Tommy270502/PM3/3_Technical_Documents/PCB/PM3_Audio_and_DMX_Template/PM3_Audio_and_DMX_Template/PM3_Audio_and_DMX_back.jpg

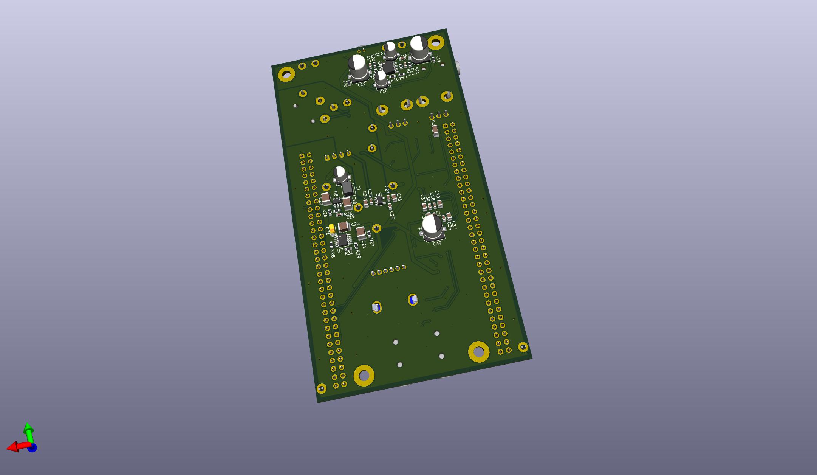
3_Technical_Documents/PCB/PM3_Audio_and_DMX_Template/PM3_Audio_and_DMX_Template/PM3_Audio_and_DMX_back.jpg
