Tommy270502/PM3/2_Assessments/Presentation.pptx

## Audio Processing and Ambient Light Control Device

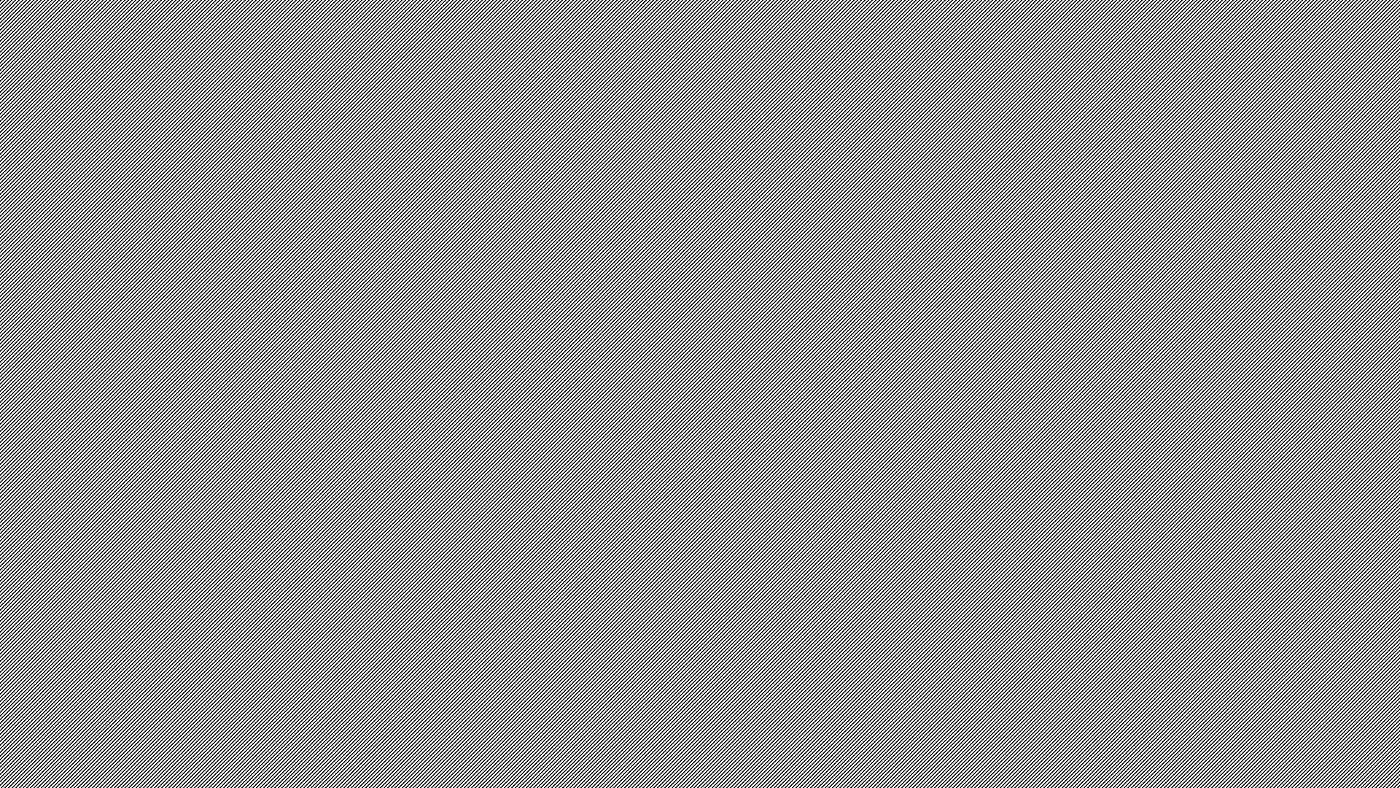
[picture p18: figure]

Bogdans Grebnevs – Thomas S. Perri

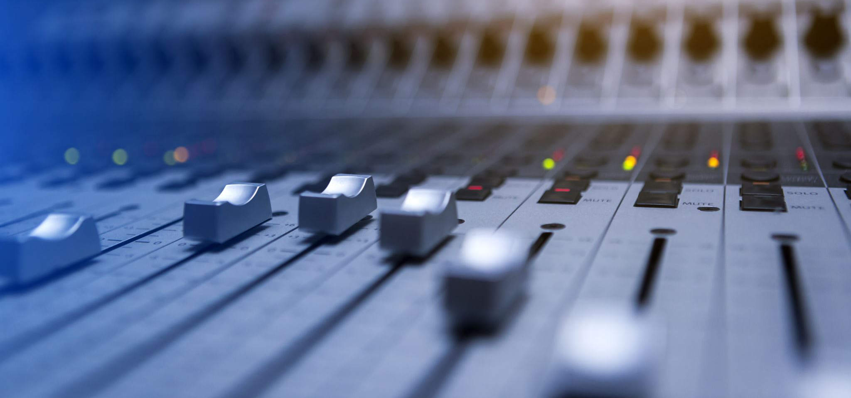
[picture p19: figure]
Audio sound board
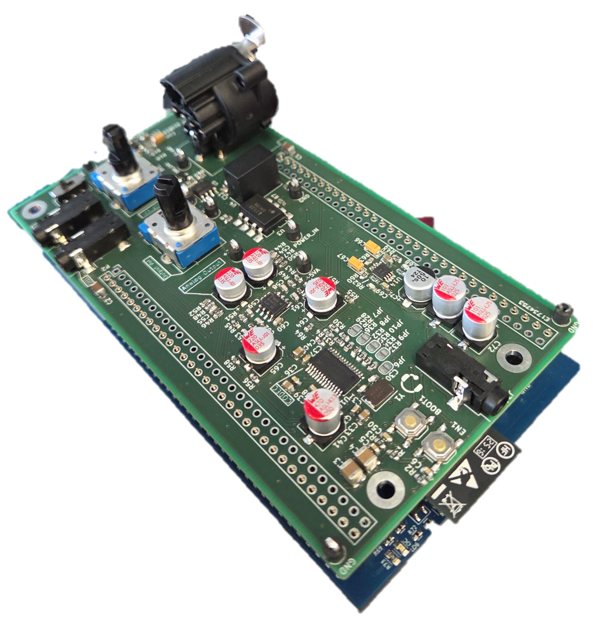
[picture p20: figure]

Notes: One-sentence purpose: A real-time system that processes audio signals, visualizes them, and drives ambient lighting.

## System Overview & Signal Flow

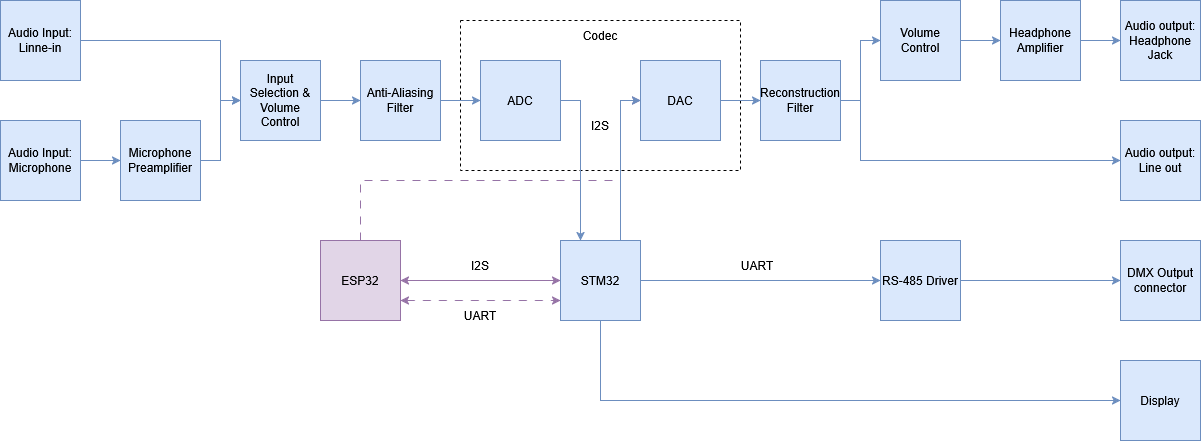
[picture p21: figure]

## Analog Front-End & Output Path

- Anti-aliasing Filter

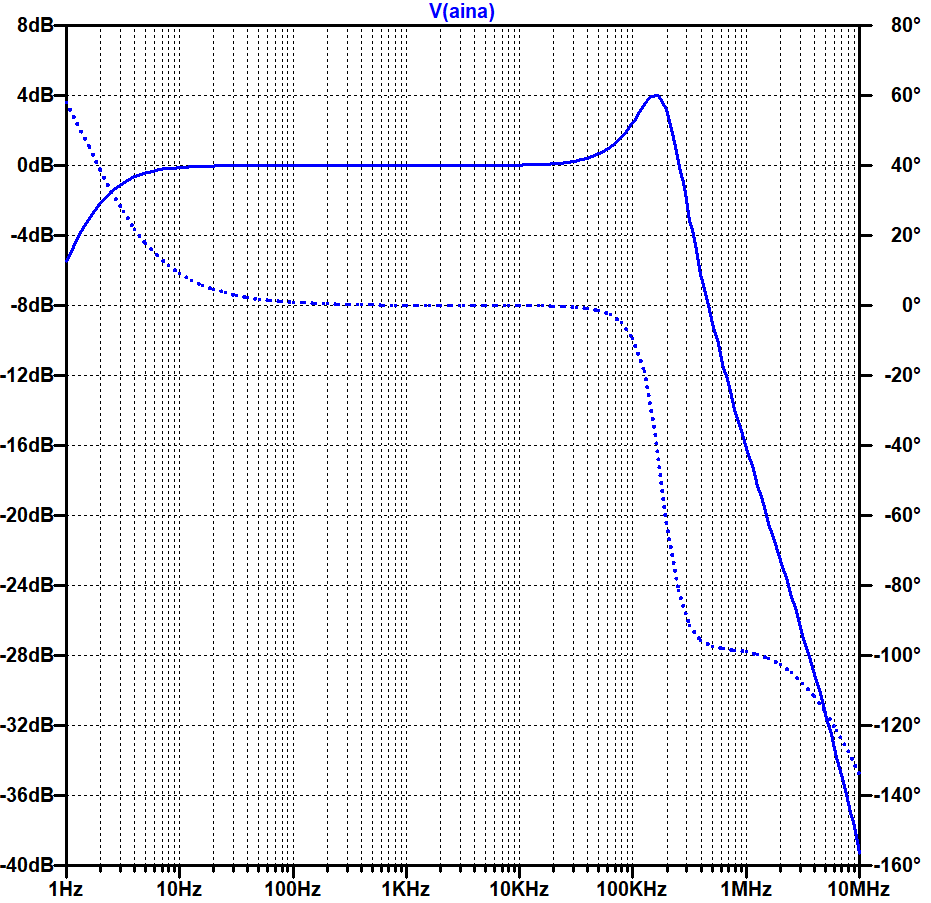
[picture p22: figure]

- Reconstruction Filter

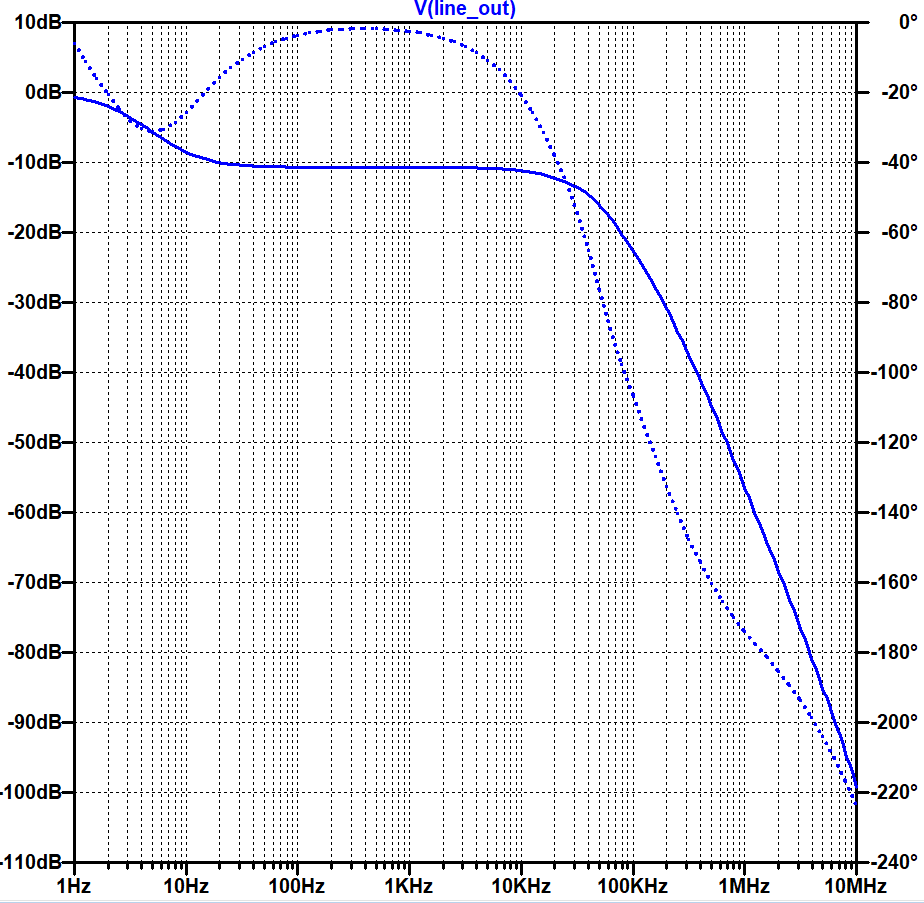
[picture p23: figure]

## Digital Signal Processing & Analysis

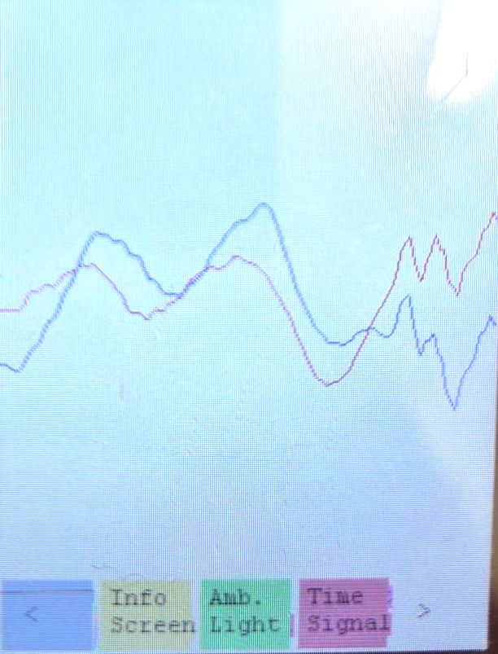
[picture p24: figure]
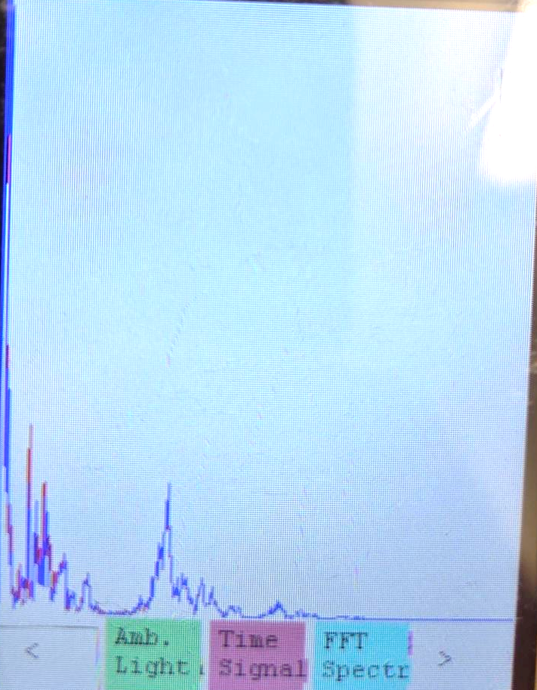
[picture p25: figure]

Notes: Buffer ping pong zeugs

## Ambient Light Control

Freuqency based color selection

0 Hz 250 Hz | 2 kHz | 4 kHz | 20 kHz

Brightness dictated by the RMS value of given frequency bin

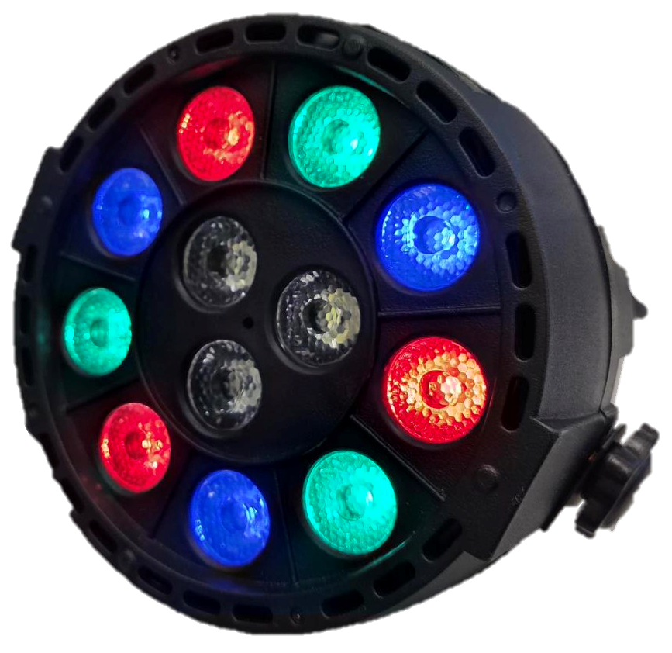
[picture p26: figure]

## Highlight: Audio Effects & Filter Menu

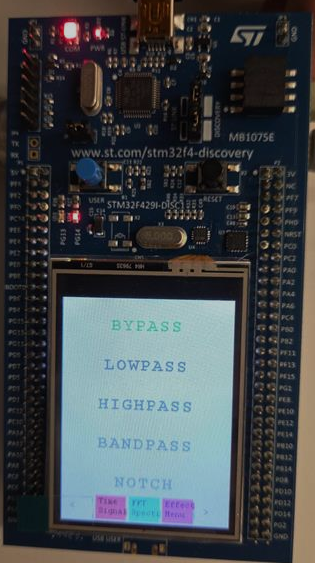
[picture p27: figure]

- Simple audio filters
  - Low-Pass
  - High-Pass
  - Band-Pass
  - Notch
- Select on the fly with the blue user button

## Conclusion

- Failures
  - Schematic capture errors → many wire modifications on PCB
- Learnings
  - Check HW multiple times and take time to review it to avoid having to troubleshoot later during testing
  - Proper layouting techniques and rules for PCBs
  - Improved confidence in firmware development
  - Project management and planning
- Future steps
  - Finish the ESP32 firmware to allow for Bluetooth audio receive/transmit

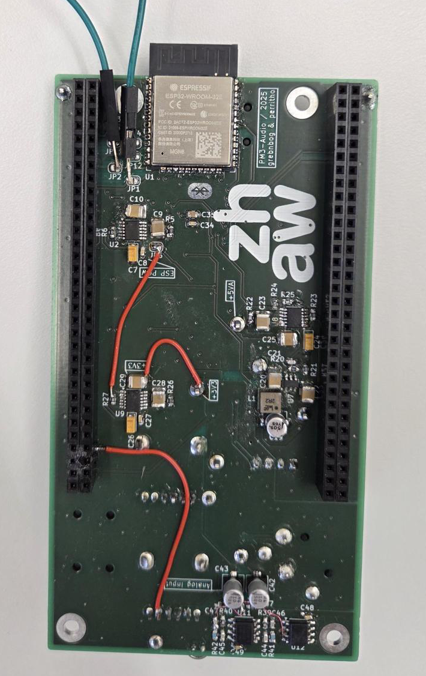
[picture p28: figure]
