Tommy270502/PM3/3_Technical_Documents/Audio_Signal_Analysis/Amplitude_Frequency_V2.docx

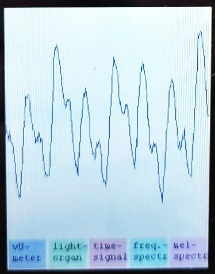
[picture p44: figure]
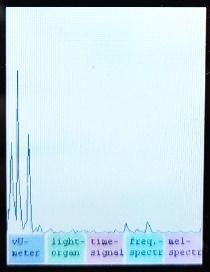
[picture p45: figure]
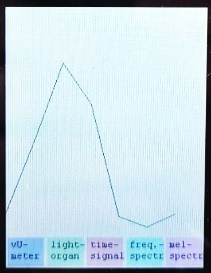
[picture p46: figure]

# Amplitude and Frequency

For the Electronics Projects

# Abstract

The Audio Level Meter is an indicator for the amplitude of the sound signal. For the ambient light, the amplitude in different frequency bands is analyzed and mapped to a specific color and intensity. This document presents different approaches to calculate amplitude, to implement bandpass filters, to map frequency spectrum to mel scale, and to realise average and peaks detection filters.

# 1. Introduction

An Audio Level Meter measures the amplitude of an audio signal and displays a representation of the signal level. There are different implementations possible, focusing on various aspects of an audio signal. Back in the analog days, the ubiquitous “VU-Meter” (for Volume Unit) was an analog circuit showing the average signal level on a galvanometer with a defined integration time of ~300 ms (See https://en.wikipedia.org/wiki/VU_meter). Nowadays, digital audio level meters exist in a multitude of variations, like PPM (Peak Program Meter), indicating signal peaks, RMS meters, or LUFS meters for loudness normalization, or even digital VU meters.

While in analog VU meters, electromechanical instruments (galvanometers) do the averaging, rise and fall time by its inertia, this has to be implemented in software for digital VU meters. The advantage is that not only the average can be displayed but also the peak.

For the ambient light, not only the amplitude but also the frequency spectrum is analyzed and translated into light effects with changing colors and intensity.

In its simplest implementation, bass sounds activate a red light, low midrange (fundamental frequency of vocals and instruments) a green light, upper midrange (harmonics) a blue light and treble (presence) a white light with the intensity depending on the sound amplitude in the respective frequency range.

As discussed in SamplingFrequency_BlockLength.docx for the Ambient Light and Audio Level Meter, a good choice would be a sampling block length of around 50ms.

# 2. Calculate the Signal Amplitude

The signal amplitude can directly be used for the audio level meter.

For the Ambient Light the amplitudes of the signal in different frequency ranges are used.

## 2.1. Peak-to-Peak Value

The peak-to-peak value is easy to calculate. In a for-loop, the maximum and minimum can be determined over all the samples (or the efficient CMSIS functions arm_min_f32 and arm_max_f32 can be used). PeakPeak = Max - Min

The peak-to-peak value, however, is very susceptible to noise, and also registers very short peaks, which are indeed of interest for the Peak detection, but less for average audio level.

## 2.2. Root-Mean-Square of AC portion

Better than the peak-to-peak value of a signal is the root-mean-square value because it measures the power of the signal, which corresponds better to the perceived loudness. Furthermore, noise and glitches are mostly suppressed.

The DC-offset must first be removed to get the RMS value of the AC portion only.

The DC offset is equal to the mean value of the signal: μ= 1/N∑_(k=0)^(N-1) x[k]

RMS_(AC) = √(1/N∑_(k=0)^(N-1) [x[k]- μ]^2)

By the way: This corresponds to the standard deviation of the signal.

RMS_(AC) = √(1/N∑_(k=0)^(N-1) [x[k]- μ]^2)= √(Var(x))=σ(x)

# 3. Calculate the Frequency Spectrum

Basically, the signal components are split into the respective frequency ranges by the means of bandpass filters before the amplitude is evaluated.

## 3.1. Analogue Bandpass Filters

The input signal is used as input for four bandpass filters with the following frequency ranges:

Bass: lower than 250 Hz
Low midrange: 250 Hz to 2 kHz
Upper midrange: 2 kHz to 4 kHz
Treble: higher than 4 kHz

In fact, light-organs in the 1970s were built using such bandpass filters, followed by a rectifier, a Schmitt-trigger, and a power-semiconductor to switch the colored lights.

## 3.2. Digital Bandpass Filters

When a microcontroller is used, the bandpass filters can be realized digitally, thus reducing HW cost.

The amplitude on each filter output can easily be calculated and used to adjust the brightness of the colored light channels.

The DSP library for the microcontroller has these highly optimized functions for filtering in the time-domain:

- FIR filter: arm_fir_init_f32() and arm_fir_f32()
- IIR: arm_biquad_cascade_df2T_init_f32() and arm_biquad_cascade_df2T_f32()

The documentation of the DSP library is in the file index.html in the folder Drivers/CMSIS/docs/DSP/html

## 3.3. Combined Bandpass Filtering and RMS-Calculation with Fast-Fourier-Transform

The fast-fourier-transform (FFT) implements a set of bandpass filters and directls outputs the rms-value for each frequency component.

The DSP library for the microcontroller has these highly optimized functions for the real fft:

- Real FFT spectrum calculation: arm_rfft_fast_init_f32() and arm_rfft_fast_f32() Supported FFT lengths are 32, 64, 128, 256, 512, 1024, 2048, 4096.

Whereas the invocation of the fft is simple and straightforward, the fft bandpass filters do not directly map to the desired frequency ranges for the light channels. An example might illustrate that:

Given values:

Sampling frequency fs = 48 kHz
Number of samples N = 1024

Calculated FFT values:

Frequency resolution ∆f = fs/N = 46.9 Hz
Frequency range fnyquist = fs/2 = 24 kHz (= theoretical limit)
Sampling Block length T = N*Ts = N/fs = 1/∆f = 21.3 ms

FFT outputs the rms-value of N/2 = 512 bandpasses, each with bandwidth ∆f = fs/N = 46.9 Hz
Note: FFT stands here for the magnitude of the complex value.

FTT[0] = DC-offset (should be 0 for an audio signal)
FFT[1] = rms-value of bandpass output with center-frequency of 46.9 Hz
FFT[2] = rms-value of bandpass output with center-frequency of 93.8 Hz
FFT[3] = rms-value of bandpass output with center-frequency of 140.6 Hz

..
FFT[126] = rms-value of bandpass output with center-frequency of 23’906 Hz
FFT[511] = rms-value of bandpass output with center-frequency of 23’953 Hz

Now map the FFT outputs to the light channel frequency ranges:

Bass: lower than 250Hz => FFT[1], FFT[2], .. , FFT[6]
Low midrange: 250Hz to 2kHz => FFT[7], FFT[8], .. , FFT[43]
Upper midrange: 2kHz to 4kHz => FFT[44], FFT[45], .. , FFT[85]
Treble: higher than 4kHz => FFT[86], FFT[87], .. , FFT[511]

And calculate the rms value of a whole range:

rms(bass) = √∑(FFT[1]² + FFT[2]² + .. +FFT[6]²)
rms(lowmidrang) = √∑(FFT[7]² + FFT[8]² + .. +FFT[43]²)
rms(uppermidrange) = √∑(FFT[44]² + FFT[45]² + .. +FFT[85]²)
rms(treble) = √∑(FFT[86]² + FFT[87]² + .. +FFT[511]²)

For the Ambient Light one can freely adapt the mapping of the frequencies and the scaling of the amplitudes as to best suit one’s own wishes and ideas. Some interpretations are here:

https://www.youtube.com/watch?v=x5hGF7NsG7Q&t=189s

https://www.youtube.com/watch?v=jyoptNEy7ks&t=114s

https://www.youtube.com/watch?v=oS4WiDS9gYs&t=84s

# 4. MEL Scale (after the word melody)

Human hearing perception (similar as for the other senses) follows a logarithmic scale. This makes it possible to hear a whispering voice and to have discussions even in heavy traffic noise.

This links has more information on this fact: https://en.wikipedia.org/wiki/Loudness

The sound pressure level is measured in the logarithmic dB scale.

And the frequency axis is also logarithmic. That makes sense as the frequency of the harmonics (in voice and instruments) are often integer multiples of the fundamental frequency. Equal factors in linear scale correspond to equal distances in logarithmic scale.

The mel scale maps frequencies in Hz to mel: https://en.wikipedia.org/wiki/Mel_scale

For light-organs it seems obvious that it is advantageous use the mel scale for color mapping.

A simple but not entirely correct approach for mapping the linear fft frequency axis to the roughly logarithmic mel scale is shown for the above example:

Mel[0] = √∑(FFT[1]²) = FFT[1] = 39Hz = Sub bass
Mel[1] = √∑(FFT[2]² + FFT[3]²) = 78Hz .. 117Hz = Bass
Mel[2] = √∑(FFT[4]² + FFT[5]² + .. + FFT[7]²) = 156Hz .. 273Hz = Bass
Mel[3] = √∑(FFT[8]² + FFT[9]² + .. + FFT[15]²) = 313Hz .. 586Hz = Low mid
Mel[4] = √∑(FFT[16]² + FFT[16]² + .. + FFT[31]²) = 625Hz .. 1211Hz = Midrange
Mel[5] = √∑(FFT[32]² + FFT[32]² + .. + FFT[63]²) = 1250Hz .. 2461Hz = Upper mid
Mel[6] = √∑(FFT[64]² + FFT[64]² + .. + FFT[127]²) = 2500Hz .. 4961Hz = Treble

# 5. Rise and Fall Time, Peaks and Averages

Because amplitude and frequency of music fluctuate considerably the question arises if peaks or averages are a better measure for loudness or signal level. The answer is: it depends on the application.

For a long time (when audio was stored on analog media, such as magnetic tape), a broadly accepted answer was the standard for VU meters (see: https://en.wikipedia.org/wiki/VU_meter ). The averages are displayed with a rise and fall time of 300ms.

In the digital domain, rise and fall times can be implemented by moving average filters.

For digital audio, other aspects get more important, such as peak detection (to avoid hard clipping) or the spectrally weighted, integrated loudness measure LUFS, which is used to normalize the perceived loudness of music on many broadcast and streaming services (see https://en.wikipedia.org/wiki/LUFS and also https://en.wikipedia.org/wiki/Loudness_war).

## 5.1. Moving Average Filter

A common approach for implementing a moving average filter for a digital audio level meter in firmware uses a first order IIR filter with a so-called forgetting factor. The implementation is very simple and uses this recursive formula:

y(n) = (1 - λ) * y(n-1) + λ * x(n)
Where:
x(n) = rms value of newly sampled block (26ms in the example above)
y(n-1) = rms-value of last average
y(n) = rms-value of new average
λ = forgetting factor
If λ is small the moving average changes slowly
If λ is big new values have a bigger influence and the average adjusts faster

See https://blog.embeddedexpert.io/?p=734 for details of a STM32 implementation. Note: Here they use different symbols for the forgetting factor λ inconsistently: γ, a or alpha

## 5.2. Peak Detection Filter

While mechanical VU meters have been replaced by electronic circuitry and software implementations, the relevance of the peaks has dramatically increased for avoiding clipping of the signal. The implementation of a peak detector is similar to and as simple as the moving average filter:

y(n) = (1 - λ) * y(n-1) => Slowly forget the old peak value
if x(n) > y(n) then y(n) = x(n) => A new peak has been detected
Where:
x(n) = peak value of newly sampled block (26ms in the example above)
y(n-1) = last peak value
y(n) = new peak value
λ = forgetting factor (often bigger compared to that for the moving average)
Note: To reduce sensitivity on spikes often the rms value of a sampled block is used instead of the peak value.

Amplitude_Frequency.docx 8 of 8 Hanspeter Hochreutener (hhrt) Josquin Rosset (rost) Patrick Rennhard (renn)
