Tommy270502/PM3/2_Assessments/FW_block_diagram.drawio.png

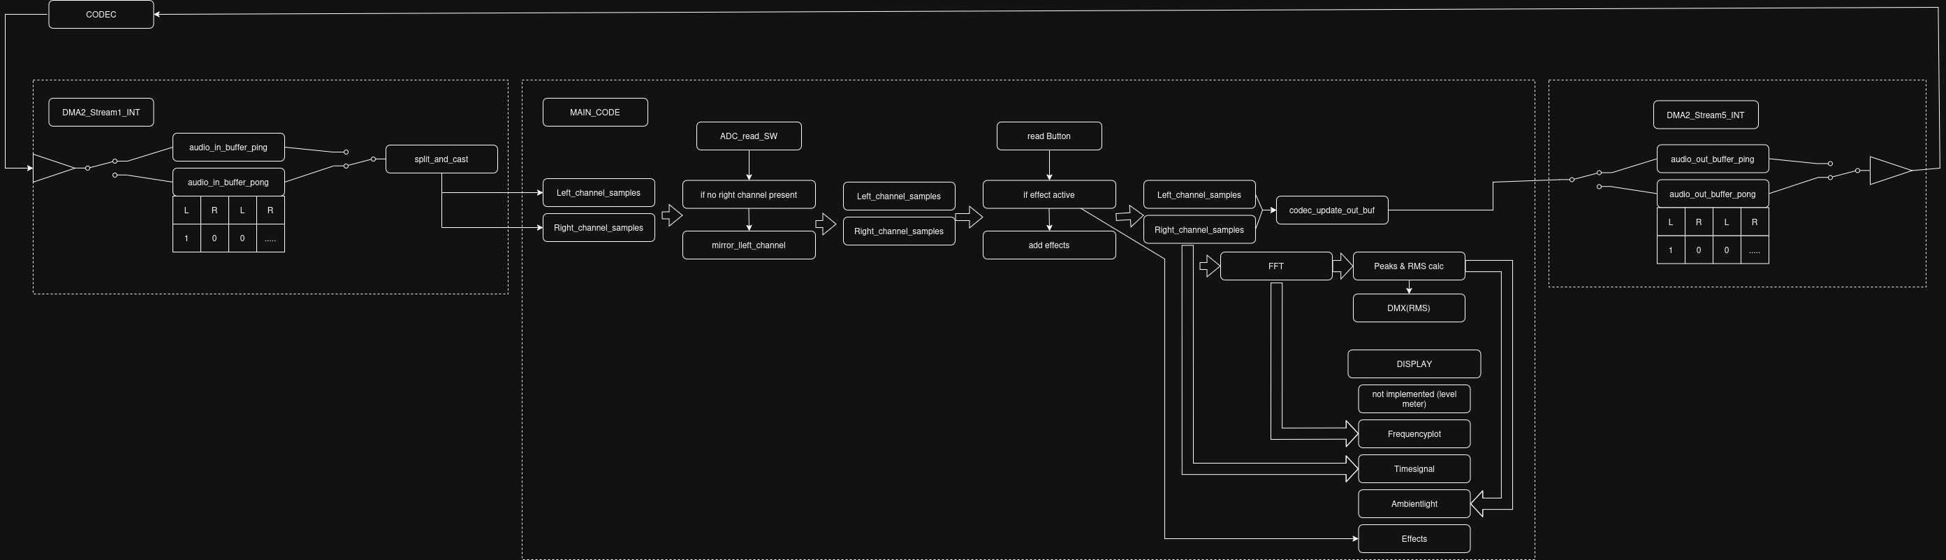
2_Assessments/FW_block_diagram.drawio.png
