Tommy270502/PM3/3_Technical_Documents/DMX/Annotated_trace_of_DMX-512_signal.png

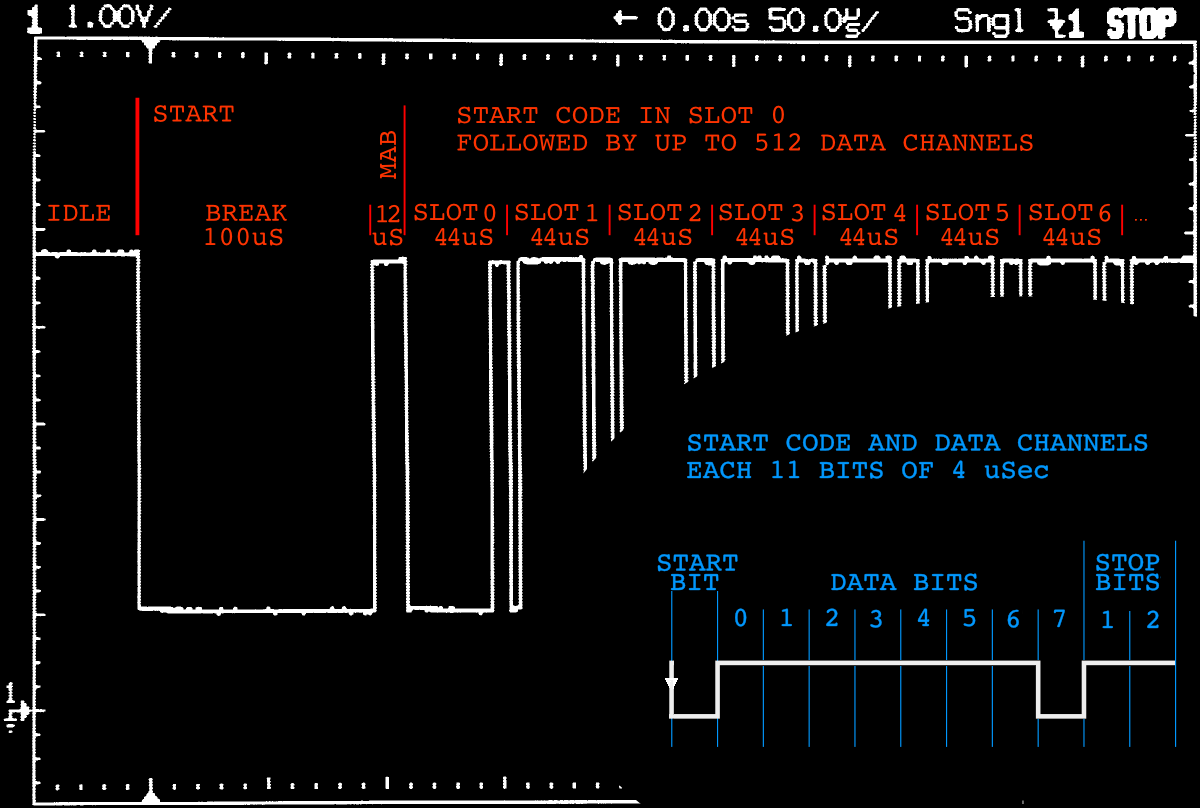
3_Technical_Documents/DMX/Annotated_trace_of_DMX-512_signal.png
