Tommy270502/PM3/3_Technical_Documents/DMX/DMX-Arduino.png

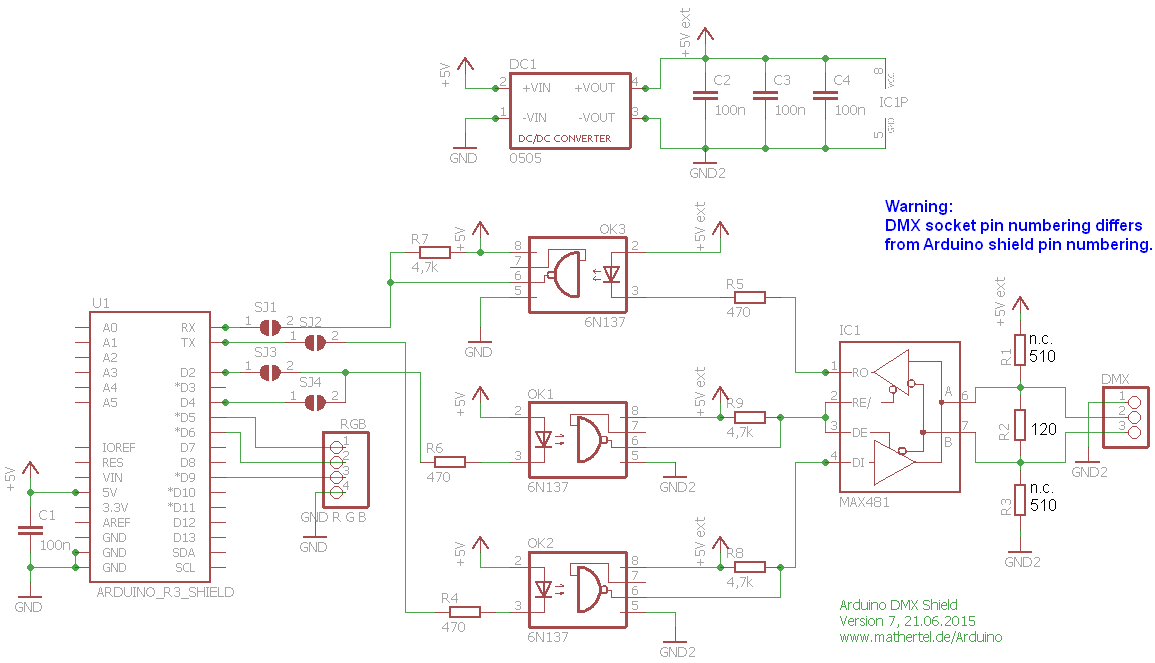
3_Technical_Documents/DMX/DMX-Arduino.png
