Tommy270502/PM3/3_Technical_Documents/PCB/PM3_Audio_pre_ordered_components.xlsx

PM3_Audio_and_DMX_2
Reference | Value | Datasheet | Footprint | Qty | MPN | Manufacturer | Distributor | Part Number | Descritpion
C1,C2 | 100uF | ~ | Capacitor_SMD:C_1206_3216Metric_Pad1.33x1.80mm_HandSolder | 2 | C3216X5R1A107M160AC |  | Mouser | 810-C3216X5R1A107M | Kondensator aus mehreren Keramikschichten MLCC - SMD/SMT 1206 10V 100uF X5R 20% T: 1.6mm
C3,C4 | 10uF | ~ | Capacitor_SMD:C_0805_2012Metric_Pad1.18x1.45mm_HandSolder | 2 | GPC0805106-35 |  | Mouser | 187-CL21B106KOQNNNE | MLCC - SMD/SMT 10uF+/-10% 16V X7R 2012
C5 | 100n | ~ | Capacitor_SMD:C_0805_2012Metric_Pad1.18x1.45mm_HandSolder | 1 | GPC0805104 |  | Mouser | 187-CL21B104KACNFNC | MLCC - SMD/SMT 100nF+/-10% 25V X7R 0805
C6 | 2.2u | ~ | Capacitor_SMD:C_0805_2012Metric | 1 | GPC0805225-25-X7R |  | Mouser | 187-CL21B225KOFNNNG | MLCC - SMD/SMT 2.2uF+/-10% 16V X7R 0805
C7,C10 | 4.7u TANT | ~ | Capacitor_Tantalum_SMD:CP_EIA-3216-18_Kemet-A | 5 | T495A475K010ATE1K3 | Kemet | Mouser | 80-T495A475K10ATE1K3 | Tantalkondensatoren - fest für SMD 10V 4.7uF 1206 10% ESR=1.3Ohms
C8 | 15p COG | ~ | Capacitor_SMD:C_0603_1608Metric | 1 | GPC0603150 |  | Mouser | 581-06031U150FAT2A | Keramikschichten MLCC - SMD/SMT 100V 15pF C0G 0603 1 % Tol
C9,C16,C25,C29,C30,C32,C36,C38,C40, C23,C63,C64, C68 | 100n | ~ | Capacitor_SMD:C_0603_1608Metric | 10 | GPC0603104-X7R |  | Mouser | 581-0603YC104K4T4A | Kondensator aus mehreren Keramikschichten MLCC - SMD/SMT KAM15AR71C104KM NW G LOB PN 16V 0.1uF X7R
C11, C17, C18 | 1u | ~ | Capacitor_SMD:CP_Elec_4x5.4 | 3 | EEE1HA010SR | Panasonic | Mouser | 667-EEE-1HA010SR | Alu-Elektrolytkondensatoren - SMD 1UF 50V VS SMD
C12,C13,C41 | 47u | ~ | Capacitor_SMD:CP_Elec_6.3x7.7 | 3 | 865080645012 | Wurth Elektronik | Mouser | 710-865080645012 | Alu-Elektrolytkondensatoren - SMD WCAP-ASLI 47uF 50V 20% SMD/SMT
C14,C15 | 10p | ~ | Capacitor_SMD:C_0603_1608Metric | 2 | GPC0603100 |  | Mouser | 77-VJ0603A100FXACBC | MLCC - SMD/SMT 0603 10pF 50volts C0G 1%
C19,C21,C24 | 10u CER | ~ | Capacitor_SMD:C_1210_3225Metric | 3 | GPC1210106 |  | Mouser | 187-CL32B106KLJNNNE | MLCC - SMD/SMT 10uF+/-10% 35V X7R 3 1210
C20, C54,C56, C44,C45 | 470pF COG | ~ | Capacitor_SMD:C_0603_1608Metric | 5 | GPC0603471 |  | Mouser | 81-GCM1885C2A471FA6D | MLCC - SMD/SMT 470 pF 100 VDC 1% 0603 C0G (NP0) AEC-Q200
C22 | 4.7u CER | ~ | Capacitor_SMD:C_1210_3225Metric | 1 | GPC1210475 |  | Mouser | 187-CL32B475KBUYNNE | MLCC - SMD/SMT 4.7uF+/-10% 50V X7R 1210
C24 | 10u CER (rec. Murata GJ8) | ~ | Capacitor_SMD:C_1210_3225Metric | 1 | GJ832ER7YA106KA12L | Murata | Mouser | 81-GJ832ER7YA106KA2L (nicht lieferbar) 81-GRM32ER7YA106KA2L | Kondensator aus mehreren Keramikschichten MLCC - SMD/SMT 10 uF 35 VDC 10% 1210 X7R
C26,C28,C67, C31,C35,C37,C39 | 1u CER | ~ | Capacitor_SMD:C_0805_2012Metric | 7 | GPC0805105 |  | Mouser | 187-CL21B105KBFNNNE | MLCC - SMD/SMT 1uF+/-10% 50V X7R 2012
C27, C48,C49,C62 | 10n COG/X7R | ~ | Capacitor_SMD:C_0603_1608Metric | 4 | GPC0603103-X7R |  | Mouser | 81-GRM1885C1H103JA1J | MLCC - SMD/SMT 0.01 uF 50 VDC 5% 0603 C0G (NP0)
C33,C34 | 39p COG | ~ | Capacitor_SMD:C_0603_1608Metric | 2 | 06035A390FAT2A | AVX | Mouser | 581-06035A390FAT2A | PN 50V 39pF C A
C42,C43 | 10u | ~ | Capacitor_SMD:CP_Elec_4x5.8 | 2 | VZT100M1HTR | Panasonic | Mouser | 140-VZT100M1HTR-0406 | Elektrolytkondensatoren - SMD 10uF 20% 50V Ultra Low ESR
C46,C47 | 2n7 COG | ~ | Capacitor_SMD:C_0603_1608Metric | 2 | GRM1885C1H272JA01D | Murata | Mouser | 81-GRM185C1H272JA01D | MLCC - SMD/SMT 2700 pF 50 VDC 5% 0603
C50,C52 | 2.2nF COG | ~ | Capacitor_SMD:C_0603_1608Metric | 2 |  |  | Mouser | 81-GCM1885C1H222FA6D | MLCC - SMD/SMT 2200 pF 50 VDC 1% 0603 C0G (NP0) AEC-Q200
C51,C53 | 6.8nF COG | ~ | Capacitor_SMD:C_0603_1608Metric | 2 | GPC0603222-C0G |  | Mouser | 81-GRM1885C1H682JA1D | MLCC - SMD/SMT 6800 pF 50 VDC 5% 0603 C0G (NP0)
C55,C58,C60,C61 | 22u | ~ | Capacitor_SMD:CP_Elec_6.3x7.7 | 4 | 865060543003 | Wurth Elektronik | Mouser | 710-865060543003 | Alu-Elektrolytkondensatoren - SMD WCAP-ASLL 22uF 35V 20% SMD/SMT
C57,C59 | 1.5nF COG | ~ | Capacitor_SMD:C_0603_1608Metric | 2 | GPC0603152 |  | Mouser | 81-GCM1885C1H152FA6D | MLCC - SMD/SMT 1500 pF 50 VDC 1% 0603 C0G (NP0) AEC-Q200
C65,C66 | 5p COG | ~ | Capacitor_SMD:C_0603_1608Metric | 2 | 06035A5R0CAT2A | AVX | Mouser | 581-06035A5R0C | MLCC - SMD/SMT 50V 5pF C0G 0603 0.2 5pF A
C69,C70 | 100u | ~ | Capacitor_SMD:CP_Elec_6.3x7.7 | 2 | 865060445005 | Wurth Elektronik | Mouser | 710-865060445005 | SMD WCAP-ASLL 100uF 25V 20% SMD/SMT
C71 | 10u | ~ | Capacitor_SMD:CP_Elec_6.3x7.7 | 1 | EEE-1HA100AP | Panasonic | Mouser | 667-EEE-1HA100AP | Alu-Elektrolytkondensatoren - SMD 10UF 50V VS SMD
D1 | ESDA5V3L | https://www.st.com/resource/en/datasheet/esdal.pdf | Package_TO_SOT_SMD:SOT-23-3 | 1 | ESDA5V3L | STMicroelectronics | Mouser | 511-ESDA5V3L | ESD-Schutzdioden / TVS-Dioden 5.3V 300W Unidirect
J1 | DMX-out | https://www.neutrik.com/en/product/nc3faah2 | Connector_Audio:Jack_XLR_Neutrik_NC3FAAH2_Horizontal | 1 |  |  | Mouser Farnell | 568-NC3FAAH-2 1310023 | XLR-Anschlüsse 3P FEMALE HORIZ PIN 1 & GRD SEPARATE mit Latch
J2, J3, J4 | LINE_IN, LINE_OUT, Headphone | ~ | Connector_Audio:Jack_3.5mm_CUI_SJ-3523-SMT_Horizontal | 3 | SJ-3523-SMT-TR | CUI | Mouser | 490-SJ-3523-SMT-TR | Telefon-Steckverbinder Audio Jacks
L1 | 74438357022 | ~ | Inductor_SMD:L_Wuerth_MAPI-4030 | 1 | 74438357022 | Wurth Elektronik | Mouser | 710-74438357022 | Leistungsinduktivitäten – SMD WE-MAPI 2.2uH 5.2A DCR=26mOhms AEC-Q200
MK1 | POM-3535P-R | ~ | Sensor_Audio:POM-2244P-C3310-2-R | 1 |  |  | Mouser | 665-POM-3535P-3-R | Mikrofone MICROPHONE -35 DB 2 VDC .5 MA 2.2 KOHM
P1,P2 | Conn_02x32_Odd_Even | ~ | Connector_PinSocket_2.54mm:PinSocket_2x32_P2.54mm_Vertical | 2
R2 | 270 | ~ | Resistor_SMD:R_0603_1608Metric | 1 | RC0603FR-13270RL | Yageo | Mouser | 603-RC0603FR-13270RL | Thick Film Resistors General Purpose Chip Resistor 0603, 270Ohms, 1%, 1/10W
R3 | 4.7k | ~ | Resistor_SMD:R_0603_1608Metric | 1 | CR0603-FX-4701ELF | Bourns Inc. | Mouser | 652-CR0603FX-4701ELF | Thick Film Resistors 4.7K ohm 1%
R4 | 270 | ~ | Resistor_SMD:R_0805_2012Metric | 1 | CRGCQ0805F270R | TE Connectivity / Holsworthy | Mouser | 279-CRGCQ0805F270R | Thick Film Resistors CRGCQ 0805 270R 1% SMD Resistor
R5,R7 | 510_nc | ~ | Resistor_SMD:R_0603_1608Metric | 2 | RC0603FR-13510RL | Yageo | Mouser | 603-RC0603FR-13510RL | Thick Film Resistors General Purpose Chip Resistor 0603, 510Ohms, 1%, 1/10W
R6 | 120 | ~ | Resistor_SMD:R_1206_3216Metric | 1 | RC1206FR-10120RL | Yageo | Mouser | 603-RC1206FR-10120RL | Thick Film Resistors General Purpose Chip Resistor 1206, 120Ohms, 1%, 1/4W
R10 | 0 | ~ | Resistor_SMD:R_0603_1608Metric | 1 | RC0603FR-100RL | Yageo | Mouser | 603-RC0603FR-100RL | Thick Film Resistors General Purpose Chip Resistor 0603, 0Ohms, 1%, 1/10W
R11 | 5.9k | ~ | Resistor_SMD:R_0603_1608Metric | 1 | RT0603FRE075K9L | Yageo | Mouser | 603-RT0603FRE075K9L | Dünnfilmwiderstände - SMD 1/10W 5.9K ohm 1% 50ppm
R12,R13,R16,R23,R24,R43,R44,R45,R48,R49,R74 | 100k | ~ | Resistor_SMD:R_0603_1608Metric | 11 | AC0603FR-10100KL | Yageo | Mouser | 603-AC0603FR-10100KL | Thick Film Resistors 100 kOhms 1/10 W 75 V 1% 0603 100 PPM / C - 55 C / + 155 C AEC-Q200
R14 | 75k THIN FILM | ~ | Resistor_SMD:R_0603_1608Metric | 1 | RT0603FRE1075KL | Yageo | Mouser | 603-RT0603FRE1075KL | Thin Film Resistors 75K ohm 1% 50 ppm Thin Film
R15 | 49.9 | ~ | Resistor_SMD:R_0603_1608Metric | 1 | RT0603FRE0749R9L | Yageo | Mouser | 603-RT0603FRE0749R9L | Thin Film Resistors 1/10W 49.9 ohm 1% 50 ppm
R17,R18 | 22k | ~ | Resistor_SMD:R_0603_1608Metric | 2 | RC0603FR-1022KL | Yageo | Mouser | 603-RC0603FR-1022KL | Thick Film Resistors General Purpose Chip Resistor 0603, 22kOhms, 1%, 1/10W
R19,R20,R28 | 200k | ~ | Resistor_SMD:R_0603_1608Metric | 3 | WR06X2003FTL | Walsin | Mouser | 791-WR06X2003FTL | Thick Film Resistors 0603 200K 1% Lead Free
R21,R22,R33,R34,R42, R48, R49 | 10k | ~ | Resistor_SMD:R_0603_1608Metric | 7 | RMCF0603FG10K0 | SEI Stackpole | Mouser | 708-RMCF0603FG10K0 | Thick Film Resistors 10KOhms 0603 0.1W 0.01 Std Power
R25 | 330k | ~ | Resistor_SMD:R_0603_1608Metric | 1 | CRG0603F330K | TE Connectivity / Holsworthy | Mouser | 279-CRG0603F330K | Thick Film Resistors 330KOhms 1/10W 50V
R26 | 30k | ~ | Resistor_SMD:R_0603_1608Metric | 1 | RC0603FR-1030KL | Yageo | Mouser | 603-RC0603FR-1030KL | Thick Film Resistors General Purpose Chip Resistor 0603, 30kOhms, 1%, 1/10W
R27 | 49.9k | ~ | Resistor_SMD:R_0603_1608Metric | 1 | RC0603FR-0749K9L | Yageo | Mouser | 603-RC0603FR-0749K9L | Chip Resistor 0603, 49.9kOhms, 1%, 1/10W
R29 | 698k | ~ | Resistor_SMD:R_0603_1608Metric | 1 | RC0603FR-07698KL | Yageo | Mouser | 603-RC0603FR-07698KL | Thick Film Resistors General Purpose Chip Resistor 0603, 698kOhms, 1%, 1/10W
R30 | 50k | ~ | Resistor_SMD:R_0603_1608Metric | 1 | RC0603FR-0749K9L | Yageo | Mouser | 603-RC0603FR-0749K9L | Chip Resistor 0603, 49.9kOhms, 1%, 1/10W
R31,R36,R37,R38,R39 | 22.1 | ~ | Resistor_SMD:R_0603_1608Metric | 5 | CR0603-FX-22R1ELF | Bourns Inc. | Mouser | 652-CR0603FX-22R1ELF | Thick Film Resistors 22.1 ohm 1%
R41,R68,R69 | 47k | ~ | Resistor_SMD:R_0603_1608Metric | 3 | AC0603FR-1047KL | Yageo | Mouser | 603-AC0603FR-1047KL | Thick Film Resistors 47 kOhms 1/10 W 75 V 1% 0603 100 PPM / C - 55 C / + 155 C AEC-Q200
R50,R51 | 634 | ~ | Resistor_SMD:R_0603_1608Metric | 2 | RC0603FR-07634RL | Yageo | Mouser | 603-RC0603FR-07634RL | Thick Film Resistors General Purpose Chip Resistor 0603, 634Ohms, 1%, 1/10W
R52,R53 | 90.9 | ~ | Resistor_SMD:R_0603_1608Metric | 2 | RK73H1JTTD90R9F | KOA Speer | Mouser | 660-RK73H1JTTD90R9F | Thick Film Resistors 1/10watt 90.9ohms 1%
R54,R56 | 4.42k | ~ | Resistor_SMD:R_0603_1608Metric | 2 | RC0603FR-074K42L | Yageo | Mouser | 603-RC0603FR-074K42L | Thick Film Resistors General Purpose Chip Resistor 0603, 4.42kOhms, 1%, 1/10W
R55,R57 | 1.33k | ~ | Resistor_SMD:R_0603_1608Metric | 2 | AC0603FR-071K33L | Yageo | Mouser | 603-AC0603FR-071K33L | Thick Film Resistors 1.33 kOhms 1/10 W 75 V 1 % 0603 100 PPM / C - 55 C / + 155 C AEC-Q200
R58,R61 | 2.32k | ~ | Resistor_SMD:R_0603_1608Metric | 2 | RC0603FR-072K32L | Yageo | Mouser | 603-RC0603FR-072K32L | Thick Film Resistors General Purpose Chip Resistor 0603, 2.32kOhms, 1%, 1/10W
R59,R62 | 715 | ~ | Resistor_SMD:R_0603_1608Metric | 2 | RMCF0603FT715R | SEI Stackpole | Mouser | 708-RMCF0603FT715R | Thick Film Resistors 715Ohms 0603 0.1W 0.01 Std Power
R60,R63 | 1.5k | ~ | Resistor_SMD:R_0603_1608Metric | 2 | RC0603FR-131K5L | Yageo | Mouser | 603-RC0603FR-131K5L | Thick Film Resistors General Purpose Chip Resistor 0603, 1.5kOhms, 1%, 1/10W
R64,R65 | 4.99k | ~ | Resistor_SMD:R_0603_1608Metric | 2 | RC0603FR-104K99L | Yageo | Mouser | 603-RC0603FR-104K99L | Thick Film Resistors General Purpose Chip Resistor 0603, 4.99kOhms, 1%, 1/10W
R66,R67 | 560 | ~ | Resistor_SMD:R_0603_1608Metric | 2 | RC0603FR-10560RL | Yageo | Mouser | 603-RC0603FR-10560RL | Thick Film Resistors General Purpose Chip Resistor 0603, 560Ohms, 1%, 1/10W
R70,R71 | 20k THIN FILM | ~ | Resistor_SMD:R_0603_1608Metric | 2 | RT0603FRE1020KL | Yageo | Mouser | 603-RT0603FRE1020KL | Thin Film Resistors 20K ohm 1% 50 ppm Thin Film
R72,R73 | 100k THIN FILM | ~ | Resistor_SMD:R_0603_1608Metric | 2 | RT0603FRE10100KL | Yageo | Mouser | 603-RT0603FRE10100KL | Thin Film Resistors 100K ohm 1% 50 ppm Thin Film
RV1,RV2 | 50k | ~ | Potentiometer_THT:Potentiometer_Bourns_PTV09A-1_Single_Vertical | 2 |  |  | Mouser | 652-PTV09A2020SA503 | Potentiometer PANEL CONTROL - 9MM-ST-CARBON
RV3 | 50k stereo | ~ | Potentiometer_THT:Potentiometer_Bourns_PTV112-4_Dual_Vertical | 1 |  |  | Mouser | 652-PTV112-4420AA503 | Potentiometer 50K AUDIO 20%
SW1,SW2, SW3 | SW_DPDT_x2 | ~ | Button_Switch_SMD:SW_DPDT_CK_JS202011JCQN | 3 | JS202011JCQN |  | Mouser | 611-JS202011JCQN | Schiebeschalter .3A 6VDC DPDT VERT MNT SMT J BEND
TP1,TP2,TP8,TP3,TP4,TP5,TP6,TP7,TP9,TP10,TP11,TP12,TP13,TP14 | … | ~ | TestPoint:TestPoint_Loop_D2.60mm_Drill1.6mm_Beaded | 14 |  |  | Mouser | 534-5006 | TEST POINT BLK .063
U1 | 6N136S | https://optoelectronics.liteon.com/upload/download/DS70-2008-0032/6N135-L%206N136-L%20series.pdf | Package_DIP:SMDIP-8_W9.53mm | 1 | 6N136S | ON Semiconductor | Mouser | 859-6N136S | Hochgeschwindigkeits-Optokoppler High Speed 1MBd Transistor Output
U2 | CRE1S0505SC | http://power.murata.com/datasheet?/data/power/ncl/kdc_cre1.pdf | Converter_DCDC:Converter_DCDC_Murata_CRE1xxxxxxSC_THT | 1 | CRE1S0505SC | Murata | Mouser | 580-CRE1S0505SC | Isolierte DC/DC-Wandler – Durchsteckmontage 1W 5-5V SIP SINGLE
U3 | ST485E | http://www.st.com/resource/en/datasheet/st485eb.pdf | Package_SO:SOIC-8_3.9x4.9mm_P1.27mm | 1 | ST485EBDR | ST Microelectronics | Mouser | 511-ST485EBDR | RS-422/RS- 485-Schnittstelle IC Hi-Spd Lo Pwr Trans
U4 | OPA322 |  | Package_TO_SOT_SMD:SOT-23-5 | 1 | OPA322AIDBVT | Texas Instruments | Mouser | 595-OPA322AQDBVRQ1 | Operationsverstärker Automotive-grade si ngle 5.5-V 20-MHz
U5,U10,U11,U12 | OPA2134 | http://www.ti.com/lit/ds/symlink/opa134.pdf | Package_SO:SOIC-8_3.9x4.9mm_P1.27mm | 4 | OPA2134UA | Texas Instruments | Mouser | 595-OPA2134UA/2K5 | Audioverstärker SoundPlus Hi-Perf Au d Oper Amp A 595-OPA2134UA
U6 | TLV61070ADBV | https://www.ti.com/lit/ds/symlink/tlv61070a.pdf | Package_TO_SOT_SMD:SOT-23-6 | 1 | TLV61070ADBVR | Texas Instruments | Mouser | 595-TLV61070ADBVR | Schaltspannungsregler 5-V 2-A boost conver ter with 0.5-V minim
U7 | LT3045xMSE | https://www.analog.com/media/en/technical-documentation/data-sheets/3045fa.pdf | Package_SO:MSOP-12-1EP_3x4.039mm_P0.65mm_EP1.651x2.845mm | 1 | LT3045EMSE | Linear Technology | Mouser | 584-LT3045EMSE#PBF 584-LT3045EMSE#TRPBF | LDO Spannungs-Regulator 20V, 500mA, Ultralow N, Ultrahigh PSRR L
U8 | LD3985M33R_SOT23 | http://www.st.com/internet/com/TECHNICAL_RESOURCES/TECHNICAL_LITERATURE/DATASHEET/CD00003395.pdf | Package_TO_SOT_SMD:SOT-23-5 | 1 | LD3985M33R | ST Microelectronics | Mouser | 511-LD3985M33R | LDO Spannungs-Regulator BICMOS VOLT REG
U9 | CS4271 | https://statics.cirrus.com/pubs/proDatasheet/CS4272_F1.pdf | Package_SO:TSSOP-28_4.4x9.7mm_P0.65mm | 1 | CS4271-CZZ | Cirrus Logic | Mouser | 777-CS4271K-CZZ | Schnittstelle - CODECs Stereo Audio CODEC 108 dB 192 kHz
U13 | TPA6110A2DGN | https://www.ti.com/lit/ds/symlink/tpa6110a2.pdf | Package_SO:HVSSOP-8-1EP_3x3mm_P0.65mm_EP1.57x1.89mm | 1 | TPA6110A2DGN | Texas Instruments | Mouser | 595-TPA6110A2DGNR | Audioverstärker Stereo Headphone Pin Compat w/LM4881 A 595-TPA6110A2DGN
Y1 | 24.576 MHz | 24.576 MHz ±20ppm Crystal 20pF 40 Ohms 2-SMD, No Lead | Crystal:Crystal_SMD_5032-2Pin_5.0x3.2mm | 1 | 445A22E24M57600 | CTS | Mouser | 774-445A22E24M57600 | Quarze 24.576MHz +/-20ppm 20pF -10C +60C
USB mini cable |  |  |  | 1 |  |  | Distrelec | 301-25-756 | USB-A-Anschluss auf USB-Mini-B-Anschlusskabel, 5-polig 1m Schwarz
