Tommy270502/PM3/3_Technical_Documents/PCB/PM3_Audio_and_DMX_Template/PM3_Audio_and_DMX_Template/downloaded_3d_models/Same_Sky_SJ-3523-SMT-TR.step

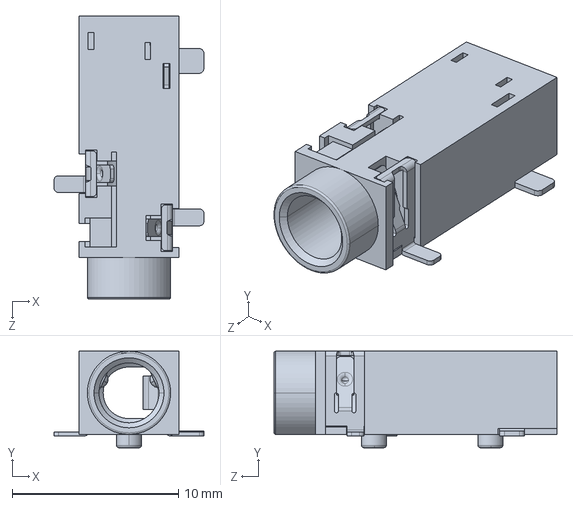
[picture p80: CAD file, 2025-10-03]
3_Technical_Documents/PCB/PM3_Audio_and_DMX_Template/PM3_Audio_and_DMX_Template/downloaded_3d_models/Same_Sky_SJ-3523-SMT-TR.step
9.00 x 5.80 x 17.0 mm
