Tommy270502/PM3/3_Technical_Documents/PCB/PM3_Audio_and_DMX_Template/PM3_Audio_and_DMX_Template/PM3_Audio_and_DMX.step

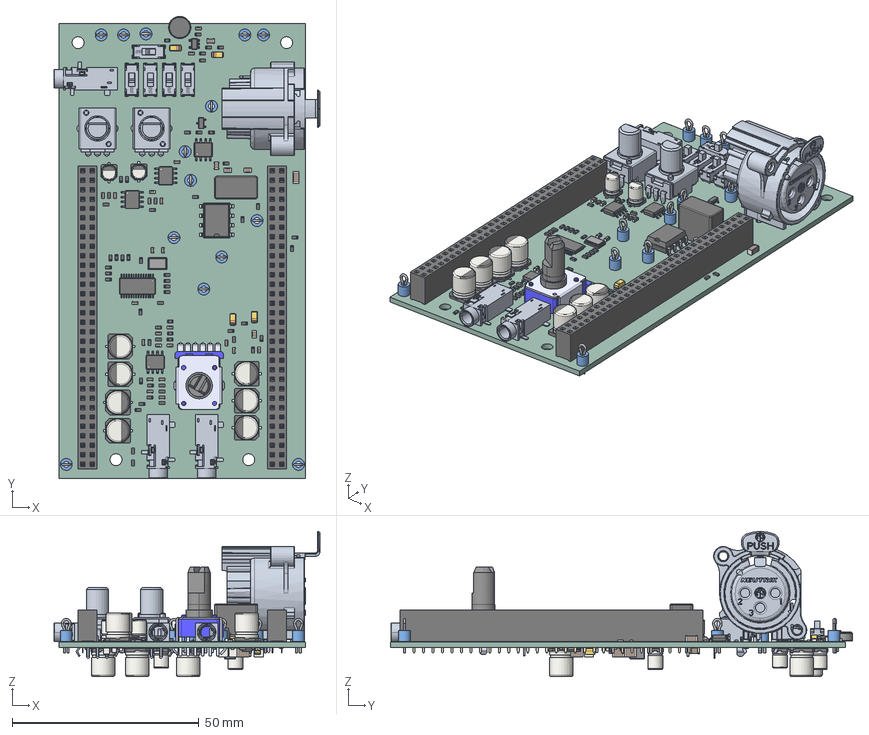
[picture p81: CAD file, 2025-10-03]
3_Technical_Documents/PCB/PM3_Audio_and_DMX_Template/PM3_Audio_and_DMX_Template/PM3_Audio_and_DMX.step
71.3 x 123.9 x 38.9 mm
C_0603_1608Metric x 34
R_0603_1608Metric x 70
Potentiometer_Bourns_PTV112-4_Dual_Vertical
Potentiometer_Bourns_PTV09A-1_Single_Vertical x 2
C_0805_2012Metric x 11
SW_DPDT_CK_JS202011JCQN x 5
CP_Elec_6.3x7.7 x 10
SOT-23-3
CP_Elec_4x5.8 x 4
Crystal_SMD_5032-2Pin_5.0x3.2mm
TestPoint_Loop_D2.60mm_Drill1.6mm_Beaded x 14
SOIC-8-1EP_3.9x4.9mm_P1.27mm_EP2.29x3mm x 4
CP_EIA-3216-18_Kemet-A x 5
SMDIP-8_W9.53mm
SOIC-8_3.9x4.9mm_P1.27mm
POM-2244P-C3310-2-R
Converter_DCDC_Murata_CRE1xxxxxxSC_THT
PinSocket_2x32_P2.54mm_Vertical x 2
C_1206_3216Metric x 2
TSSOP-28_4.4x9.7mm_P0.65mm
Jack_3.5mm_CUI_SJ-3523-SMT_Horizontal x 3
SOT-23-5 x 2
SOT-23-6
C_1210_3225Metric x 4
MSOP-12-1EP_3x4.039mm_P0.65mm_EP1.651x2.845mm
L_Wuerth_MAPI-4030
CP_Elec_4x5.4
PM3_Audio_and_DMX_PCB
