Tommy270502/PM3/3_Technical_Documents/PCB/PM3_Audio_and_DMX_Template/PM3_Audio_and_DMX_Template/downloaded_3d_models/ptv09a-4x15f-xxxx.stp

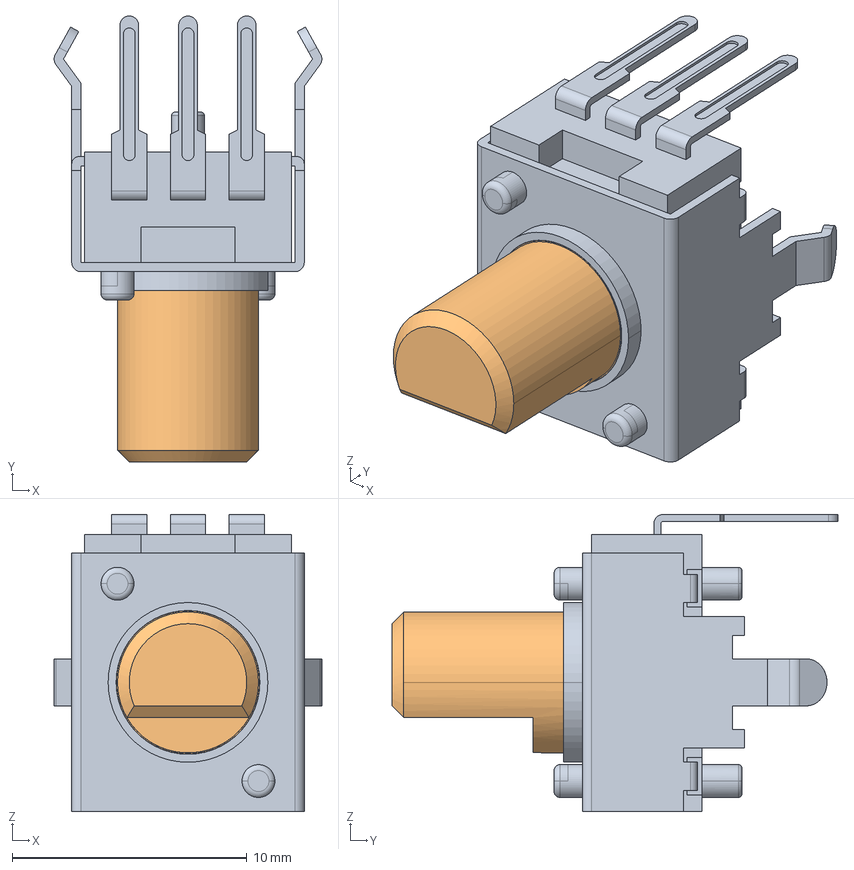
[picture p82: CAD file, 2025-10-03]
3_Technical_Documents/PCB/PM3_Audio_and_DMX_Template/PM3_Audio_and_DMX_Template/downloaded_3d_models/ptv09a-4x15f-xxxx.stp
11.4 x 19.0 x 12.7 mm
