Tommy270502/PM3/3_Technical_Documents/PCB/PM3_Audio_and_DMX_Template/PM3_Audio_and_DMX_Template/downloaded_3d_models/nc3faah2.stp

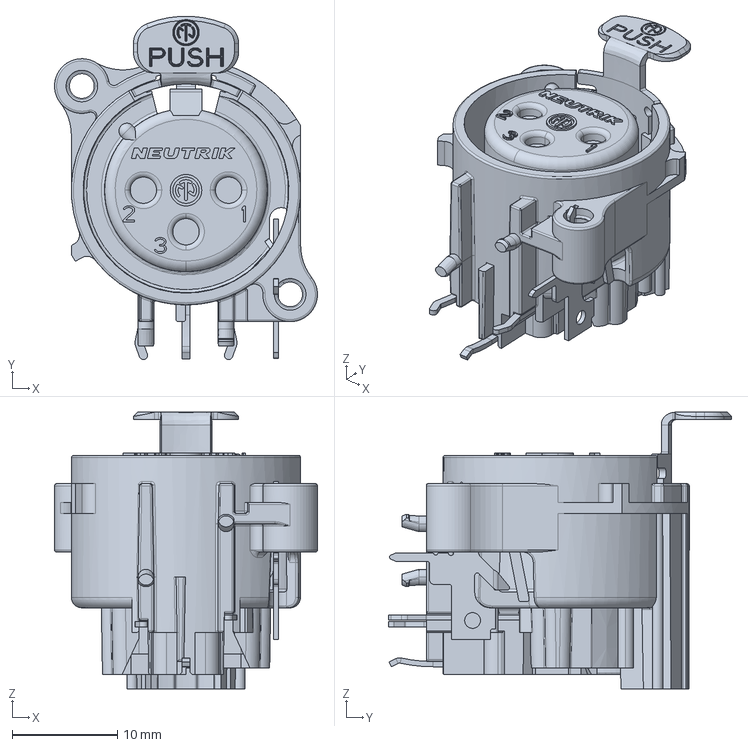
[picture p83: CAD file, 2025-10-03]
3_Technical_Documents/PCB/PM3_Audio_and_DMX_Template/PM3_Audio_and_DMX_Template/downloaded_3d_models/nc3faah2.stp
25.0 x 32.6 x 26.3 mm
