Tommy270502/PM3/3_Technical_Documents/PCB/PM3_Audio_and_DMX_Template/PM3_Audio_and_DMX_Template/downloaded_3d_models/JS202011JCQN.stp

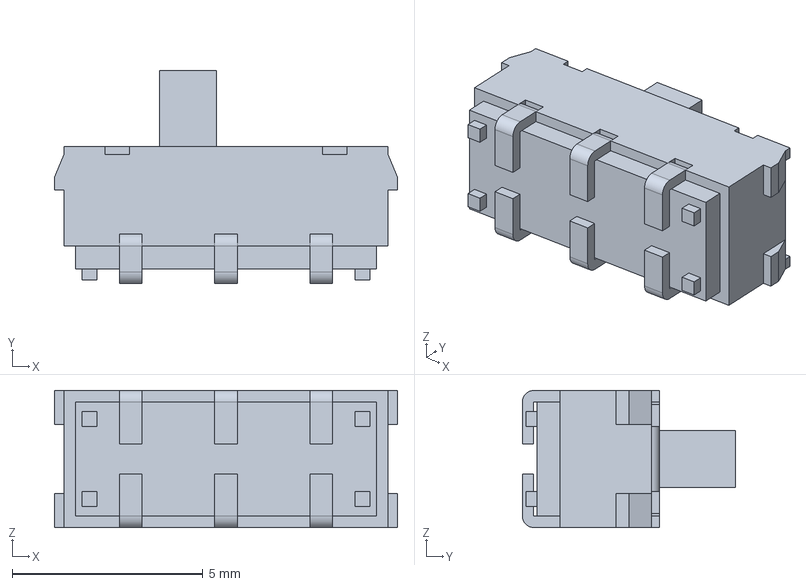
[picture p84: CAD file, 2025-10-03]
3_Technical_Documents/PCB/PM3_Audio_and_DMX_Template/PM3_Audio_and_DMX_Template/downloaded_3d_models/JS202011JCQN.stp
9.00 x 5.60 x 3.60 mm
