Tommy270502/PM3/2_Assessments/Measurement_Table_Perri_Grebnevs.xlsx

HW Tests without Discovery Board
This Excel table is provided together with a PDF test protocol. Please refer to the PDF for detailed information on the test procedure, analysis, and additional documentation.
Instructions: | Green = measurement mandatory to demonstrate |  |  | Legend: |  | in range / as expected => passed
 | all other measuremtents are mandatory, but not required to demonstrate |  |  |  |  | out of range / not as expected, considered acceptable => passed
 | Note how you define Min/Max for each measurement |  |  |  |  | out of range / not as expected => failed
 | orange = don't need to fill up
 | light blue = additional measurements (optional)
Setup: | 3V (P2, Pin 1) connected to +3V3
 | Power in by Lab Power Supply, 5 V |  |  |  |  |  |  |  |  |  |  |  | Points Measured | Points Min/Max | Comment
 |  | Channel | Measurement point |  | Expected |  |  | Min | Max | Measured | Measured with | Notes, how to calculate min/max (and exp.)
Voltages | Voltage at +3V3 ESP supply |  | C10 |  |  | 3.32 | V | 3.25 V | 3.39 V | 3.289V | Keysight U3402A | Based on resistor and current tolerances
& Currents | Voltage at +3V3 (VD) |  | TP |  |  | 3.32 | V | 3.25 V | 3.39 V | 3.286V | Keysight U3402A | Based on resistor and current tolerances |  | 1 | Set Pin Current tollerance in our case is 2%
 | Voltage at +5VA (VA) |  | TP |  |  | 4.99 | V | 4.89 V | 5.09 V | 4.988V | Keysight U3402A | Based on resistor and current tolerances |  | 2 | Follow-up error from above
 | Voltage at DMX_+5V |  | TP |  |  | 5.4 | V | 5.29V | 5.51V | 5.24V | Keysight U3402A | Based on resistor and current tolerances. Taking into account tolerance envelope is acceptable |  | 2
 | Voltage at Boost Output |  | C34 |  |  | 5.51 | V | 5.25V | 5.78V | 5.67V | Keysight U3402A | Based on resistor and reference voltage tolerances (ref. Equation 4 in the datasheet) | 1 | 2
 | Ripple on +3V3 ESP supply |  | C10 |  | < | 0.80 | uV | --- | --- | 4mVpp | Tektomix TDS 2012C | 0.8 uV RMS + 50 dB below the input (Lab Power Supply). Oscilloscope has not enough accuracy, measures above the expected value even when no signal is connected
 | Ripple on +3V3 (VD) |  | TP |  | < | 0.80 | uV | --- | --- | 4.4mVpp | Tektomix TDS 2012C | 0.8 uV RMS + 50 dB below the input (Lab Power Supply).Oscilloscope has not enough accuracy, measures above the expected value even when no signal is connected |  | 2
 | Ripple on +5VA (VA) |  | TP |  | < | 0.81 | uV | --- | --- | 1.5mVpp | Tektomix TDS 2012C | 0.8 uV RMS + 50 dB below the input (Boost Output).Oscilloscope has not enough accuracy, measures above the expected value even when no signal is connected |  | 2
 | Ripple at DMX_+5V |  | TP |  | < | 40 | mVpp | --- | --- | 6mVpp | Tektomix TDS 2012C | From the datasheet |  | 2
 | Ripple on Boost Output |  | C34 |  | < | 18.3 | mV | --- | --- | 5mVpp | Tektomix TDS 2012C | Based on the capacitor value and boost converter parameters (ref. Equation 8 in the datasheet) | 1 | 2
 | Current on Power in at 5 V |  |  |  | < | 180 | mA | --- | --- | 173mA | Keysight U3402A | Value given
 | Current on Power in at 5V, 3V0 disconnected |  |  |  | < | 160 | mA | --- | --- | 127.6mA | Keysight U3402A | Value given
 | Current Ripple on Power in at 5 V |  |  |  | < | 36 | uA | --- | --- | 1mApp | Tektomix TDS 2012C | Based on voltage ripple. Measured using 10Ohm shunt resistor. Oscilloscope and measurement method providenot enough accuracy | 1
Microphone | Mic Voltage |  |  |  |  | 2.6 | V | 2 V | <5 V | 2.48V | Keysight U3402A | Value given | 1
 | Signal Peak finger snip |  |  |  |  | 50 | mV | 0 V | 2.5 V | 68mVpp | Tektomix TDS 2012C | Value given | 1
 | Signal Peak finger on mic |  |  |  | > | 300 | mV | 0 V | 2.5 V | 500mVpp | Tektomix TDS 2012C | Value given | 1
 | Signal Peak finger snip after Preamp |  |  |  | > | 2 | V | 0 V | 2.5 V | 5Vpp | Tektomix TDS 2012C | Value given | 1
 | Signal Peak finger on mic after Preamp |  |  |  | > | 2 | V | 0 V | 2.5 V | 5Vpp | Tektomix TDS 2012C | Value given | 1
 | Reference Voltage U4 |  |  |  |  | 2.5 | V | 2.475V | 2.525V | 2.489V | Keysight U3402A |  | 1 | 2
Line | Input 1 kHz | Left | Line in (L) |  |  | 500 | mVpp | --- | --- | 500mVpp | Tektomix TDS 2012C | Generate a 500 mVpp 1 kHz signal and measure the amplitude at Line Input
 | After AA Filter 1 kHz | Left | C46 |  |  | 500 | mVpp | --- | --- | 532mVpp | Tektomix TDS 2012C | 1kHz is in pass band => no attenuation
 | Input 1 kHz | Right | Line in (R) |  |  | 500 | mVpp | --- | --- | 500mVpp | Tektomix TDS 2012C | Generate a 500 mVpp 1 kHz signal and measure the amplitude at Line Input
 | After AA Filter 1 kHz | Right | C47 |  |  | 500 | mVpp | --- | --- | 532mVpp | Tektomix TDS 2012C | 1kHz is in pass band => no attenuation
DMX | DMX A Voltage |  |  |  |  | 5.5 | V | --- | --- | 4.46V | Keysight U3402A | Voc + Vod/2. Expected value is calculated with max values from the datasheet, values down to 3.75V (with Vod=1.5) are also acceptable | 1
 | DMX B Voltage |  |  |  |  | 0.5 | V | --- | --- | 0.87V | Keysight U3402A | Voc - Vod/2. Expected value is calculated with max values from the datasheet, values up to 2.25V (with Vod=1.5V) are also acceptable | 1
Setup: | Wire Loop P1 Pin 11 <=> Pin 16 (SDOUT ==> SDIN)
 | 3V (P2, Pin 1) connected to +3V3
 | Power in by Lab Power Supply, 5 V
 | Reset CS4271 after power applied
CODEC | Crystal Frequency (1:10 Probe!) |  | Y1 |  | --- |  |  | 16.384 MHz | 25.600 MHz | 24.88MHz | Tektomix TDS 2012C | From the datasheet | 1 | 0 | Not what the codec supports, but the tolerance you expect when measuring based on the component tolerance as before. In this case, that means 20 ppm of the crystal.
 | MCLK Frequency |  |  |  | --- |  |  | 1.024 MHz | 25.600 MHz | 12.3MHz | Tektomix TDS 2012C | From the datasheet (max frequency is for stand alone mode) | 1 | 0 | see above
 | LRCLK Frequency |  | JP9 |  | --- |  |  | 4kHz | 50kHz | 47.998kHz | Tektomix TDS 2012C | From the datasheet (sample rate) |  | 0 | see above
 | SCLK Frequency |  |  |  | --- |  |  | 256kHz | 3.2MHz | 3.07MHz | Tektomix TDS 2012C | From the datasheet, LRCK x64 | 1 | 1 | expected value 64*LRCK ok, but rest see above
 | SDOUT signal present |  |  |  | --- |  |  | --- | --- | YES | Tektomix TDS 2012C | No expected value needed | 1
 | Amplitude after Rec-Filter | Left | Line out (L) |  |  | 500 | mVpp | --- | --- | 533mVpp | Tektomix TDS 2012C | 1kHz is in pass band => no attenuation
 | Amplitude after Headphone-Amp unloaded | Left | Headphone Jack (L) |  |  | 2.5 | Vpp | --- | --- | 2.62Vpp | Tektomix TDS 2012C | Max amplification factor = 5
 | Amplitude after Rec-Filter | Right | Line out (R) |  |  | 500 | mVpp | --- | --- | 536mVpp | Tektomix TDS 2012C | 1kHz is in pass band => no attenuation
 | Amplitude after Headphone-Amp unloaded | Right | Headphone Jack (R) |  |  | 2.5 | Vpp | --- | --- | 2.60Vpp | Tektomix TDS 2012C | Max amplification factor = 5
 | Frequency sweep (400Hz … 20kHz) |  |  |  | No attenuation |  |  | --- | --- | YES | Tektomix TDS 2012C | No attenuation in human hearable range
 |  |  |  |  |  |  |  |  |  |  |  |  | 15 | 18 | 33
 |  |  |  |  |  |  |  |  |  |  |  |  | 15 | 26 | 41
 |  |  |  |  |  |  |  |  |  |  |  |  |  |  | 5.58
