Tommy270502/PM3/3_Technical_Documents/PCB/PCB_fixes.png

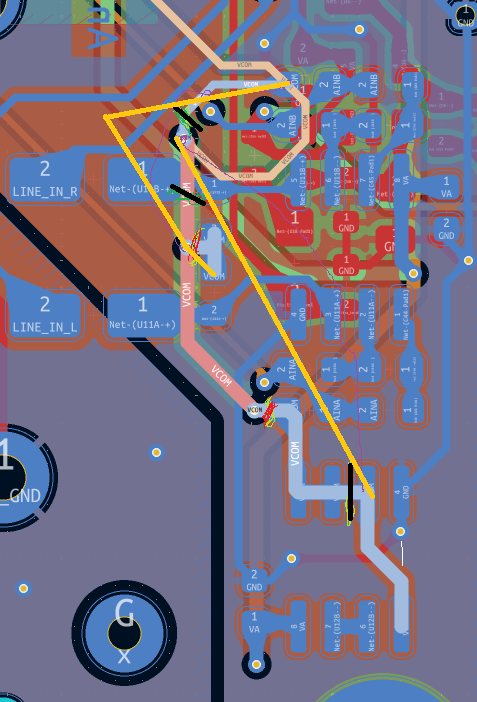
3_Technical_Documents/PCB/PCB_fixes.png
