Tommy270502/PM3/3_Technical_Documents/PCB/PM3_Audio_and_DMX_Template/PM3_Audio_and_DMX_Template/PM3_Audio_and_DMX.pdf

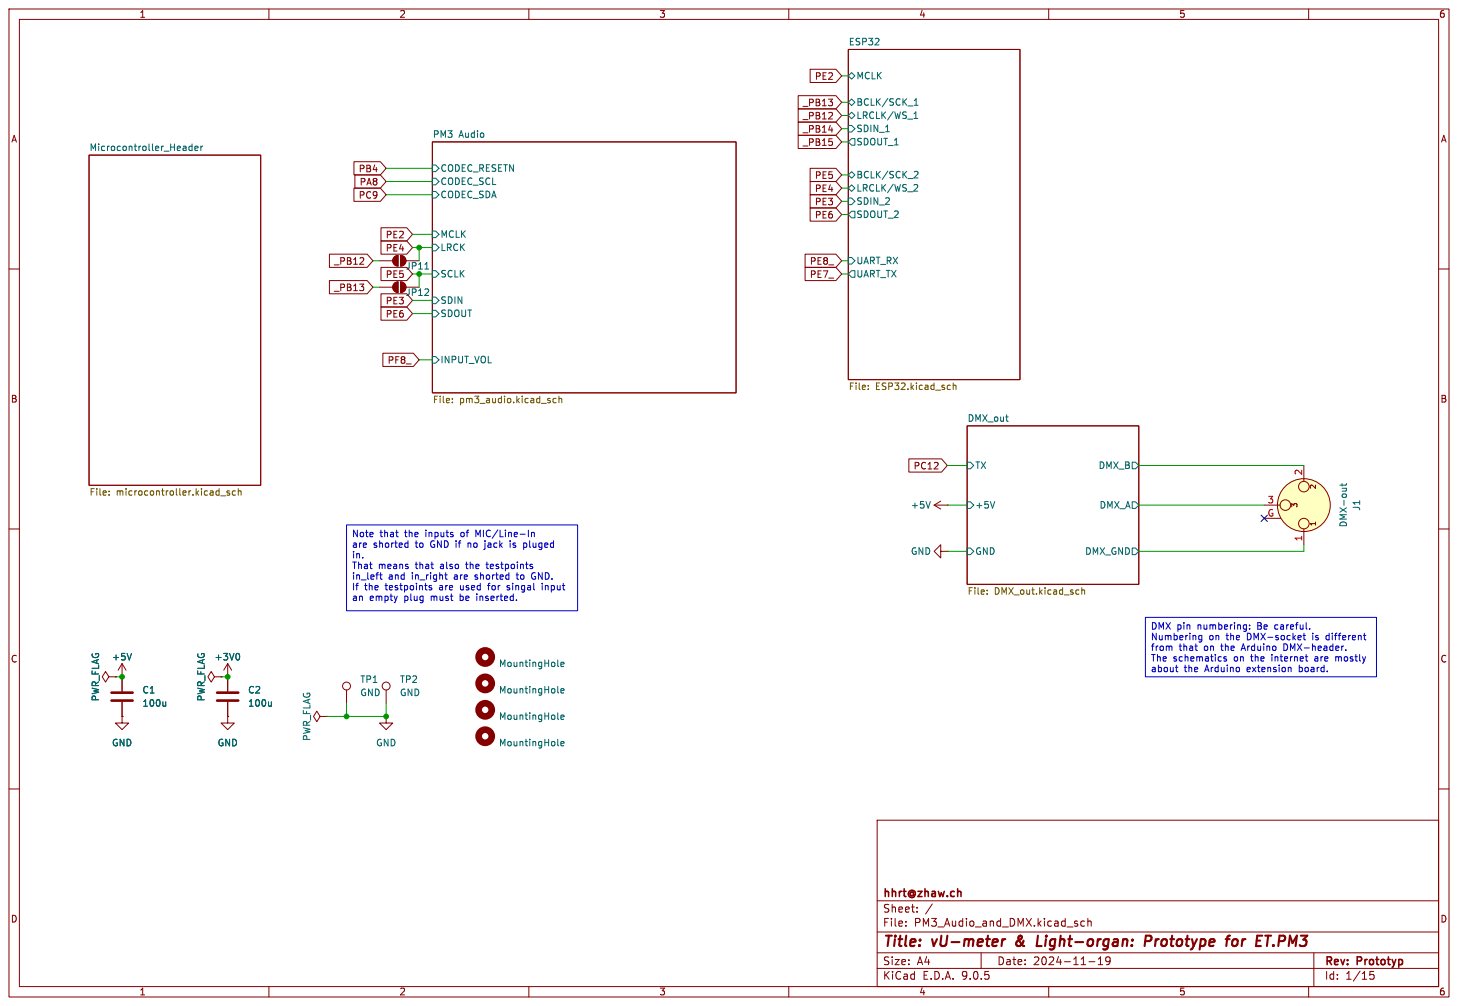
[picture p106: page 1]

are shorted to GND if no jack is pluged
in. That means that also the testpoints

File: PM3_Audio_and_DMX.kicad_sch Sheet: / hhrt@zhaw.ch

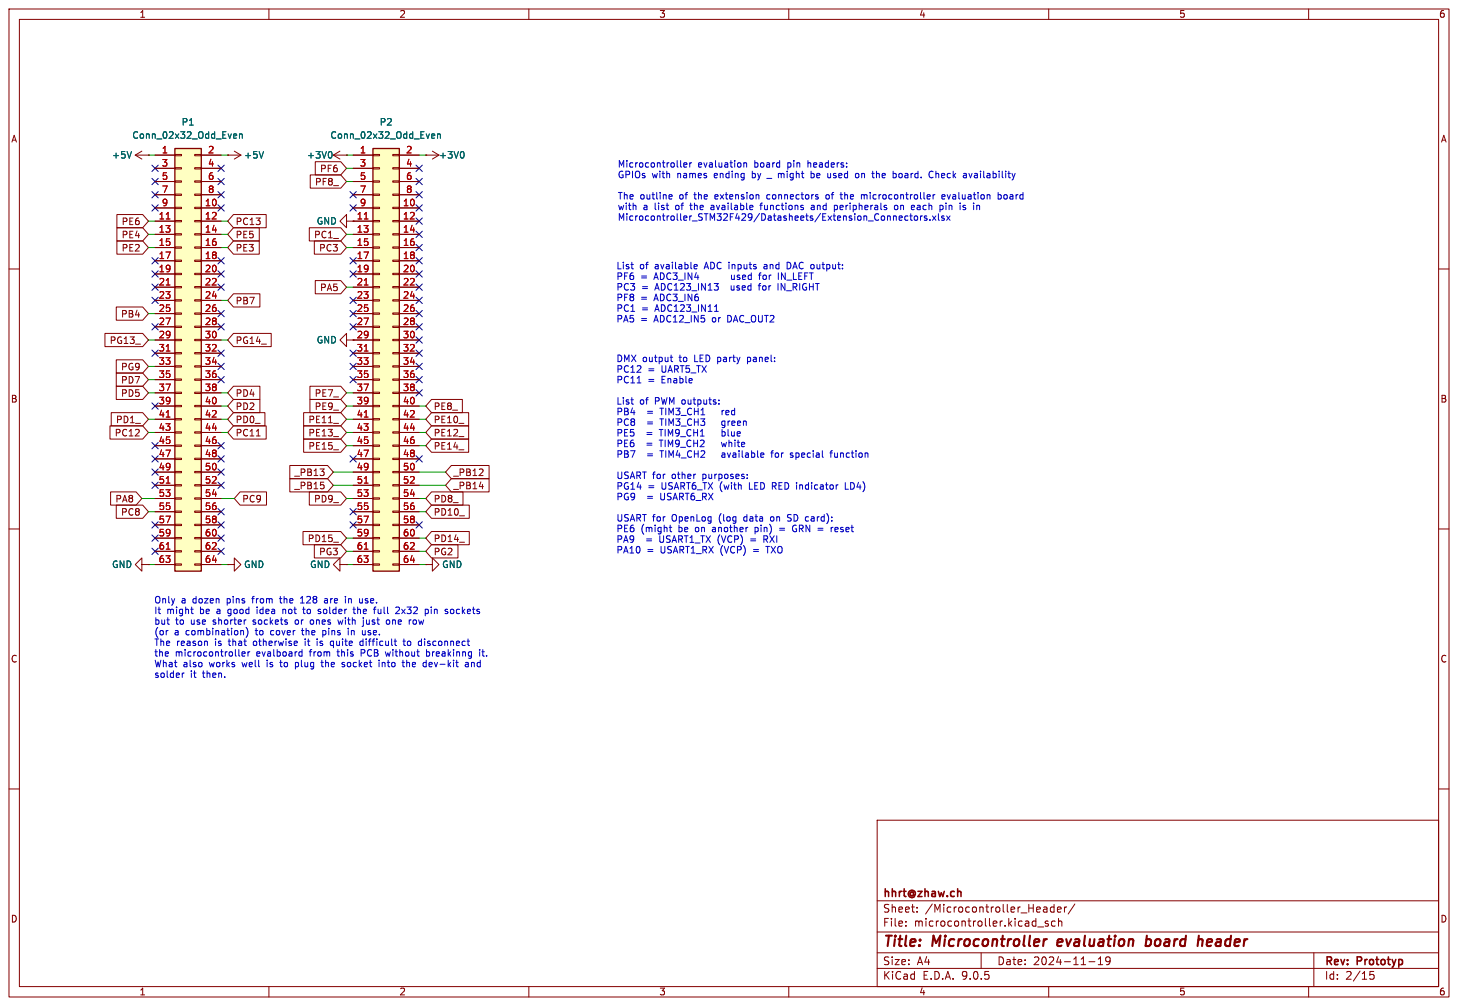
[picture p107: page 2]

Only a dozen pins from the 128 are in use.
It might be a good idea not to solder the full 2x32 pin sockets but to use shorter sockets or ones with just one row

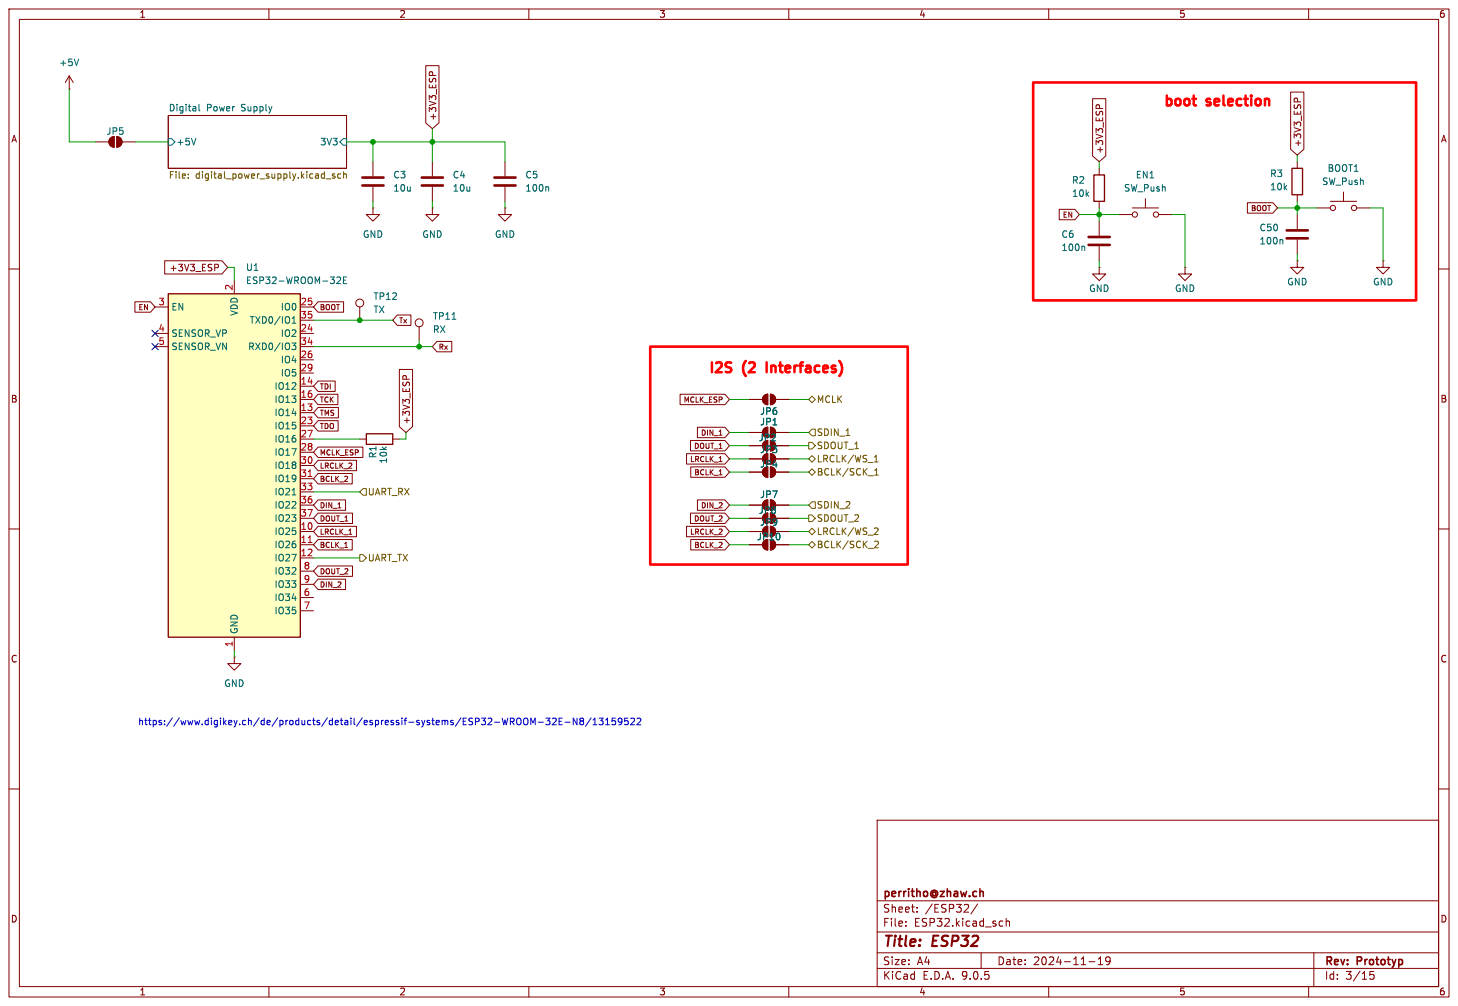
[picture p108: page 3]

https://www.digikey.ch/de/products/detail/espressif-systems/ESP32-WROOM-32E-N8/13159522

File: ESP32.kicad_sch Sheet: /ESP32/ perritho@zhaw.ch

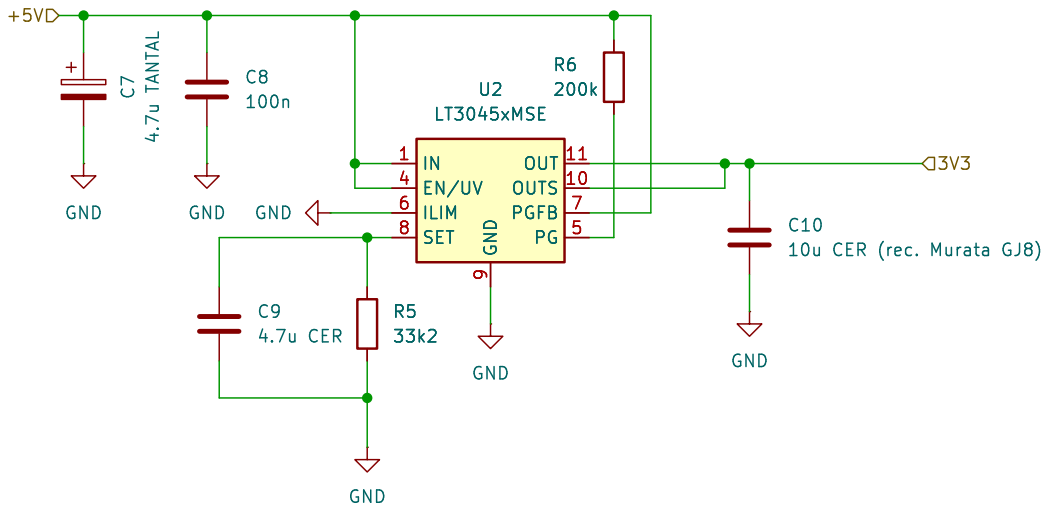
[picture p109: page 4]

9 OUT 11 OUTS 10 PGFB 7 PG 5 U2
LT3045xMSE

9 OUT 11 OUTS 10 PGFB 7 PG 5 R5

10u CER (rec. Murata GJ8) GND

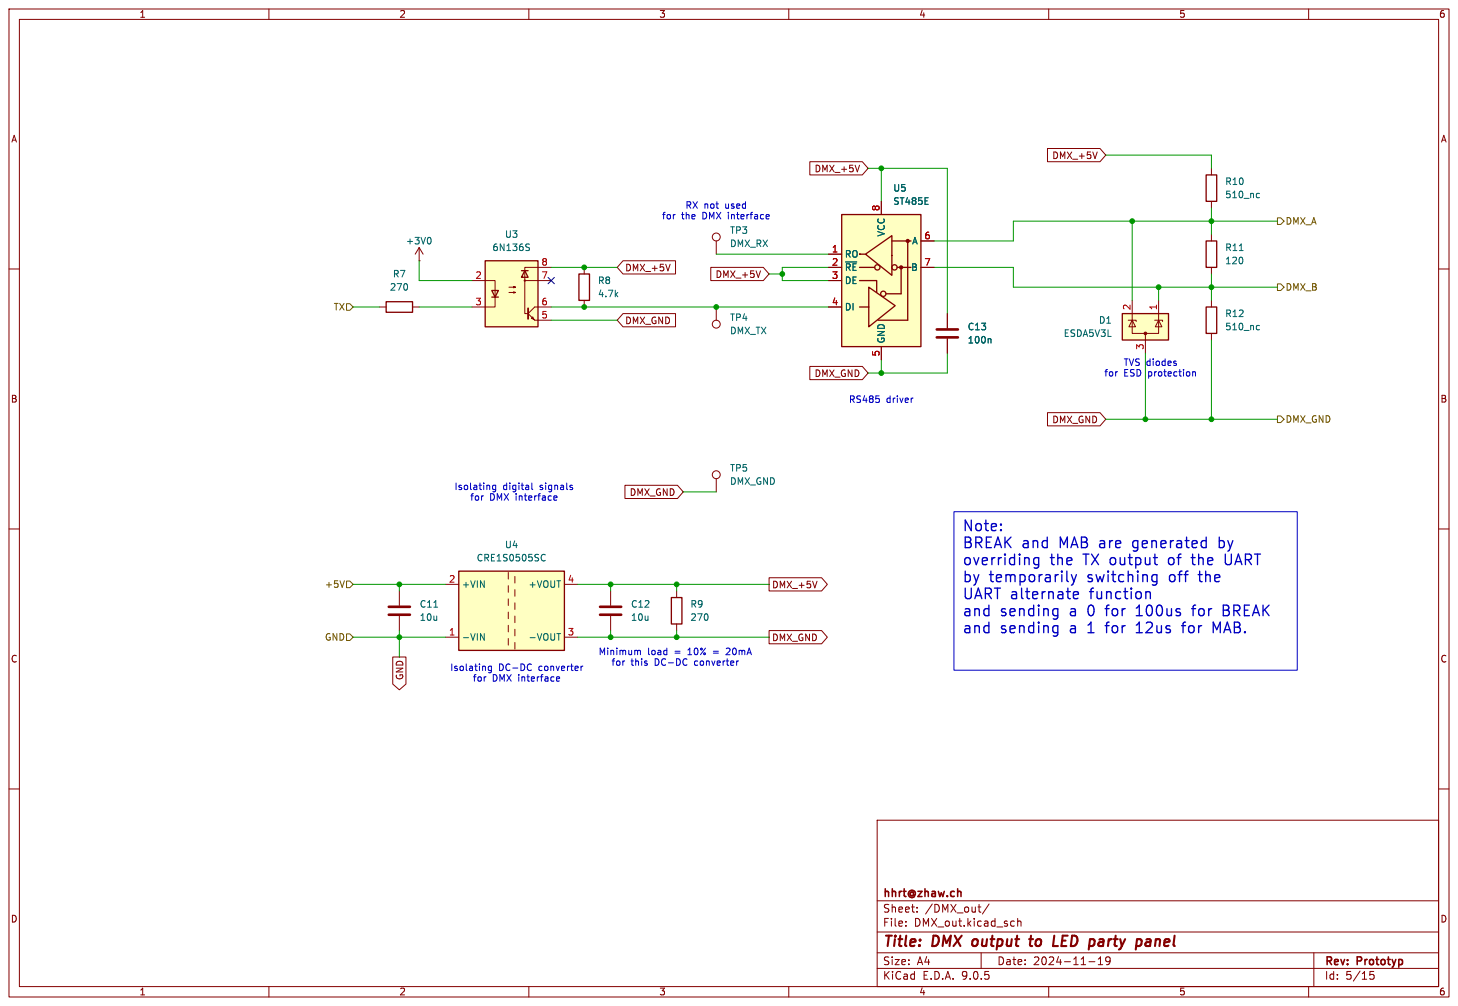
[picture p110: page 5]

hhrt@zhaw.ch
Id: 5/15 Title: DMX output to LED party panel File: DMX_out.kicad_sch Sheet: /DMX_out/

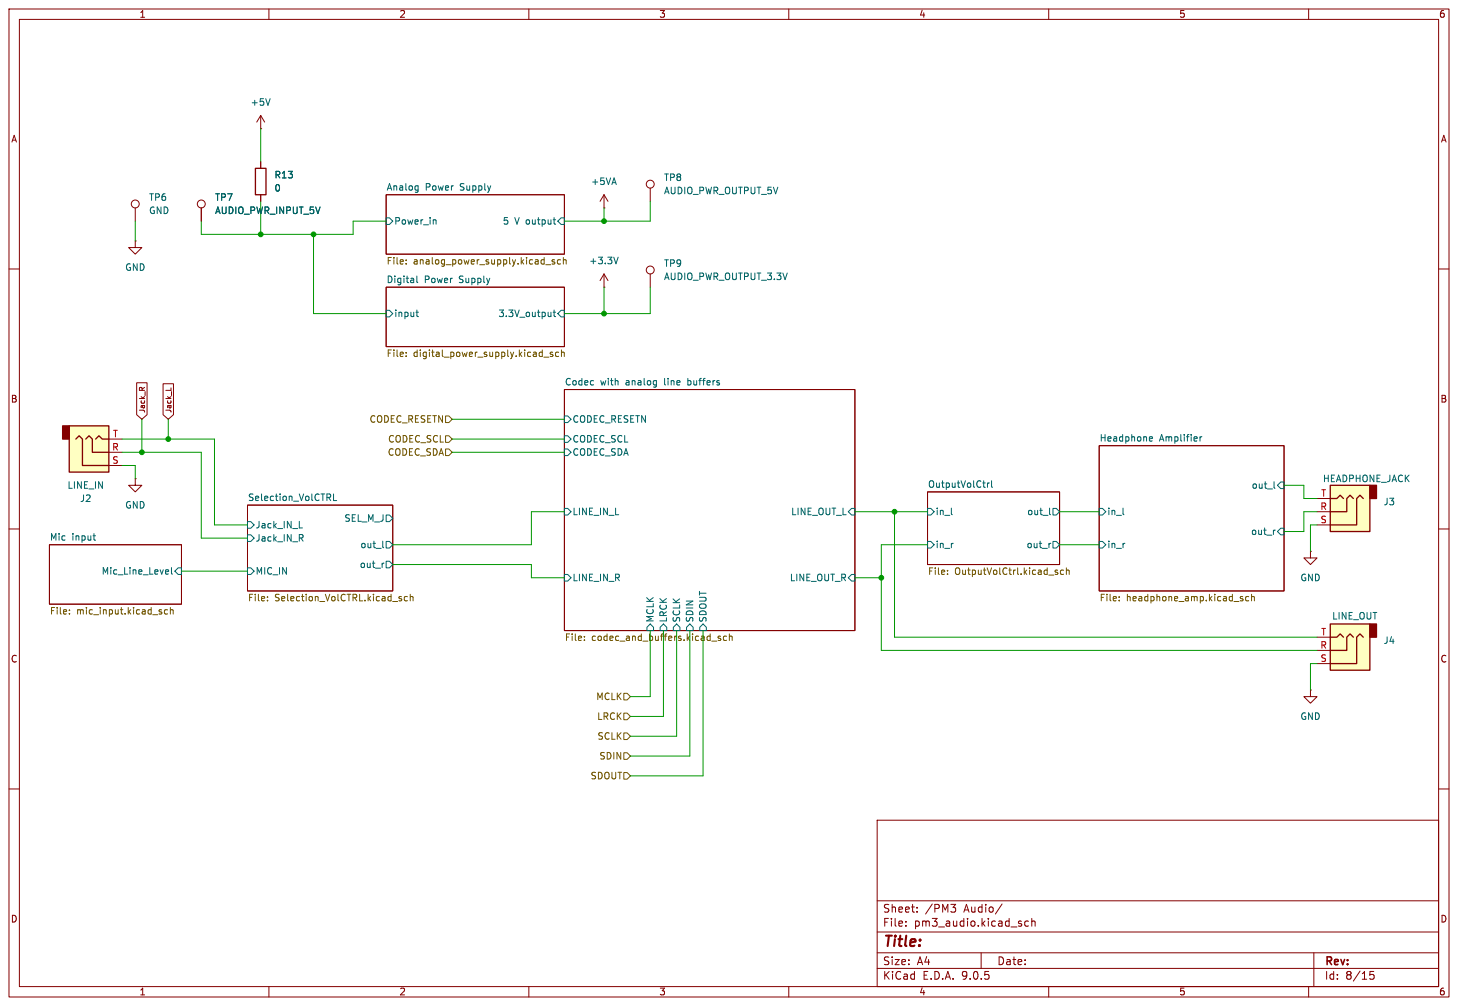
[picture p111: page 6]

Digital Power Supply File: digital_power_supply.kicad_sch

LINE_OUT_R MCLK LRCK SCLK SDIN SDOUT Codec with analog line buffers File: codec_and_buffers.kicad_sch GND

Id: 8/15 Title: File: pm3_audio.kicad_sch Sheet: /PM3 Audio/ Mic_Line_Level Mic input File: mic_input.kicad_sch

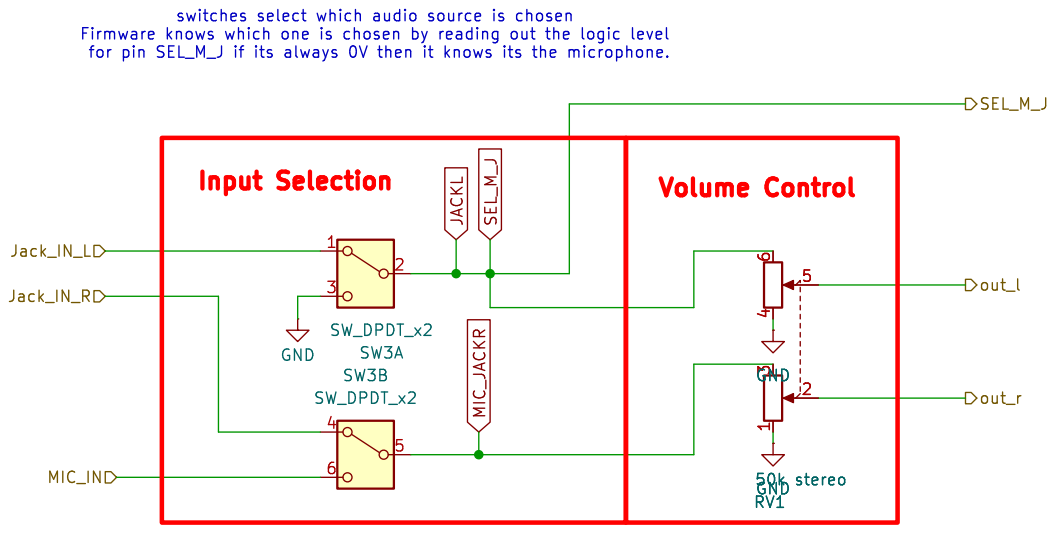
[picture p112: page 7]

perritho @ ZHAW SOE
Id: 12/15 Title: Selection & Volume Control File: Selection_VolCTRL.kicad_sch Sheet: /PM3 Audio/Selection_VolCTRL/

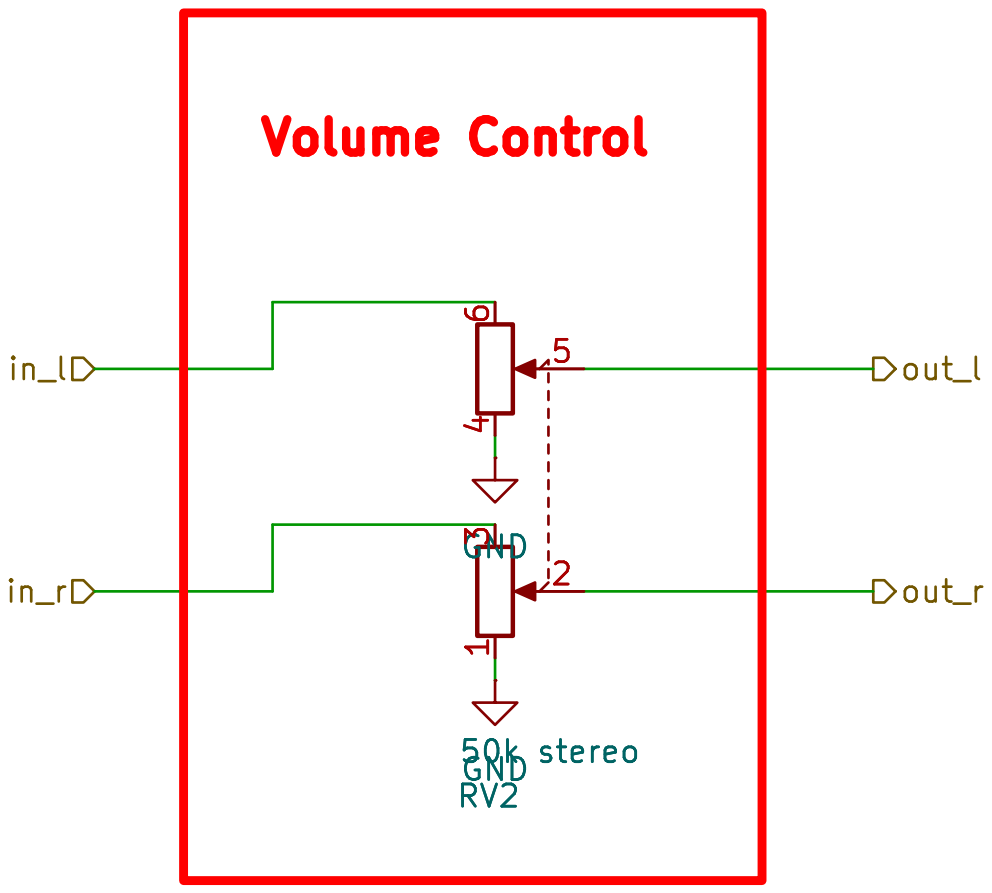
[picture p113: page 8]

Id: 13/15 Title: File: OutputVolCtrl.kicad_sch Sheet: /PM3 Audio/OutputVolCtrl/ GND GND

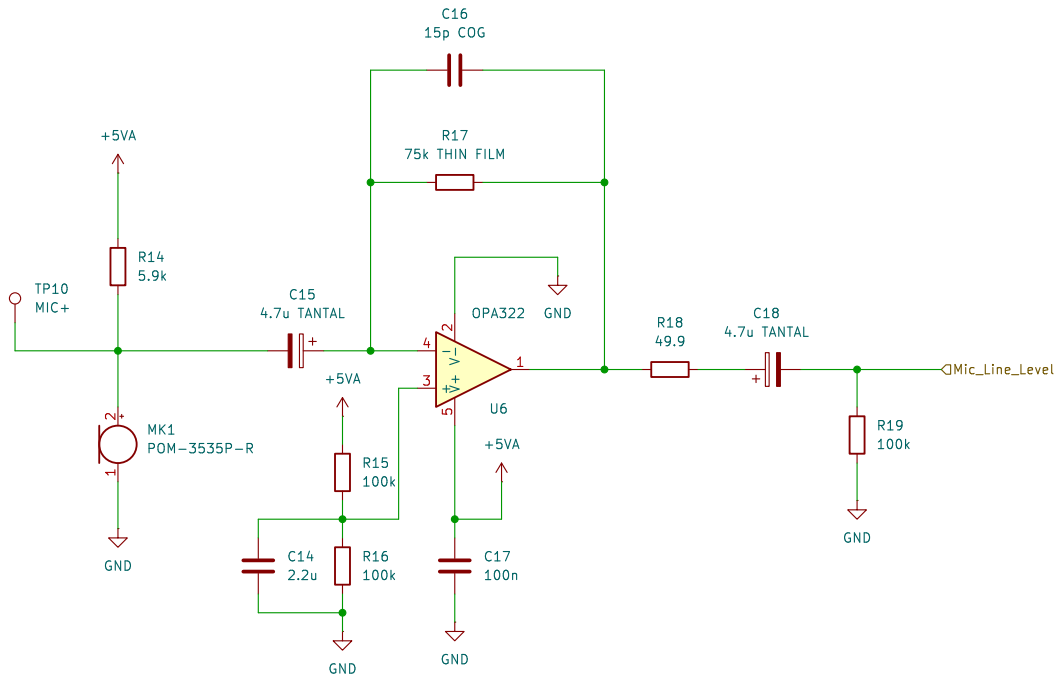
[picture p114: page 9]

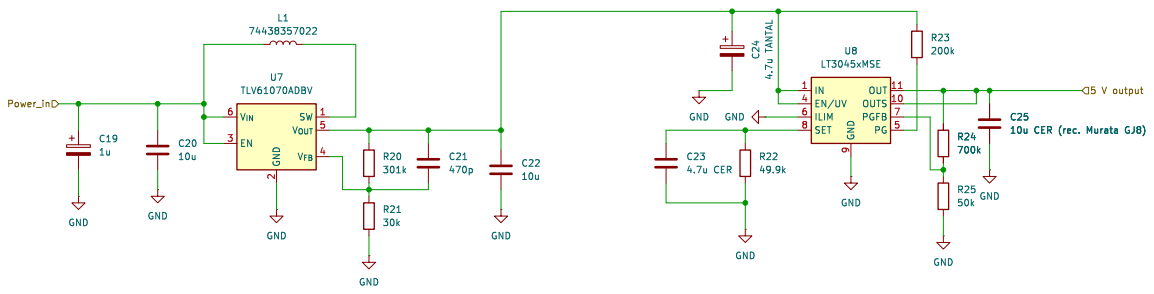
[picture p115: page 10]

9 OUT 11 OUTS 10 PGFB 7 PG 5 U8

10u CER (rec. Murata GJ8) GND

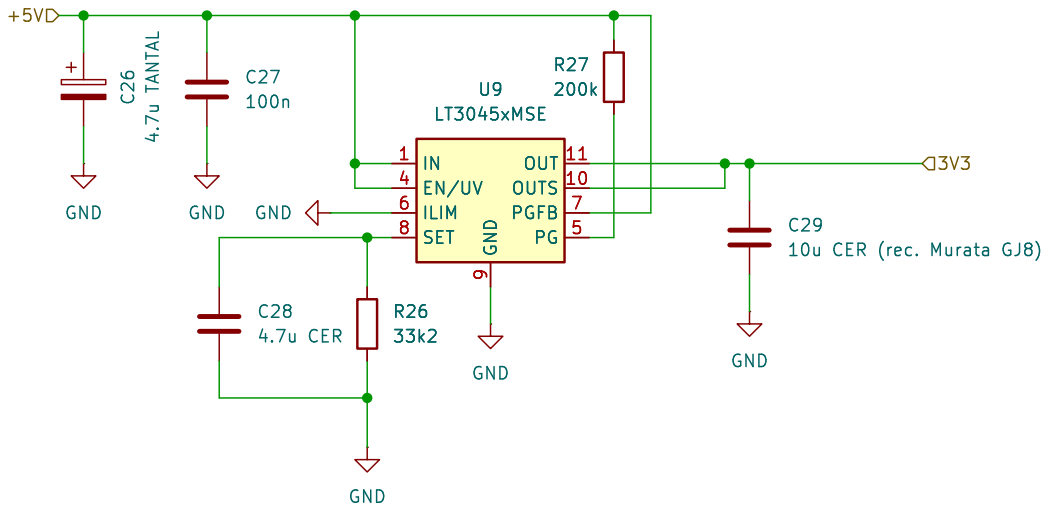
[picture p116: page 11]

9 OUT 11 OUTS 10 PGFB 7 PG 5 U9
LT3045xMSE

9 OUT 11 OUTS 10 PGFB 7 PG 5 R26

10u CER (rec. Murata GJ8) GND

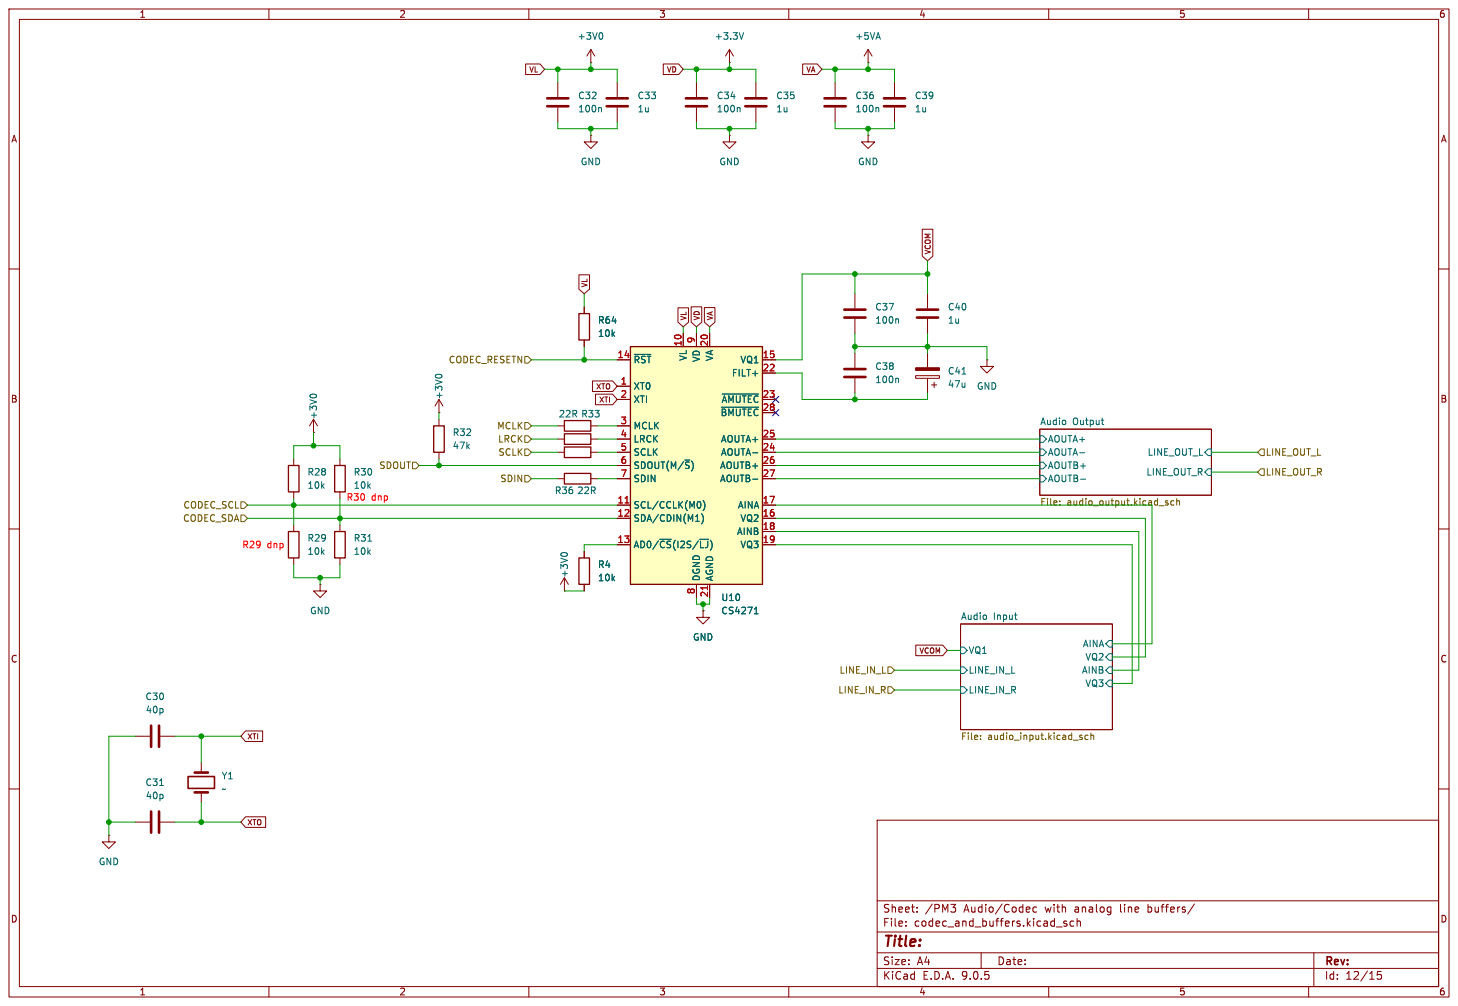
[picture p117: page 12]

8 VA 20 AGND 21 VQ1 15 FILT+ 22 ~{AMUTEC} 23 ~{BMUTEC} 28 AOUTA+ 25 AOUTA- 24 AOUTB+ 26 AOUTB- 27 AINA 17 VQ2 16 AINB 18 VQ3 19 U10 CS4271 GND GND GND GND

8 VA 20 AGND 21 VQ1 15 FILT+ 22 ~{AMUTEC} 23 ~{BMUTEC} 28 AOUTA+ 25 AOUTA- 24 AOUTB+ 26 AOUTB- 27 AINA 17 VQ2 16 AINB 18 VQ3 19 R4

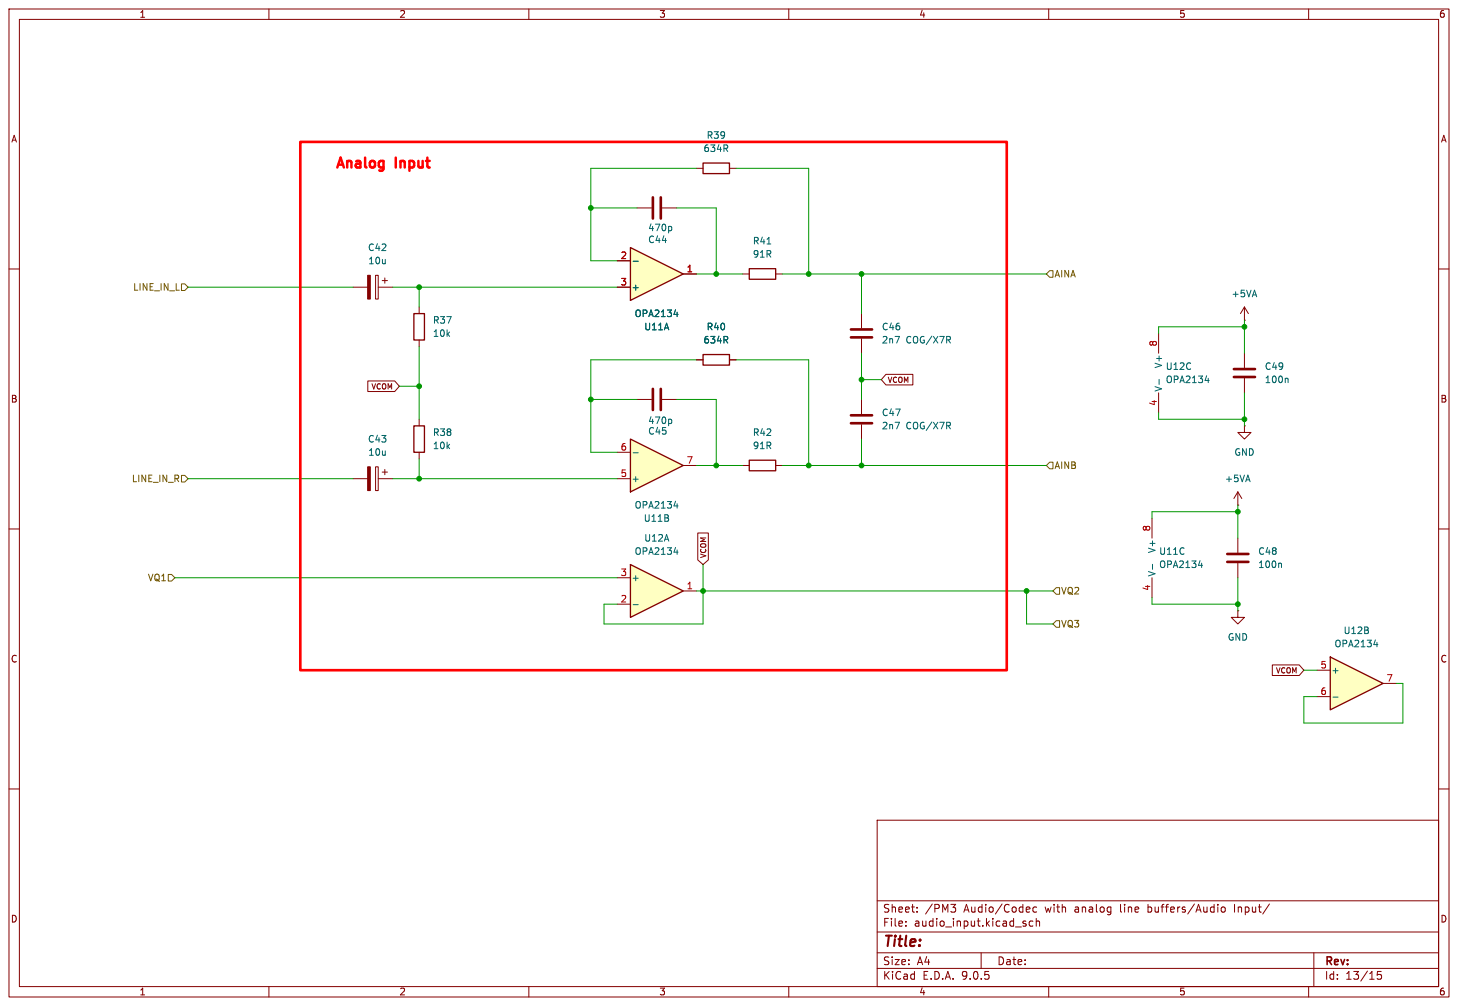
[picture p118: page 13]

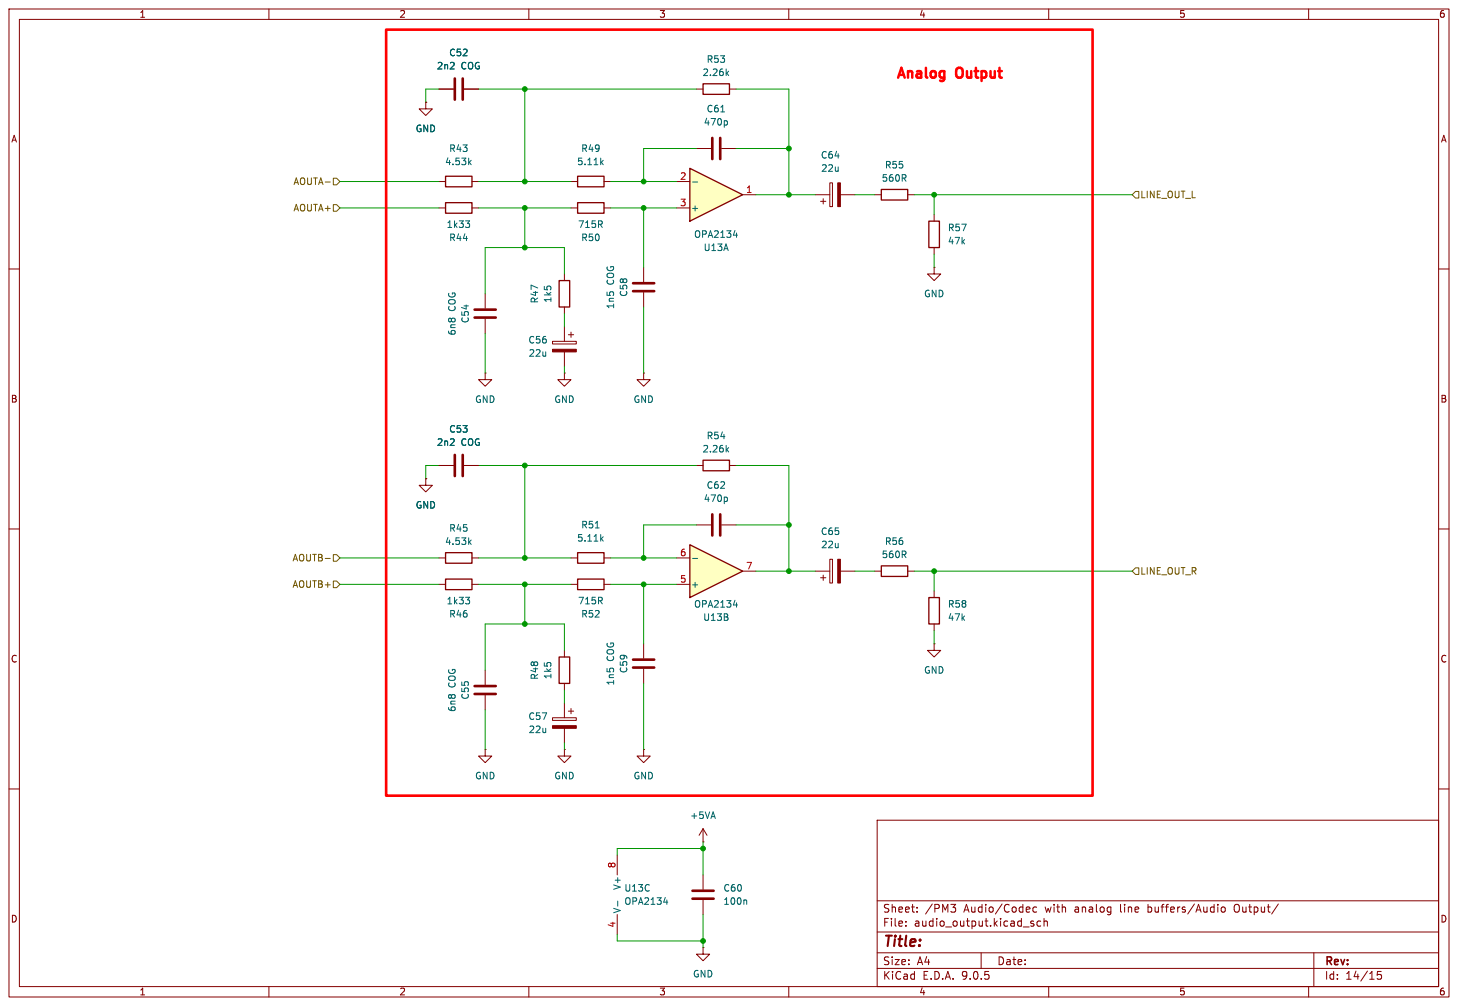
[picture p119: page 14]

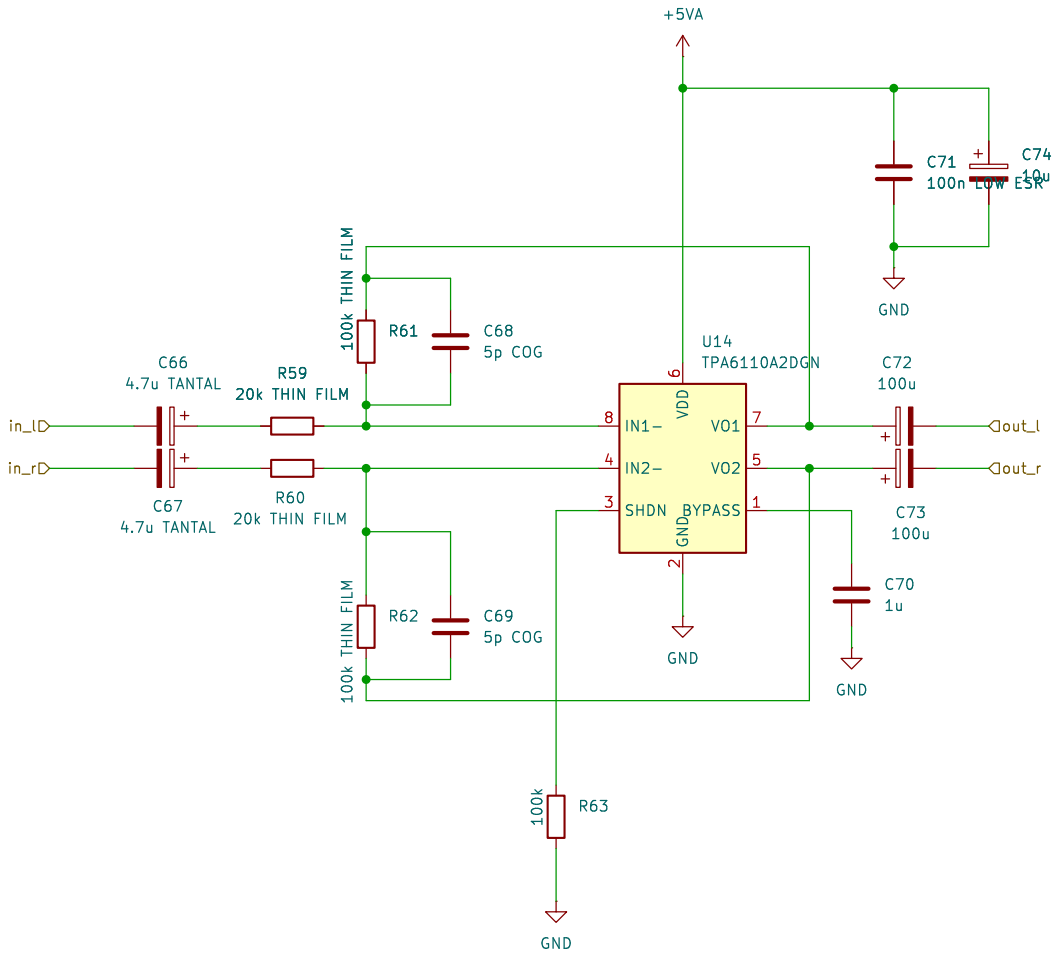
[picture p120: page 15]
