Tommy270502/PM3/3_Technical_Documents/PCB/block_diagram_highlighted_parts.pdf

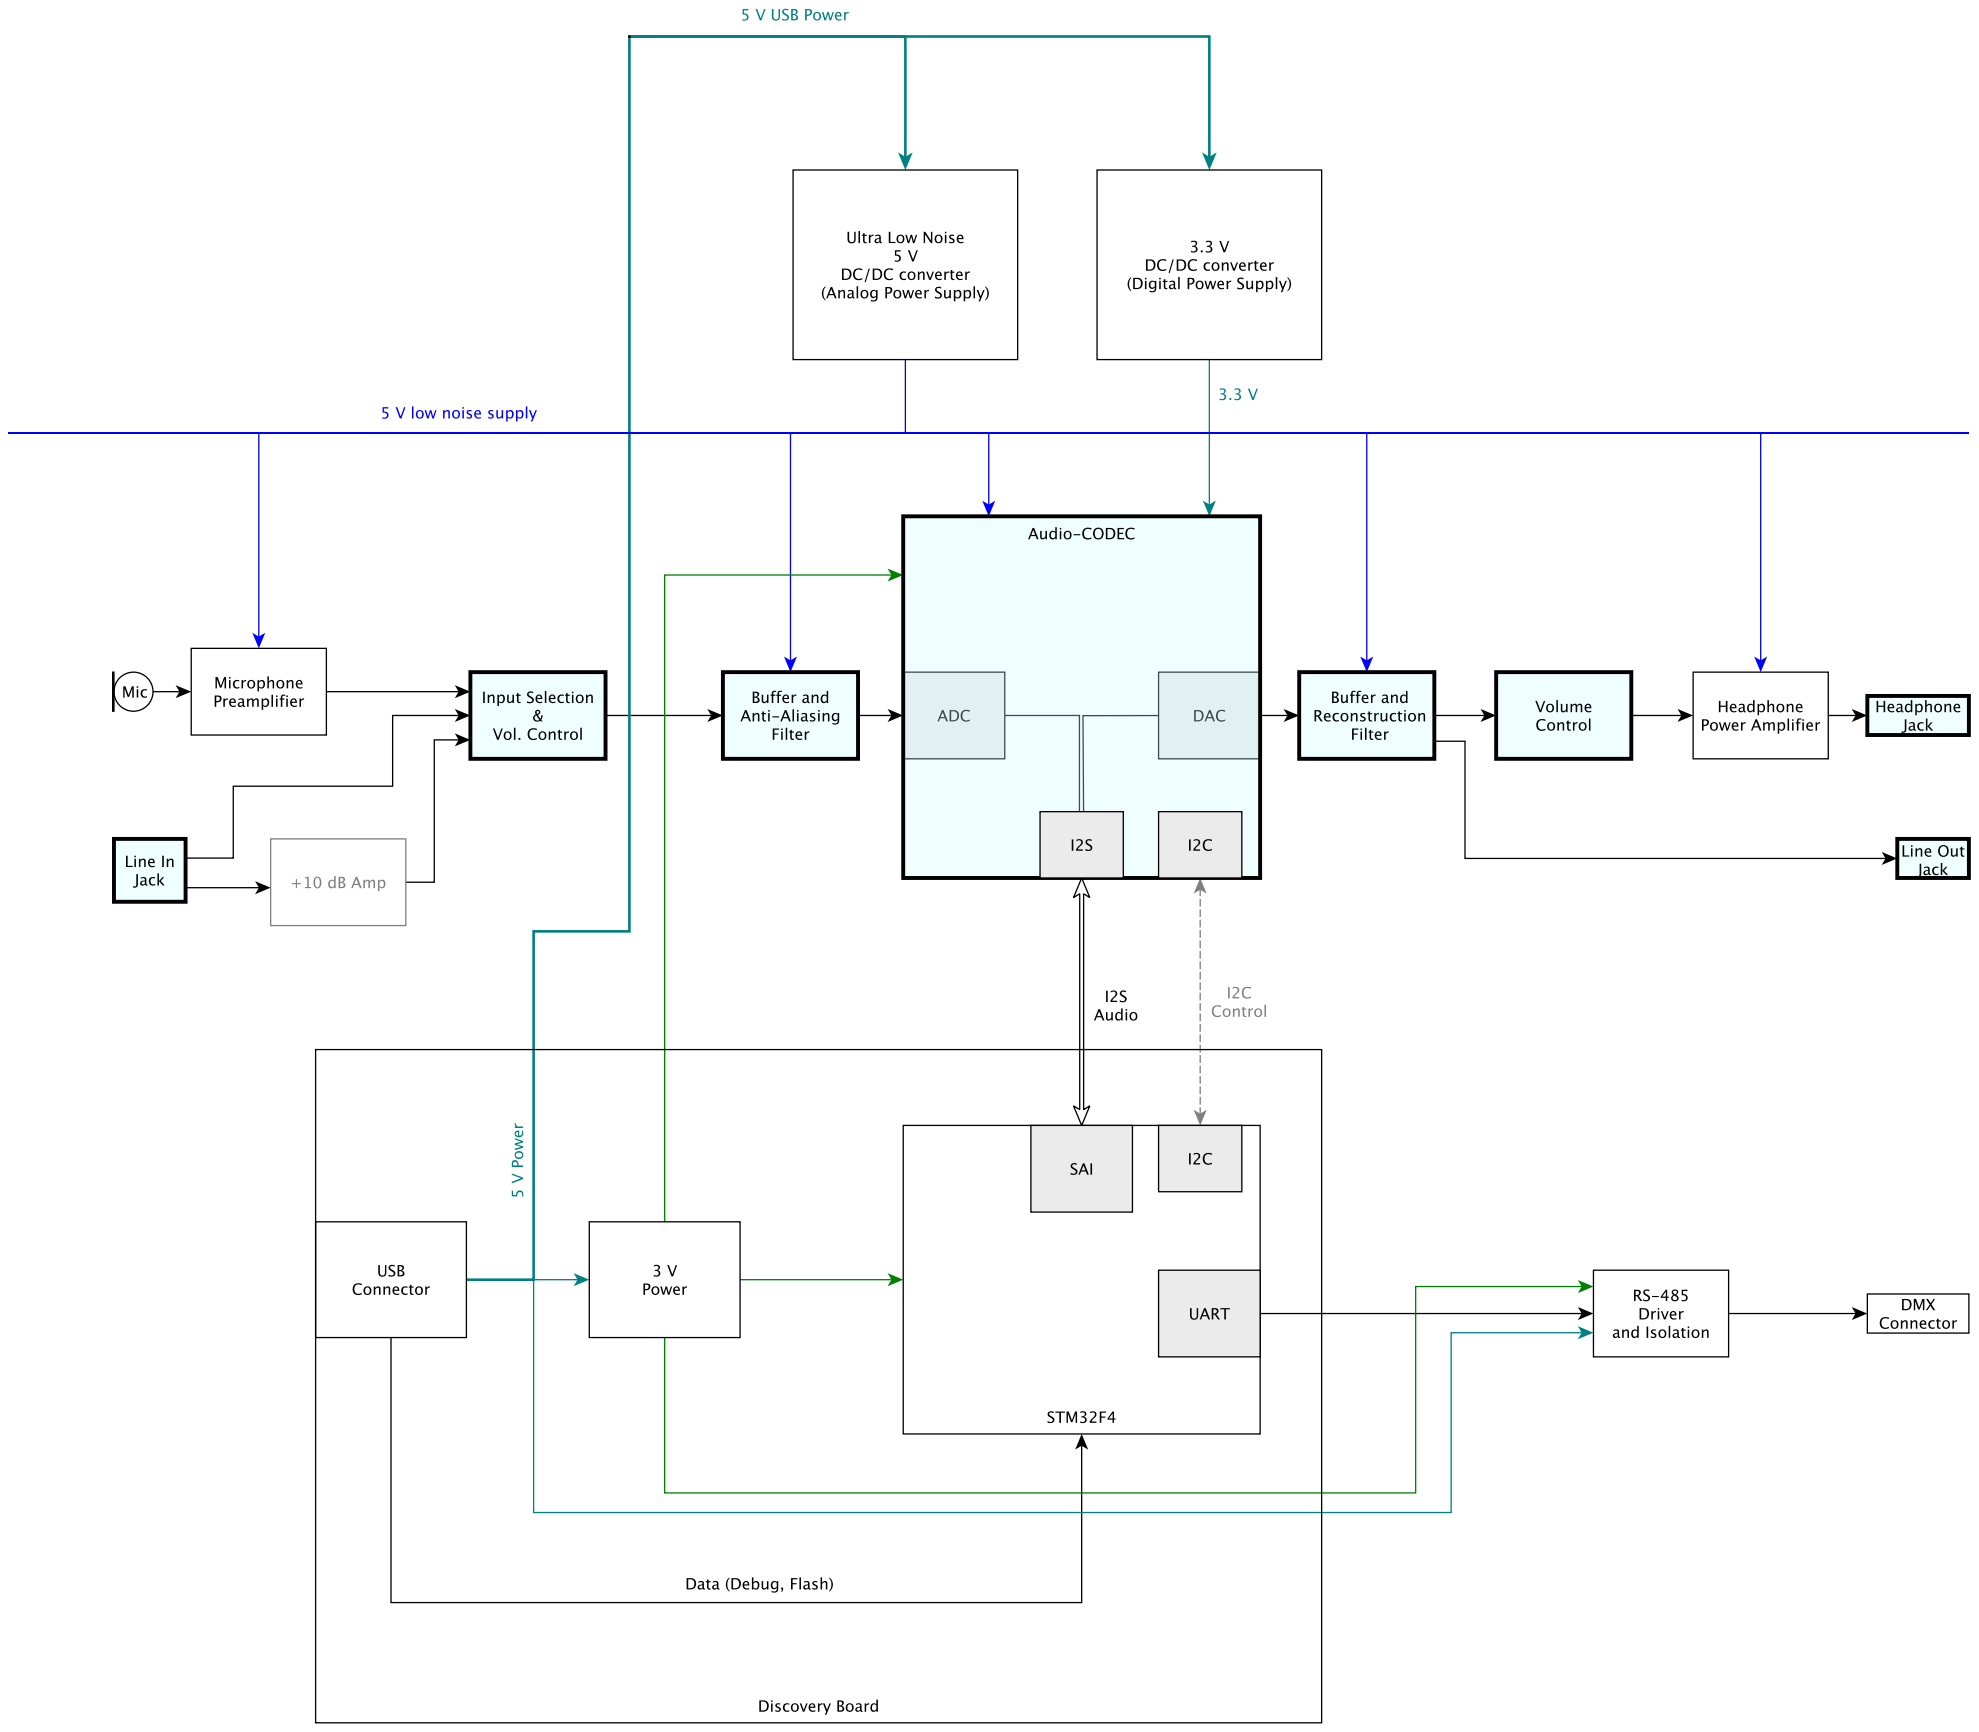
[picture p121: page 1]
