Tommy270502/PM3/3_Technical_Documents/Analog_Signal_Processing/reconstruction_filter.asc

C1: cap; 6n8
C2: cap; 22µ
C3: cap; 1n5
C4: cap; 22µ
C5: cap; 2n2
C6: cap; 470p
OpA1: opamp
R1: res; 4k53
R2: res; 1k33
R3: res; 1k5
R4: res; 560R
R5: res; 5k11
R6: res; 715R
R7: res; 47k
R8: res; 2.26k
Vin1: voltage; SINE(0 1m 50); AC 1
Vin: voltage; SINE(0 1m 50); AC 1
Named nets: 0, AOUT-, LINE_OUT, AOUT+
.lib opamp.sub
.ac dec 10 1 100k
Reconstruction Filter
