Tommy270502/PM3/3_Technical_Documents/Analog_Signal_Processing/anti_aliasing_filter.asc

C1: cap; 470p
C2: cap; 10µ
C3: cap; 10µ
C4: cap; 470p
C5: cap; 2n7
C6: cap; 2n7
OpA1: opamp
OpA2: opamp
OpA: opamp
R1: res; 914
R2: res; 634
R3: res; 914
R4: res; 634
R5: res; 10k
R6: res; 10k
Vcom: voltage; 2.5
Vin1: voltage; SINE(0 1m 2k); AC 1
Vin: voltage; SINE(0 1m 1k); AC 1
Named nets: 0, LINE_IN_L, AINA, VCOM, LINE_IN_R, AINB, VQ1
.lib opamp.sub
.ac dec 10 1 100k
Anti-Aliasing Filter
