Tommy270502/PM3/3_Technical_Documents/Analog_Signal_Processing/MF_lowpass.asc

C1: cap; 39n
C2: cap; 0.1n
C3: cap; 10µ
OpA: opamp
R1: res; 3.3k
R2: res; 18k
R3: res; 330k
Vgnd: voltage; 1.5
Vin: voltage; SINE(0 1m 50); AC 1
Named nets: 0, in, V_GND, out
.lib opamp.sub
.ac dec 10 1 100k
Multiple-Feedback Lowpass Filter with Gain
