Tommy270502/PM3/3_Technical_Documents/Analog_Signal_Processing/RC_lowpass_highpass.asc

C1: cap; 1n
C2: cap; 10µ
C3: cap; 10n
OpA: opamp
R1: res; 100k
R2: res; 1k
R3: res; 1Meg
Vgnd: voltage; 1.5
Vin: voltage; SINE(0 1m 50); AC 1
Named nets: 0, in, V_GND, out
.lib opamp.sub
.ac dec 10 1 100k
RC-Lowpass- and Highpass Filter with Gain
Highpass
Highpass
Lowpass
