Tommy270502/PM3/3_Technical_Documents/Analog_Signal_Processing/SK_lowpass.asc

C1: cap; 1n
C2: cap; 1n
C3: cap; 10n
OpA: opamp
R1: res; 160k
R2: res; 160k
R3: res; 1Meg
Vgnd: voltage; 1.5
Vin: voltage; SINE(0 1m 50); AC 1
Named nets: 0, in, V_GND, out
.lib opamp.sub
.ac dec 10 1 100k
Sallen-Key Lowpass Filter Without Gain
