Tommy270502/PM3/3_Technical_Documents/PCB/PM3_Audio_and_DMX_Template/PM3_Audio_and_DMX_Template/PM3_Audio_and_DMX.kicad_pcb

## KiCad design 3_Technical_Documents/PCB/PM3_Audio_and_DMX_Template/PM3_Audio_and_DMX_Template/PM3_Audio_and_DMX.kicad_pcb (2025-11-28)

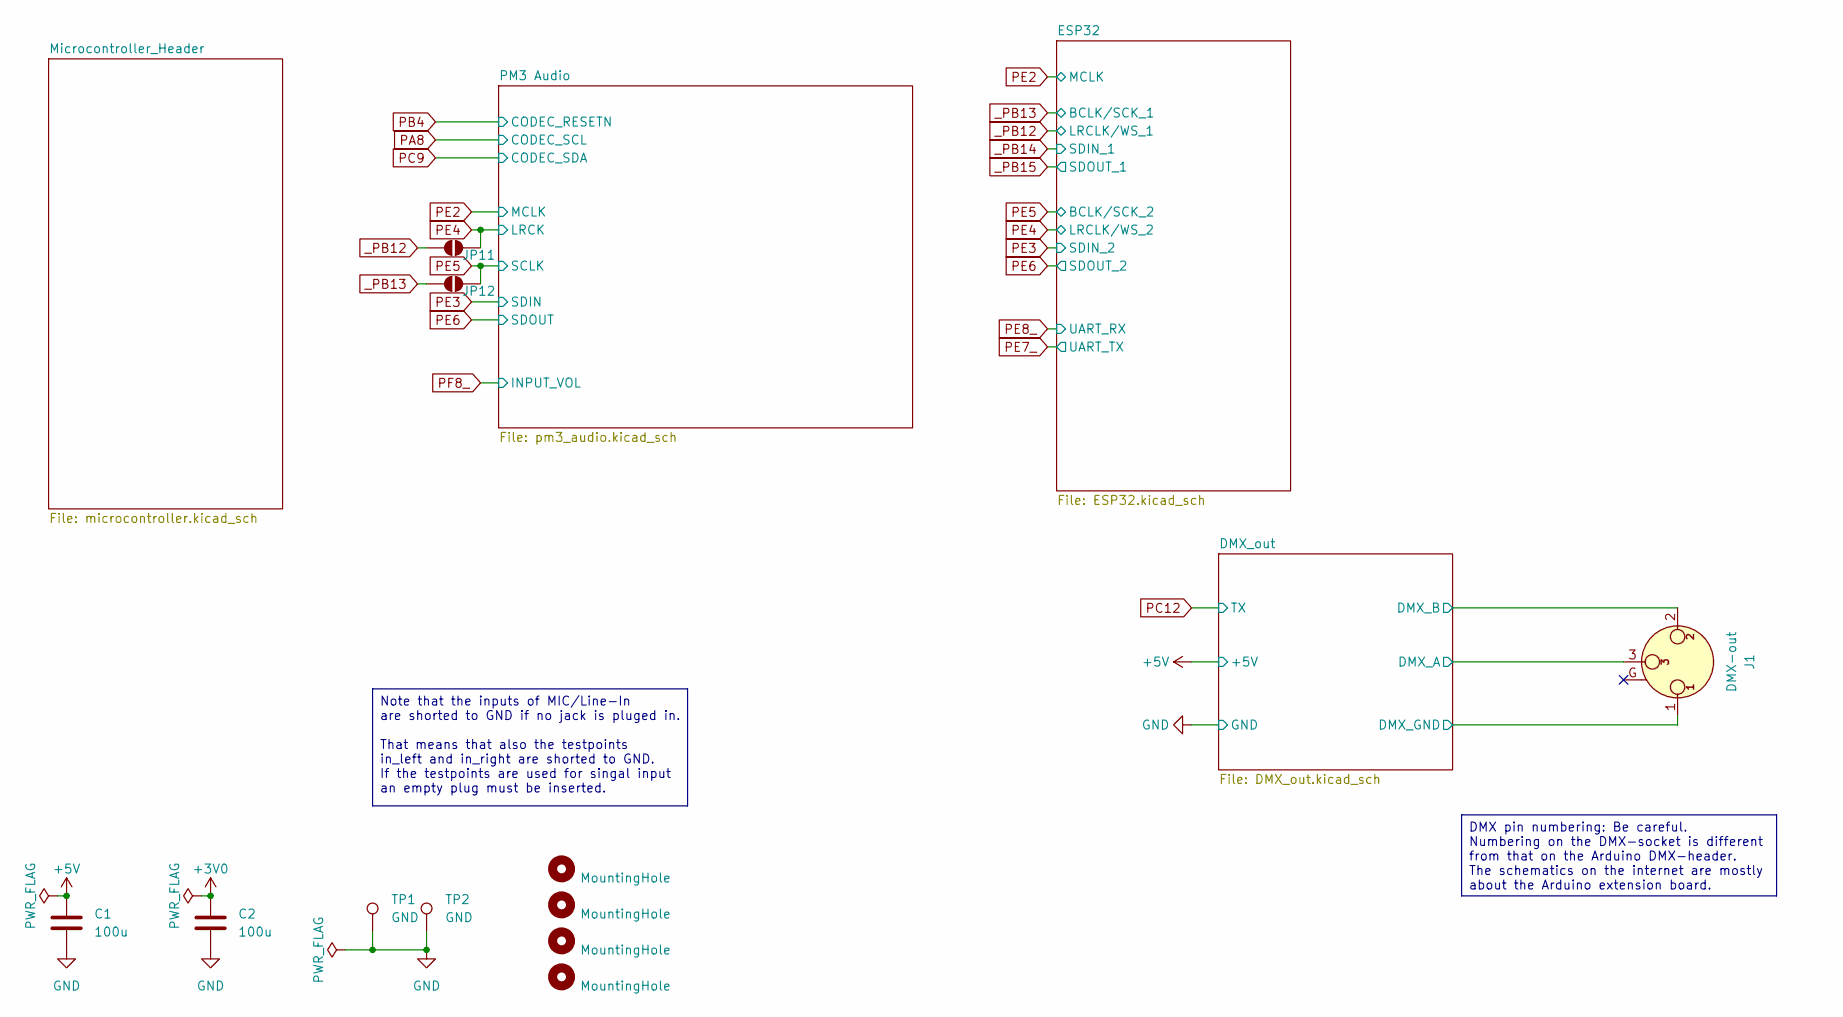
[picture p122: schematic PM3_Audio_and_DMX.kicad_sch, vU-meter & Light-organ: Prototype for ET.PM3]

Parts:
C1, C2: 100u; C_1206_3216Metric_Pad1.33x1.80mm_HandSolder; MPN C3216X5R1A107M160AC
H1, H2, H3, H4: MountingHole; MountingHole_3.2mm_M3_Pad_TopBottom
J1: DMX-out; Jack_XLR_Neutrik_NC3FAAH2_Horizontal
JP11, JP12: SolderJumper_2_Open; SolderJumper-2_P1.3mm_Open_RoundedPad1.0x1.5mm
TP1, TP2: GND; TestPoint_Loop_D2.60mm_Drill1.6mm_Beaded

Connections:
+5V: C1.1; also elsewhere on the board
/DMX_out/DMX_A: J1.3; also elsewhere on the board
/DMX_out/DMX_B: J1.2; also elsewhere on the board
DMX_GND: J1.1; also elsewhere on the board
GND: C1.2, C2.2, TP1.1, TP2.1; also elsewhere on the board
PE4: JP11.2 (B); also elsewhere on the board
PE5: JP12.2 (B); also elsewhere on the board
VL: C2.1; also elsewhere on the board
_PB12: JP11.1 (A); also elsewhere on the board
_PB13: JP12.1 (A); also elsewhere on the board

Notes on the sheet:
Note that the inputs of MIC/Line-In are shorted to GND if no jack is pluged in. That means that also the testpoints in_left and in_right are shorted to GND. If the testpoints are used for singal input an empty plug must be inserted.
DMX pin numbering: Be careful. Numbering on the DMX-socket is different from that on the Arduino DMX-header. The schematics on the internet are mostly about the Arduino extension board.

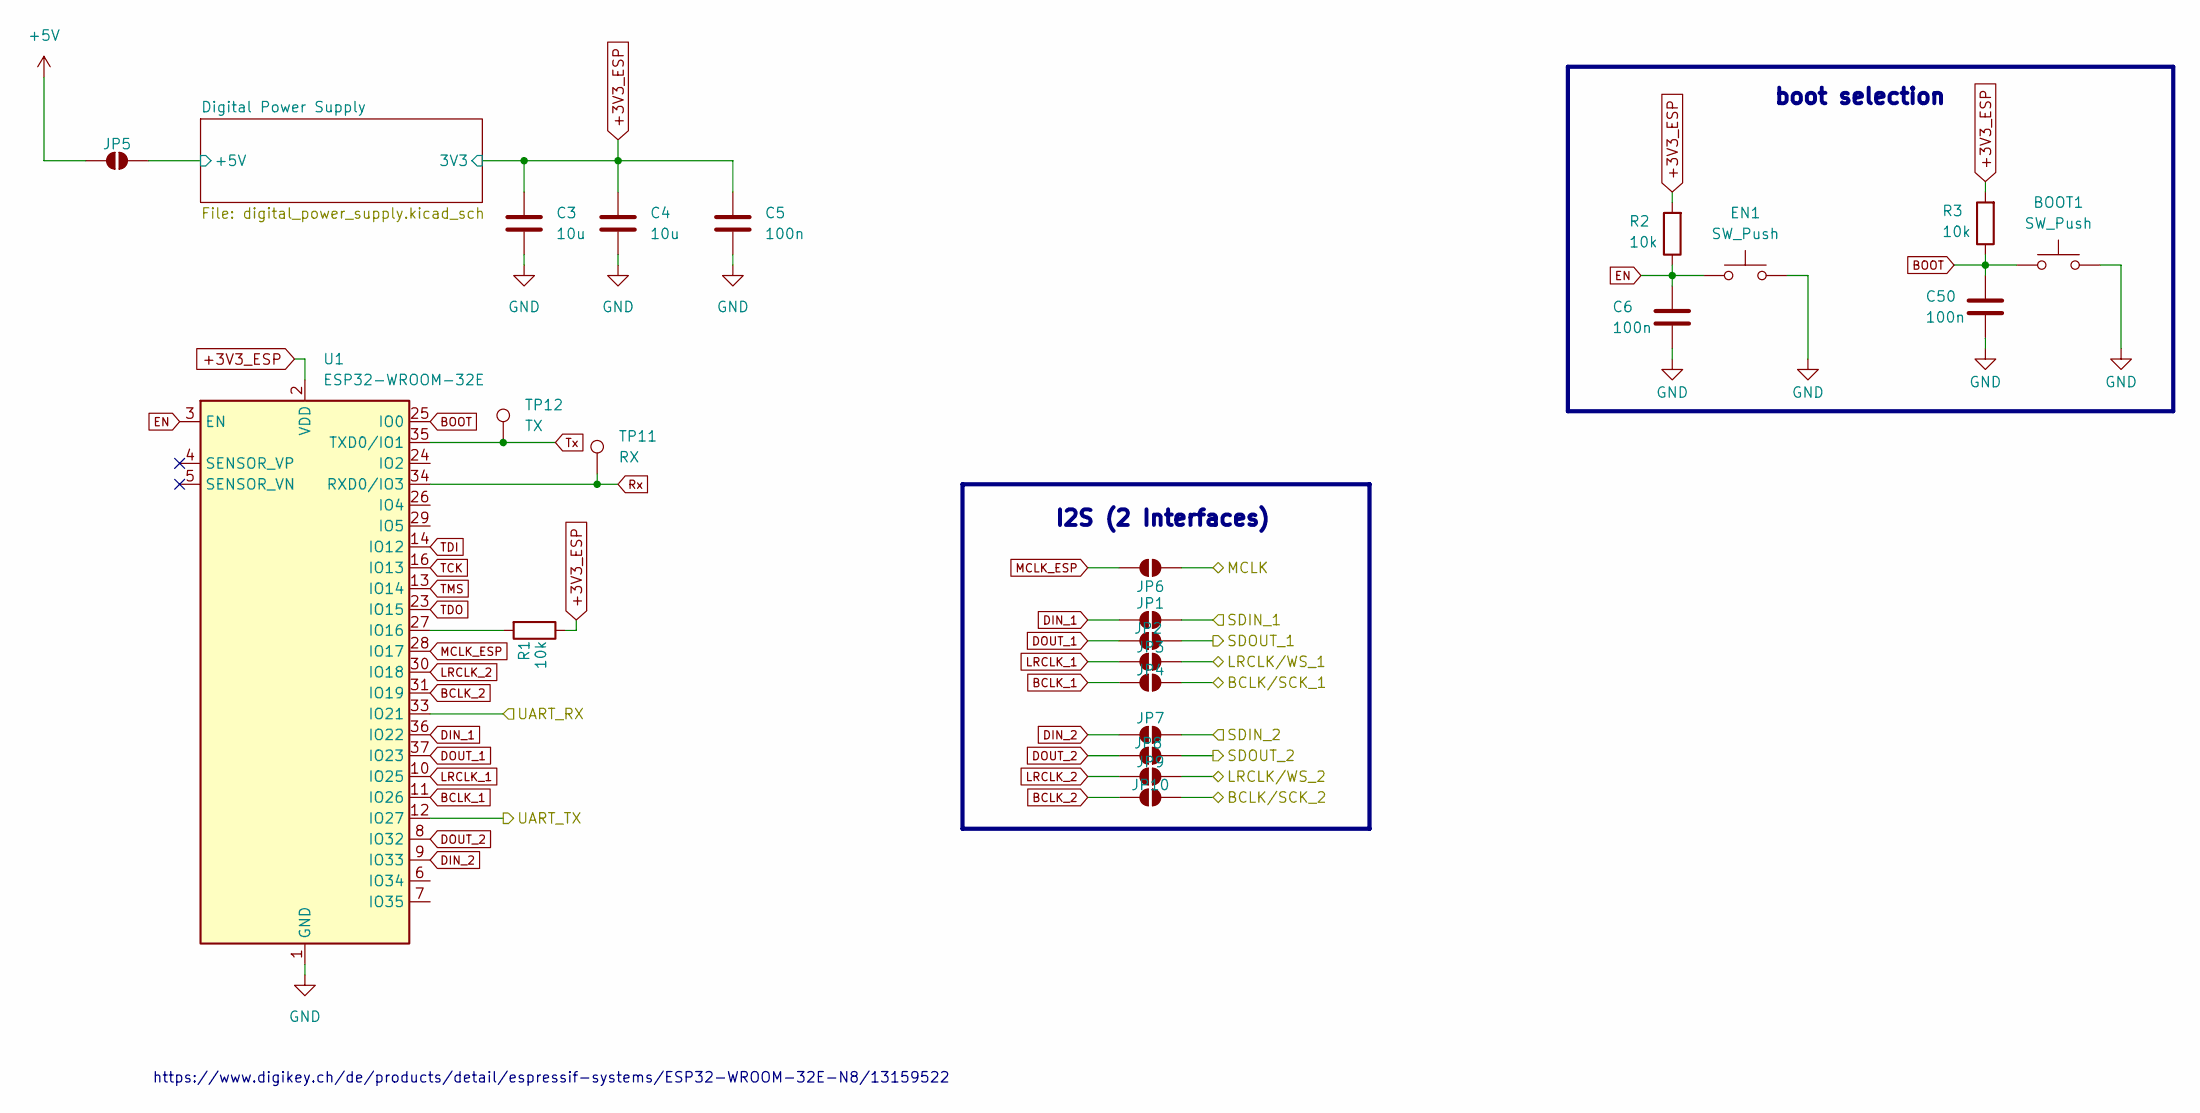
[picture p123: schematic ESP32.kicad_sch]

Parts:
BOOT1: SW_Push; SW_SPST_TL3342
C3, C4: 10u; C_1210_3225Metric; MPN GJ832ER7YA106KA12L
C5, C6, C50: 100n; C_0603_1608Metric; MPN GPC0603104-X7R
EN1: SW_Push; SW_SPST_TL3342
JP1, JP2, JP3, JP4, JP5, JP6, JP7, JP8, JP9, JP10: SolderJumper_2_Open; SolderJumper-2_P1.3mm_Open_RoundedPad1.0x1.5mm
R1, R2, R3: 10k; R_0603_1608Metric; MPN GPR060310K
TP11: RX
TP12: TX
U1: ESP32-WROOM-32E; ESP32-WROOM-32D

Connections:
+3V3_ESP: C3.1, C4.1, C5.1, R1.1, R2.2, R3.2, U1.2 (VDD); also elsewhere on the board
+5V: JP5.1 (A); also elsewhere on the board
/ESP32/Digital Power Supply/+5V: JP5.2 (B); also elsewhere on the board
BCLK_1: JP4.1 (A), U1.11 (IO26)
BCLK_2: JP10.1 (A), U1.31 (IO19)
BOOT: BOOT1.2, C50.1, R3.1, U1.25 (IO0)
DIN_1: JP1.1 (A), U1.36 (IO22)
DIN_2: JP7.1 (A), U1.9 (IO33)
DOUT_1: JP2.1 (A), U1.37 (IO23)
DOUT_2: JP8.1 (A), U1.8 (IO32)
EN: C6.1, EN1.2, R2.1, U1.3 (EN)
GND: BOOT1.1, C3.2, C4.2, C5.2, C6.2, C50.2, EN1.1, U1.1 (GND), U1.15 (GND), U1.38 (GND), U1.39 (GND); also elsewhere on the board
LRCLK_1: JP3.1 (A), U1.10 (IO25)
LRCLK_2: JP9.1 (A), U1.30 (IO18)
MCLK_ESP: JP6.1 (A), U1.28 (IO17)
unnamed: R1.2, U1.27 (IO16)
PE2: JP6.2 (B); also elsewhere on the board
PE3: JP7.2 (B); also elsewhere on the board
PE4: JP9.2 (B); also elsewhere on the board
PE5: JP10.2 (B); also elsewhere on the board
PE6: JP8.2 (B); also elsewhere on the board
PE7_: U1.12 (IO27); also elsewhere on the board
PE8_: U1.33 (IO21); also elsewhere on the board
Rx: TP11.1, U1.34 (RXD0/IO3)
TCK: U1.16 (IO13)
TDI: U1.14 (IO12)
TDO: U1.23 (IO15)
TMS: U1.13 (IO14)
Tx: TP12.1, U1.35 (TXD0/IO1)
_PB12: JP3.2 (B); also elsewhere on the board
_PB13: JP4.2 (B); also elsewhere on the board
_PB14: JP1.2 (B); also elsewhere on the board
_PB15: JP2.2 (B); also elsewhere on the board

Notes on the sheet:
boot selection
https://www.digikey.ch/de/products/detail/espressif-systems/ESP32-WROOM-32E-N8/13159522
I2S (2 Interfaces)

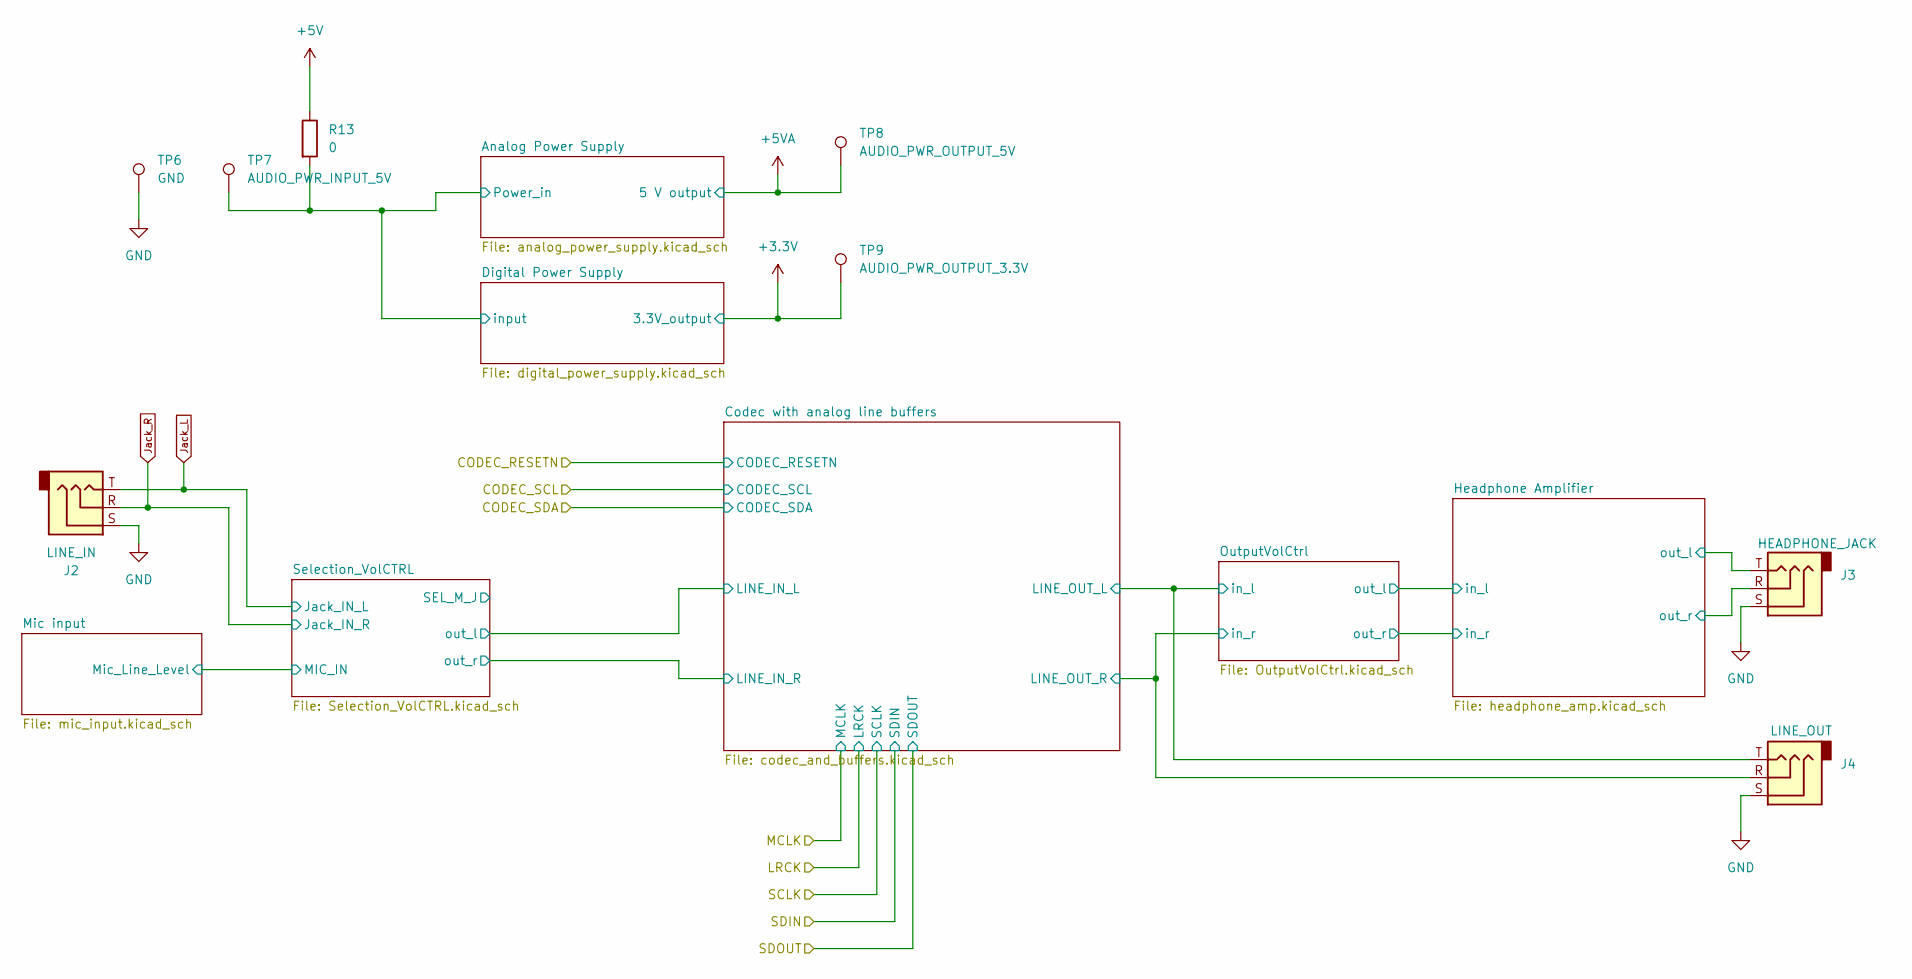
[picture p124: schematic pm3_audio.kicad_sch]

Parts:
J2: LINE_IN; Jack_3.5mm_CUI_SJ-3523-SMT_Horizontal; MPN SJ-3523-SMT-TR
J3: HEADPHONE_JACK; Jack_3.5mm_CUI_SJ-3523-SMT_Horizontal; MPN SJ-3523-SMT-TR
J4: LINE_OUT; Jack_3.5mm_CUI_SJ-3523-SMT_Horizontal; MPN SJ-3523-SMT-TR
R13: 0; R_0603_1608Metric; MPN GPR06030R
TP6: GND; TestPoint_Loop_D2.60mm_Drill1.6mm_Beaded
TP7: AUDIO_PWR_INPUT_5V; TestPoint_Loop_D2.60mm_Drill1.6mm_Beaded
TP8: AUDIO_PWR_OUTPUT_5V; TestPoint_Loop_D2.60mm_Drill1.6mm_Beaded
TP9: AUDIO_PWR_OUTPUT_3.3V; TestPoint_Loop_D2.60mm_Drill1.6mm_Beaded

Connections:
+5V: R13.1; also elsewhere on the board
/PM3 Audio/Analog Power Supply/Power_in: R13.2, TP7.1; also elsewhere on the board
/PM3 Audio/Codec with analog line buffers/LINE_OUT_L: J4.T; also elsewhere on the board
/PM3 Audio/Codec with analog line buffers/LINE_OUT_R: J4.R; also elsewhere on the board
/PM3 Audio/Headphone Amplifier/out_l: J3.T; also elsewhere on the board
/PM3 Audio/Headphone Amplifier/out_r: J3.R; also elsewhere on the board
GND: J2.S, J3.S, J4.S, TP6.1; also elsewhere on the board
Jack_L: J2.T; also elsewhere on the board
Jack_R: J2.R; also elsewhere on the board
VA: TP8.1; also elsewhere on the board
VD: TP9.1; also elsewhere on the board

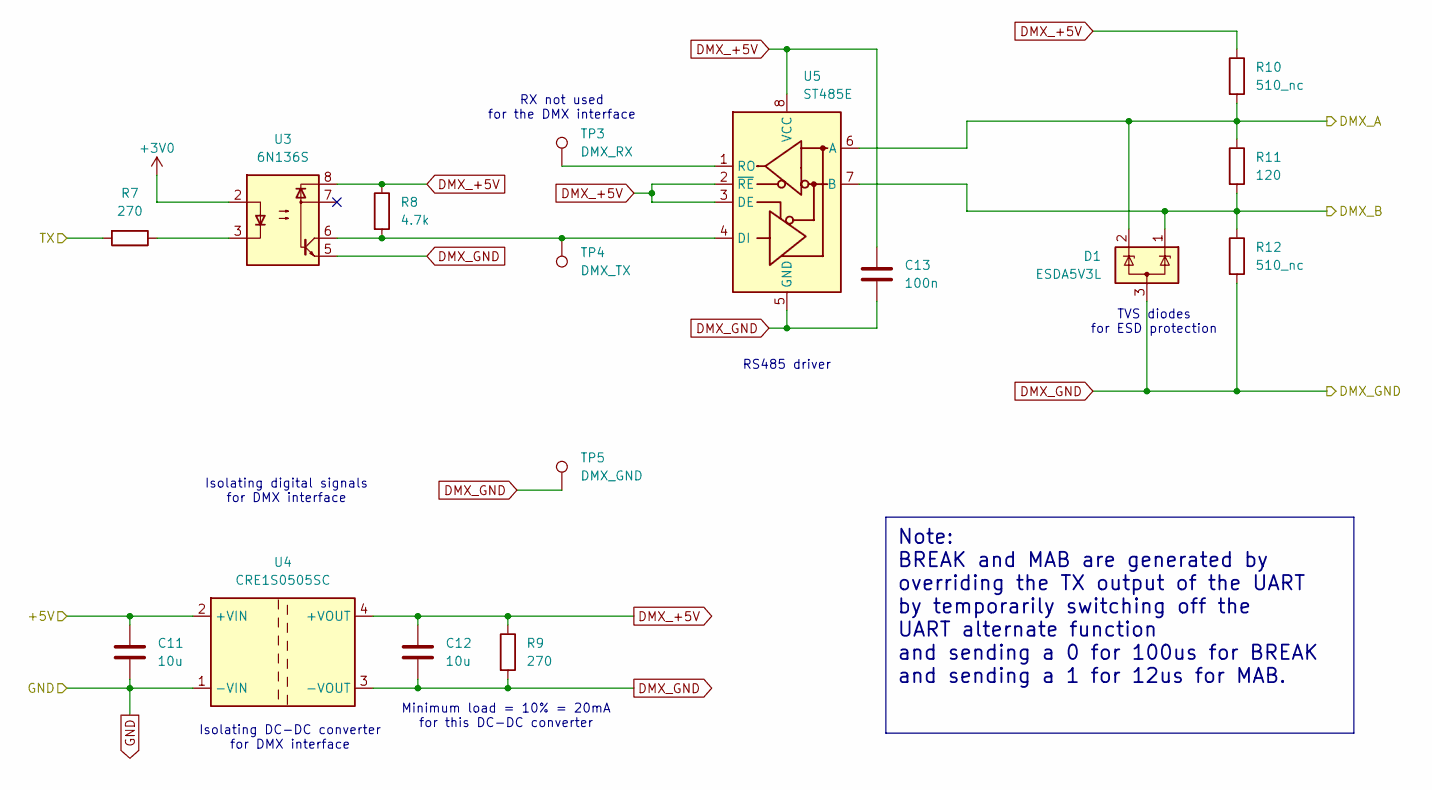
[picture p125: schematic DMX_out.kicad_sch, DMX output to LED party panel]

Parts:
C11, C12: 10u; C_0805_2012Metric_Pad1.18x1.45mm_HandSolder; MPN GPC0805106-35
C13: 100n; C_0805_2012Metric_Pad1.18x1.45mm_HandSolder; MPN GPC0805104
D1: ESDA5V3L; SOT-23-3; MPN ESDA5V3L
R7: 270; R_0603_1608Metric; MPN GPR0603270R
R8: 4.7k; R_0603_1608Metric; MPN GPR06034K7
R9: 270; R_0805_2012Metric; MPN GPR0805270R
R10, R12: 510_nc; R_0603_1608Metric
R11: 120; R_1206_3216Metric; MPN GPR1206120R
TP3: DMX_RX; TestPoint_Loop_D2.60mm_Drill1.6mm_Beaded
TP4: DMX_TX; TestPoint_Loop_D2.60mm_Drill1.6mm_Beaded
TP5: DMX_GND; TestPoint_Loop_D2.60mm_Drill1.6mm_Beaded
U3: 6N136S; SMDIP-8_W9.53mm; MPN 6N136S
U4: CRE1S0505SC; Converter_DCDC_Murata_CRE1xxxxxxSC_THT; MPN CRE1S0505SC
U5: ST485E; SOIC-8_3.9x4.9mm_P1.27mm; MPN ST485EBDR

Connections:
+5V: C11.1, U4.2 (+VIN); also elsewhere on the board
/DMX_out/DMX_A: D1.2 (K), R10.2, R11.1, U5.6 (A); also elsewhere on the board
/DMX_out/DMX_B: D1.1 (K), R11.2, R12.1, U5.7 (B); also elsewhere on the board
DMX_+5V: C12.1, C13.1, R8.1, R9.1, R10.1, U3.8, U4.4 (+VOUT), U5.2 (~RE), U5.3 (DE), U5.8 (VCC)
DMX_GND: C12.2, C13.2, D1.3 (A), R9.2, R12.2, TP5.1, U3.5, U4.3 (-VOUT), U5.5 (GND); also elsewhere on the board
GND: C11.2, U4.1 (-VIN); also elsewhere on the board
unnamed: R7.1, U3.3
unnamed: R8.2, TP4.1, U3.6, U5.4 (DI)
unnamed: TP3.1, U5.1 (RO)
PC12: R7.2; also elsewhere on the board
VL: U3.2; also elsewhere on the board

Notes on the sheet:
TVS diodes for ESD protection
Isolating digital signals for DMX interface
RX not used for the DMX interface
Minimum load = 10% = 20mA for this DC-DC converter
Isolating DC-DC converter for DMX interface
RS485 driver
Note: BREAK and MAB are generated by overriding the TX output of the UART by temporarily switching off the UART alternate function and sending a 0 for 100us for BREAK and sending a 1 for 12us for MAB.

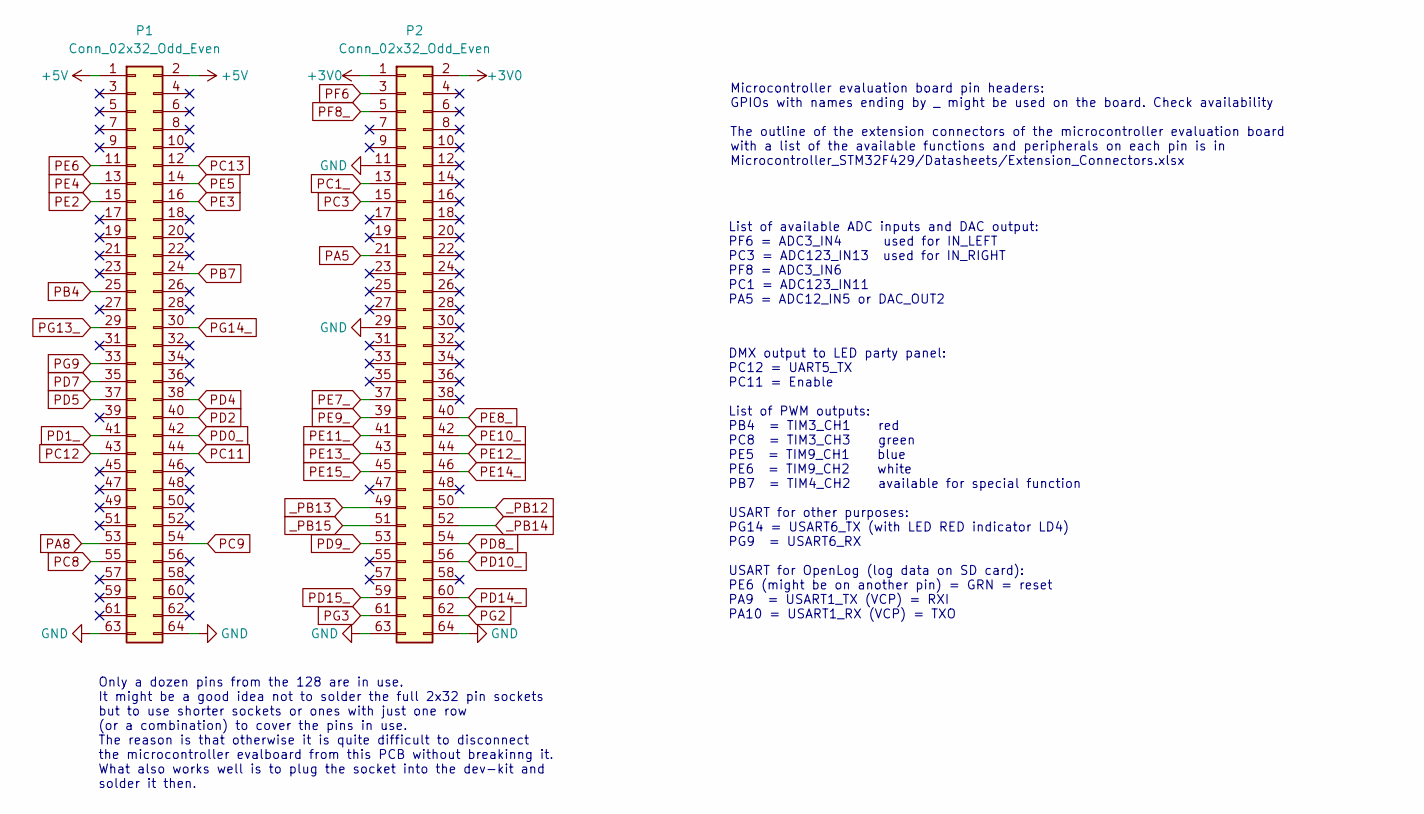
[picture p126: schematic microcontroller.kicad_sch, Microcontroller evaluation board header]

Parts:
P1, P2: Conn_02x32_Odd_Even; PinSocket_2x32_P2.54mm_Vertical

Connections:
+5V: P1.1, P1.2; also elsewhere on the board
GND: P1.63, P1.64, P2.11, P2.29, P2.63, P2.64; also elsewhere on the board
PA5: P2.21
PA8: P1.53; also elsewhere on the board
PB4: P1.25; also elsewhere on the board
PB7: P1.24
PC1_: P2.13
PC3: P2.15
PC8: P1.55
PC9: P1.54; also elsewhere on the board
PC11: P1.44
PC12: P1.43; also elsewhere on the board
PC13: P1.12
PD0_: P1.42
PD1_: P1.41
PD2: P1.40
PD4: P1.38
PD5: P1.37
PD7: P1.35
PD8_: P2.54
PD9_: P2.53
PD10_: P2.56
PD14_: P2.60
PD15_: P2.59
PE2: P1.15; also elsewhere on the board
PE3: P1.16; also elsewhere on the board
PE4: P1.13; also elsewhere on the board
PE5: P1.14; also elsewhere on the board
PE6: P1.11; also elsewhere on the board
PE7_: P2.37; also elsewhere on the board
PE8_: P2.40; also elsewhere on the board
PE9_: P2.39
PE10_: P2.42
PE11_: P2.41
PE12_: P2.44
PE13_: P2.43
PE14_: P2.46
PE15_: P2.45
PF6: P2.3
PF8_: P2.5
PG2: P2.62
PG3: P2.61
PG9: P1.33
PG13_: P1.29
PG14_: P1.30
VL: P2.1, P2.2; also elsewhere on the board
_PB12: P2.50; also elsewhere on the board
_PB13: P2.49; also elsewhere on the board
_PB14: P2.52; also elsewhere on the board
_PB15: P2.51; also elsewhere on the board

Notes on the sheet:
Only a dozen pins from the 128 are in use. It might be a good idea not to solder the full 2x32 pin sockets but to use shorter sockets or ones with just one row (or a combination) to cover the pins in use. The reason is that otherwise it is quite difficult to disconnect the microcontroller evalboard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
DMX output to LED party panel: PC12 = UART5_TX PC11 = Enable List of PWM outputs: PB4 = TIM3_CH1 red PC8 = TIM3_CH3 green PE5 = TIM9_CH1 blue PE6 = TIM9_CH2 white PB7 = TIM4_CH2 available for special function USART for other purposes: PG14 = USART6_TX (with LED RED indicator LD4) PG9 = USART6_RX US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
Microcontroller evaluation board pin headers: GPIOs with names ending by _ might be used on the board. Check availability The outline of the extension connectors of the microcontroller evaluation board with a list of the available functions and peripherals on each pin is in Microcontroller_STM32F42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
List of available ADC inputs and DAC output: PF6 = ADC3_IN4 used for IN_LEFT PC3 = ADC123_IN13 used for IN_RIGHT PF8 = ADC3_IN6 PC1 = ADC123_IN11 PA5 = ADC12_IN5 or DAC_OUT2

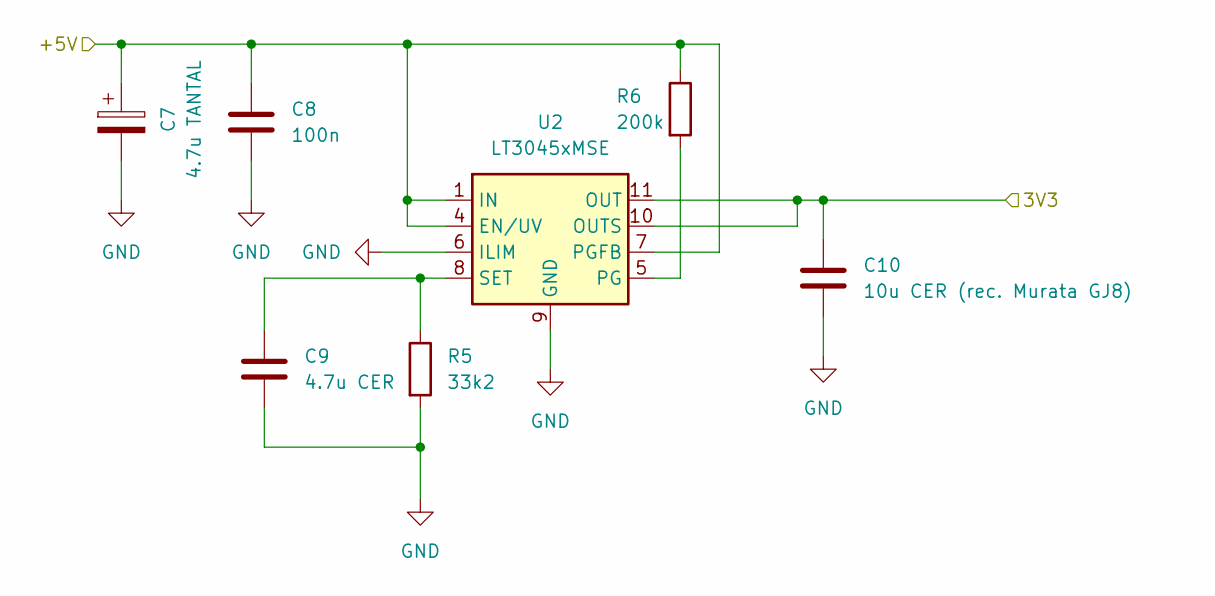
[picture p127: schematic digital_power_supply.kicad_sch]

Parts:
C7: 4.7u TANTAL; CP_EIA-3216-18_Kemet-A; MPN T495A475K010ATE1K3
C8: 100n; C_0603_1608Metric; MPN GPC0603104-X7R
C9: 4.7u CER; C_1210_3225Metric; MPN GPC1210475
C10: 10u CER (rec. Murata GJ8); C_1210_3225Metric; MPN GJ832ER7YA106KA12L
R5: 33k2; R_0603_1608Metric; MPN RC0603FR-0749K9L
R6: 200k; R_0603_1608Metric; MPN GPR0603200K
U2: LT3045xMSE; MSOP-12-1EP_3x4.039mm_P0.65mm_EP1.651x2.845mm; MPN LT3045EMSE

Connections:
+3V3_ESP: C10.1, U2.10 (OUTS), U2.11 (OUT), U2.12 (OUT); also elsewhere on the board
/ESP32/Digital Power Supply/+5V: C7.1, C8.1, R6.1, U2.1 (IN), U2.2 (IN), U2.3 (IN), U2.4 (EN/UV), U2.7 (PGFB); also elsewhere on the board
GND: C7.2, C8.2, C9.2, C10.2, R5.2, U2.6 (ILIM), U2.9 (GND), U2.13 (GND); also elsewhere on the board
unnamed: R6.2, U2.5 (PG)
unnamed: C9.1, R5.1, U2.8 (SET)

Parts of its further copies:
C26: 4.7u TANTAL; CP_EIA-3216-18_Kemet-A; MPN T495A475K010ATE1K3
C27: 100n; C_0603_1608Metric; MPN GPC0603104-X7R
C28: 4.7u CER; C_1210_3225Metric; MPN GPC1210475
C29: 10u CER (rec. Murata GJ8); C_1210_3225Metric; MPN GJ832ER7YA106KA12L
R26: 33k2; R_0603_1608Metric; MPN RC0603FR-0749K9L
R27: 200k; R_0603_1608Metric; MPN GPR0603200K
U9: LT3045xMSE; MSOP-12-1EP_3x4.039mm_P0.65mm_EP1.651x2.845mm; MPN LT3045EMSE

Connections of its further copies:
/PM3 Audio/Digital Power Supply/3V3: C29.1, U9.10 (OUTS), U9.11 (OUT), U9.12 (OUT)
/PM3 Audio/Digital Power Supply/+5V: C26.1, C27.1, R27.1, U9.1 (IN), U9.2 (IN), U9.3 (IN), U9.4 (EN/UV), U9.7 (PGFB)
GND: C26.2, C27.2, C28.2, C29.2, R26.2, U9.6 (ILIM), U9.9 (GND), U9.13 (GND); also elsewhere on the board
unnamed: R27.2, U9.5 (PG)
unnamed: C28.1, R26.1, U9.8 (SET)

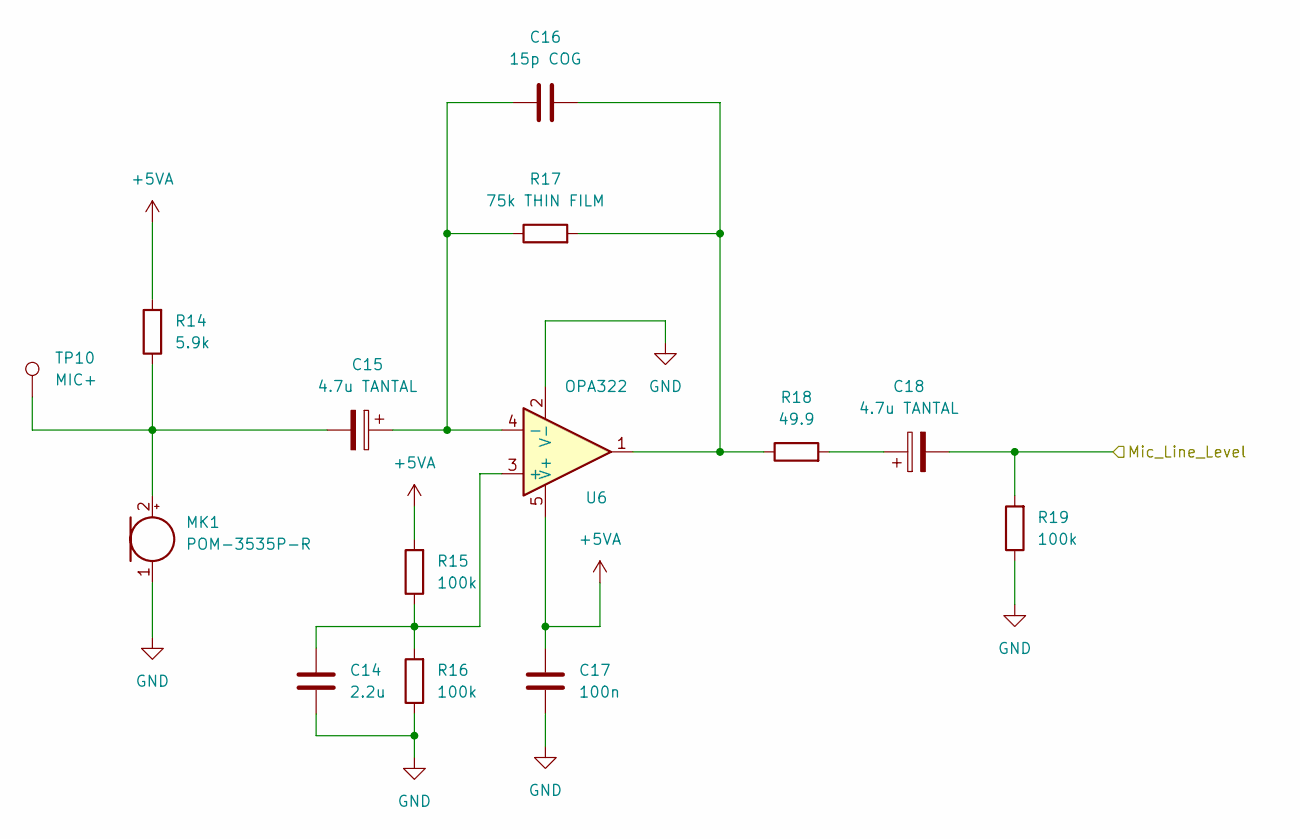
[picture p128: schematic mic_input.kicad_sch]

Parts:
C14: 2.2u; C_0805_2012Metric; MPN GPC0805225-25-X7R
C15, C18: 4.7u TANTAL; CP_EIA-3216-18_Kemet-A; MPN T495A475K010ATE1K3
C16: 15p COG; C_0603_1608Metric; MPN GPC0603150
C17: 100n; C_0603_1608Metric; MPN GPC0603104-X7R
MK1: POM-3535P-R; POM-2244P-C3310-2-R
R14: 5.9k; R_0603_1608Metric; MPN RT0603FRE075K9L
R15, R16, R19: 100k; R_0603_1608Metric; MPN GPR0603100K
R17: 75k THIN FILM; R_0603_1608Metric; MPN GPR060375K
R18: 49.9; R_0603_1608Metric; MPN 302-49.9-RC
TP10: MIC+; TestPoint_Loop_D2.60mm_Drill1.6mm_Beaded
U6: OPA322; SOT-23-5; MPN OPA322AIDBVT

Connections:
/PM3 Audio/Mic input/Mic_Line_Level: C18.2, R19.2; also elsewhere on the board
GND: C14.1, C17.1, MK1.1 (-), R16.1, R19.1, U6.2 (V-); also elsewhere on the board
unnamed: C16.2, R17.2, R18.1, U6.1
unnamed: C18.1, R18.2
unnamed: C15.2, MK1.2 (+), R14.1, TP10.1
unnamed: C14.2, R15.1, R16.2, U6.3 (+)
unnamed: C15.1, C16.1, R17.1, U6.4 (-)
VA: C17.2, R14.2, R15.2, U6.5 (V+); also elsewhere on the board

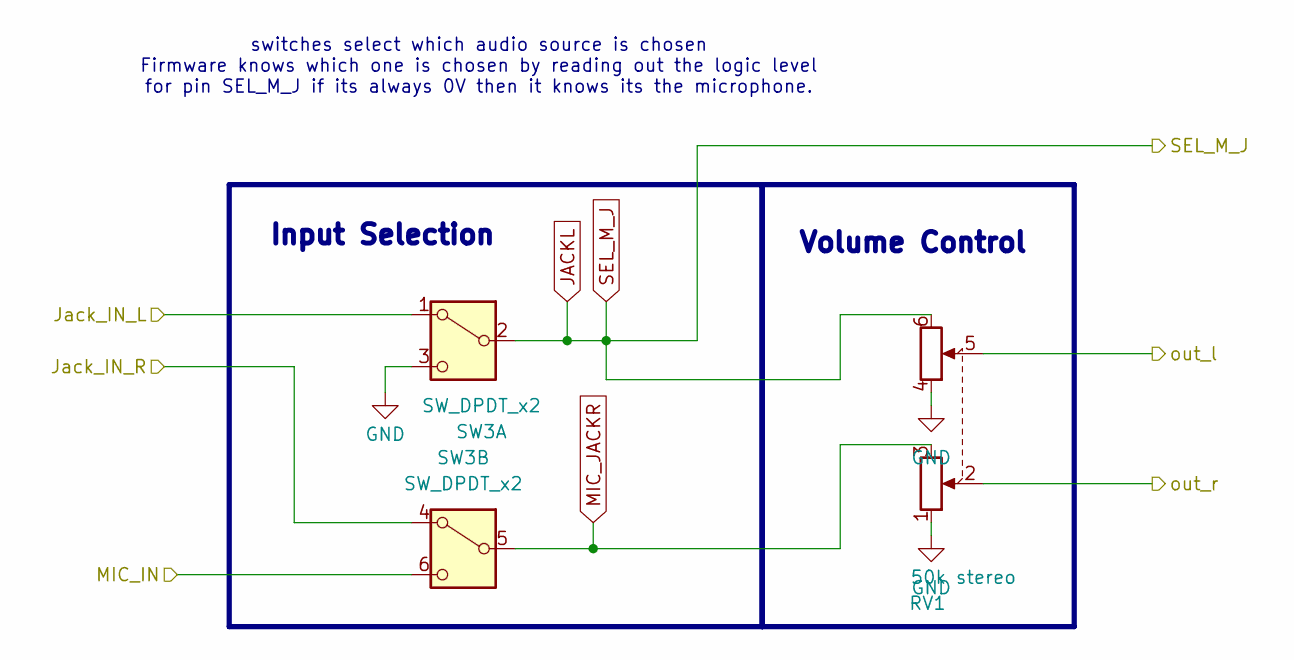
[picture p129: schematic Selection_VolCTRL.kicad_sch, Selection & Volume Control]

Parts:
RV1: 50k stereo; Potentiometer_Bourns_PTV112-4_Dual_Vertical
SW3: SW_DPDT_x2; SW_DPDT_CK_JS202011JCQN; MPN JS202011JCQN

Connections:
/PM3 Audio/Codec with analog line buffers/LINE_IN_L: RV1.5; also elsewhere on the board
/PM3 Audio/Codec with analog line buffers/LINE_IN_R: RV1.2; also elsewhere on the board
/PM3 Audio/Mic input/Mic_Line_Level: SW3.6 (C); also elsewhere on the board
GND: RV1.1, RV1.4, SW3.3 (C); also elsewhere on the board
JACKL: RV1.6, SW3.2 (B)
Jack_L: SW3.1 (A); also elsewhere on the board
Jack_R: SW3.4 (A); also elsewhere on the board
MIC_JACKR: RV1.3, SW3.5 (B)

Notes on the sheet:
switches select which audio source is chosen Firmware knows which one is chosen by reading out the logic level for pin SEL_M_J if its always 0V then it knows its the microphone.
Input Selection
Volume Control

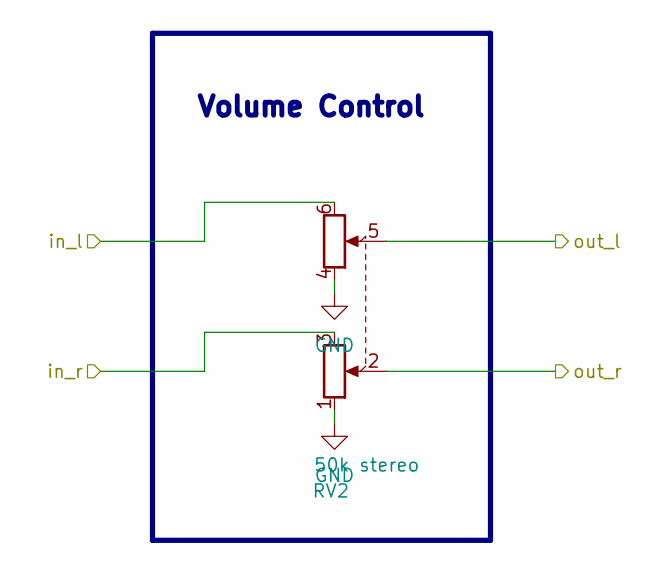
[picture p130: schematic OutputVolCtrl.kicad_sch]

Parts:
RV2: 50k stereo; Potentiometer_Bourns_PTV112-4_Dual_Vertical

Connections:
/PM3 Audio/Codec with analog line buffers/LINE_OUT_L: RV2.6; also elsewhere on the board
/PM3 Audio/Codec with analog line buffers/LINE_OUT_R: RV2.3; also elsewhere on the board
/PM3 Audio/Headphone Amplifier/in_l: RV2.5; also elsewhere on the board
/PM3 Audio/Headphone Amplifier/in_r: RV2.2; also elsewhere on the board
GND: RV2.1, RV2.4; also elsewhere on the board

Notes on the sheet:
Volume Control

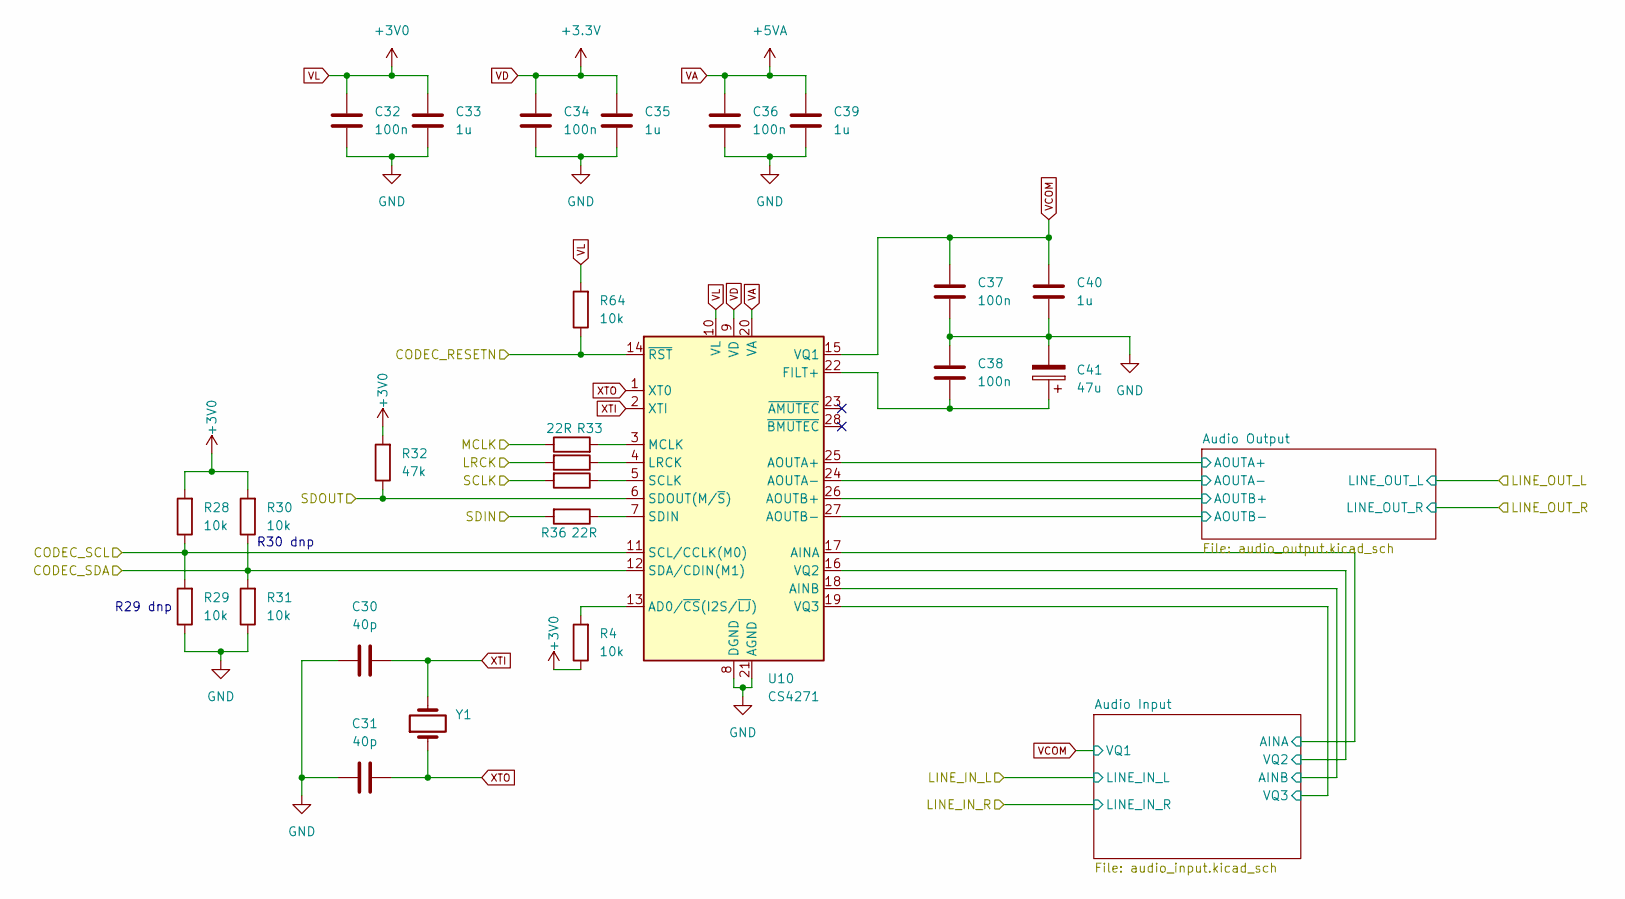
[picture p131: schematic codec_and_buffers.kicad_sch]

Parts:
C30, C31: 40p; C_0603_1608Metric; MPN GPC0603104-X7R
C32, C34, C36, C37, C38: 100n; C_0603_1608Metric; MPN GPC0603104-X7R
C33, C35, C39, C40: 1u; C_0805_2012Metric; MPN GPC0805105
C41: 47u; CP_Elec_6.3x7.7; MPN 865080645012
R4, R28, R29, R30, R31, R64: 10k; R_0603_1608Metric; MPN GPR060310K
R32: 47k; R_0603_1608Metric; MPN GPR060310K
R33, R34, R35, R36: 22R; R_0603_1608Metric; MPN GPR060310K
U10: CS4271; TSSOP-28_4.4x9.7mm_P0.65mm; MPN CS4271-CZZ
Y1: Crystal_SMD_5032-2Pin_5.0x3.2mm; MPN 445A22E24M57600

Connections:
/PM3 Audio/Codec with analog line buffers/Audio Input/AINA: U10.17 (AINA); also elsewhere on the board
/PM3 Audio/Codec with analog line buffers/Audio Input/AINB: U10.18 (AINB); also elsewhere on the board
/PM3 Audio/Codec with analog line buffers/Audio Output/AOUTA+: U10.25 (AOUTA+); also elsewhere on the board
/PM3 Audio/Codec with analog line buffers/Audio Output/AOUTA-: U10.24 (AOUTA-); also elsewhere on the board
/PM3 Audio/Codec with analog line buffers/Audio Output/AOUTB+: U10.26 (AOUTB+); also elsewhere on the board
/PM3 Audio/Codec with analog line buffers/Audio Output/AOUTB-: U10.27 (AOUTB-); also elsewhere on the board
GND: C30.1, C31.1, C32.2, C33.2, C34.2, C35.2, C36.2, C37.2, C38.1, C39.2, C40.2, C41.2, R29.1, R31.1, U10.8 (DGND), U10.21 (AGND); also elsewhere on the board
unnamed: R4.2, U10.13 (AD0/~CS(I2S/~LJ))
unnamed: C38.2, C41.1, U10.22 (FILT+)
unnamed: R34.1, U10.4 (LRCK)
unnamed: R33.2, U10.3 (MCLK)
unnamed: R35.1, U10.5 (SCLK)
unnamed: R36.1, U10.7 (SDIN)
PA8: R28.1, R29.2, U10.11 (SCL/CCLK(M0)); also elsewhere on the board
PB4: R64.1, U10.14 (~RST); also elsewhere on the board
PC9: R30.1, R31.2, U10.12 (SDA/CDIN(M1)); also elsewhere on the board
PE2: R33.1; also elsewhere on the board
PE3: R36.2; also elsewhere on the board
PE4: R34.2; also elsewhere on the board
PE5: R35.2; also elsewhere on the board
PE6: R32.1, U10.6 (SDOUT(M/~S)); also elsewhere on the board
VA: C36.1, C39.1, U10.20 (VA); also elsewhere on the board
VCOM: C37.1, C40.1, U10.15 (VQ1), U10.16 (VQ2), U10.19 (VQ3); also elsewhere on the board
VD: C34.1, C35.1, U10.9 (VD); also elsewhere on the board
VL: C32.1, C33.1, R4.1, R28.2, R30.2, R32.2, R64.2, U10.10 (VL); also elsewhere on the board
XTI: C30.2, U10.2 (XTI), Y1.2
XTO: C31.2, U10.1 (XT0), Y1.1

Notes on the sheet:
R30 dnp
R29 dnp
