Tommy270502/PM3/3_Technical_Documents/PCB/PM3_Audio_and_DMX_Template/PM3_Audio_and_DMX_Template/PM3_Audio_and_DMX.kicad_pcb

## KiCad design 3_Technical_Documents/PCB/PM3_Audio_and_DMX_Template/PM3_Audio_and_DMX_Template/PM3_Audio_and_DMX.kicad_pcb (continued)

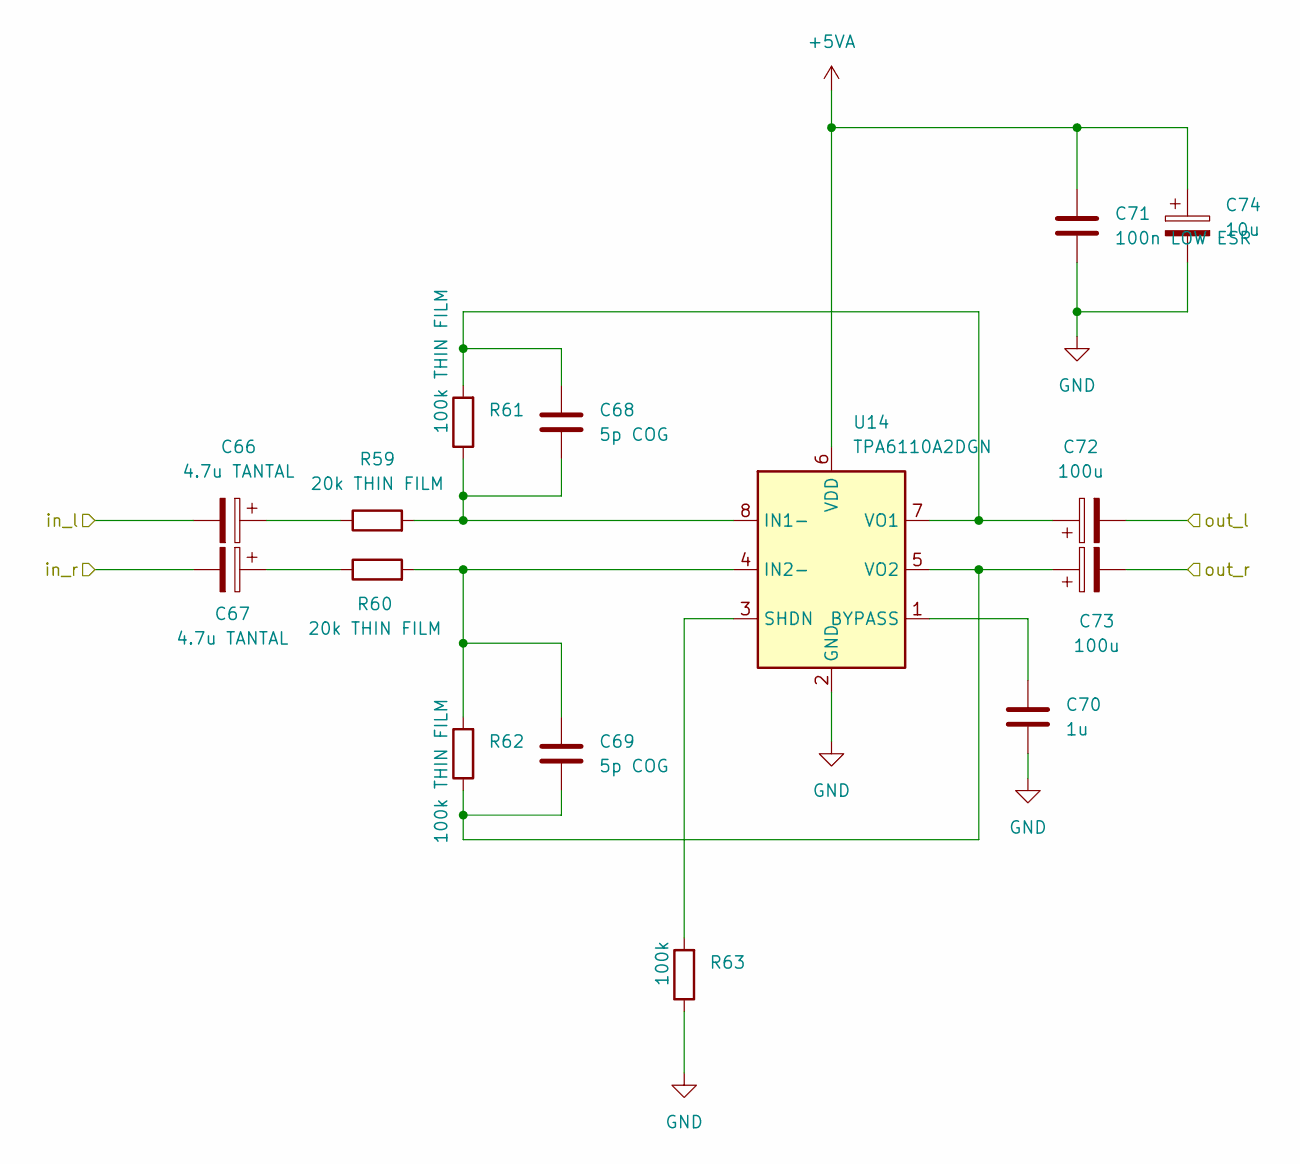
[picture p132: schematic headphone_amp.kicad_sch]

Parts:
C66, C67: 4.7u TANTAL; CP_EIA-3216-18_Kemet-A; MPN T495A475K010ATE1K3
C68, C69: 5p COG; C_0603_1608Metric; MPN 06035A5R0CAT2A
C70: 1u; C_0805_2012Metric; MPN GPC0805105
C71: 100n LOW ESR; C_0603_1608Metric; MPN GPC0603104-X7R
C72, C73: 100u; CP_Elec_6.3x7.7; MPN 865060445005
C74: 10u; CP_Elec_6.3x7.7; MPN EEE-1HA100AP
R59, R60: 20k THIN FILM; R_0603_1608Metric; MPN GPR060320K
R61, R62: 100k THIN FILM; R_0603_1608Metric; MPN GPR0603100K
R63: 100k; R_0603_1608Metric; MPN GPR0603100K
U14: TPA6110A2DGN; HVSSOP-8-1EP_3x3mm_P0.65mm_EP1.57x1.89mm; MPN TPA6110A2DGN

Connections:
/PM3 Audio/Headphone Amplifier/in_l: C66.2; also elsewhere on the board
/PM3 Audio/Headphone Amplifier/in_r: C67.2; also elsewhere on the board
/PM3 Audio/Headphone Amplifier/out_l: C72.2; also elsewhere on the board
/PM3 Audio/Headphone Amplifier/out_r: C73.2; also elsewhere on the board
GND: C70.2, C71.2, C74.2, R63.1, U14.2 (GND), U14.9 (GND); also elsewhere on the board
unnamed: C66.1, R59.1
unnamed: C67.1, R60.1
unnamed: C70.1, U14.1 (BYPASS)
unnamed: C68.2, R59.2, R61.1, U14.8 (IN1-)
unnamed: C69.1, R60.2, R62.2, U14.4 (IN2-)
unnamed: R63.2, U14.3 (SHDN)
unnamed: C68.1, C72.1, R61.2, U14.7 (VO1)
unnamed: C69.2, C73.1, R62.1, U14.5 (VO2)
VA: C71.1, C74.1, U14.6 (VDD); also elsewhere on the board

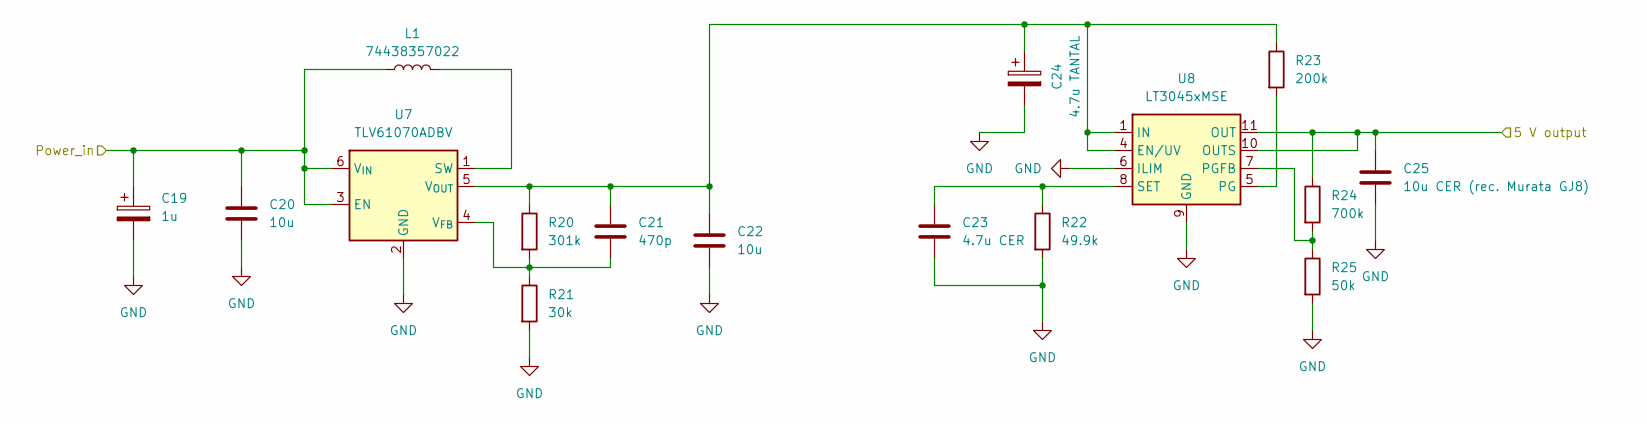
[picture p133: schematic analog_power_supply.kicad_sch]

Parts:
C19: 1u; CP_Elec_4x5.8; MPN EEE1HA010SR
C20, C22: 10u; C_1210_3225Metric; MPN GPC1210106
C21: 470p; C_0603_1608Metric; MPN GPC0603471
C23: 4.7u CER; C_1210_3225Metric; MPN GPC1210475
C24: 4.7u TANTAL; CP_EIA-3216-18_Kemet-A; MPN T495A475K010ATE1K3
C25: 10u CER (rec. Murata GJ8); C_1210_3225Metric; MPN GJ832ER7YA106KA12L
L1: 74438357022; L_Wuerth_MAPI-4030; MPN 74438357022
R20: 301k; R_0603_1608Metric
R21: 30k; R_0603_1608Metric; MPN GPR060330K
R22: 49.9k; R_0603_1608Metric; MPN RC0603FR-0749K9L
R23: 200k; R_0603_1608Metric; MPN GPR0603200K
R24: 700k; R_0603_1608Metric; MPN RMC1/16K6983DTP
R25: 50k; R_0603_1608Metric; MPN RC0603FR-0749K9L
U7: TLV61070ADBV; SOT-23-6; MPN TLV61070ADBVR
U8: LT3045xMSE; MSOP-12-1EP_3x4.039mm_P0.65mm_EP1.651x2.845mm; MPN LT3045EMSE

Connections:
/PM3 Audio/Analog Power Supply/Power_in: C19.1, C20.1, L1.1, U7.3 (EN), U7.6 (V_{IN}); also elsewhere on the board
GND: C19.2, C20.2, C22.2, C23.2, C24.2, C25.2, R21.2, R22.2, R25.2, U7.2 (GND), U8.6 (ILIM), U8.9 (GND), U8.13 (GND); also elsewhere on the board
unnamed: L1.2, U7.1 (SW)
unnamed: C21.2, R20.2, R21.1, U7.4 (V_{FB})
unnamed: C21.1, C22.1, C24.1, R20.1, R23.1, U7.5 (V_{OUT}), U8.1 (IN), U8.2 (IN), U8.3 (IN), U8.4 (EN/UV)
unnamed: R23.2, U8.5 (PG)
unnamed: R24.2, R25.1, U8.7 (PGFB)
unnamed: C23.1, R22.1, U8.8 (SET)
VA: C25.1, R24.1, U8.10 (OUTS), U8.11 (OUT), U8.12 (OUT); also elsewhere on the board

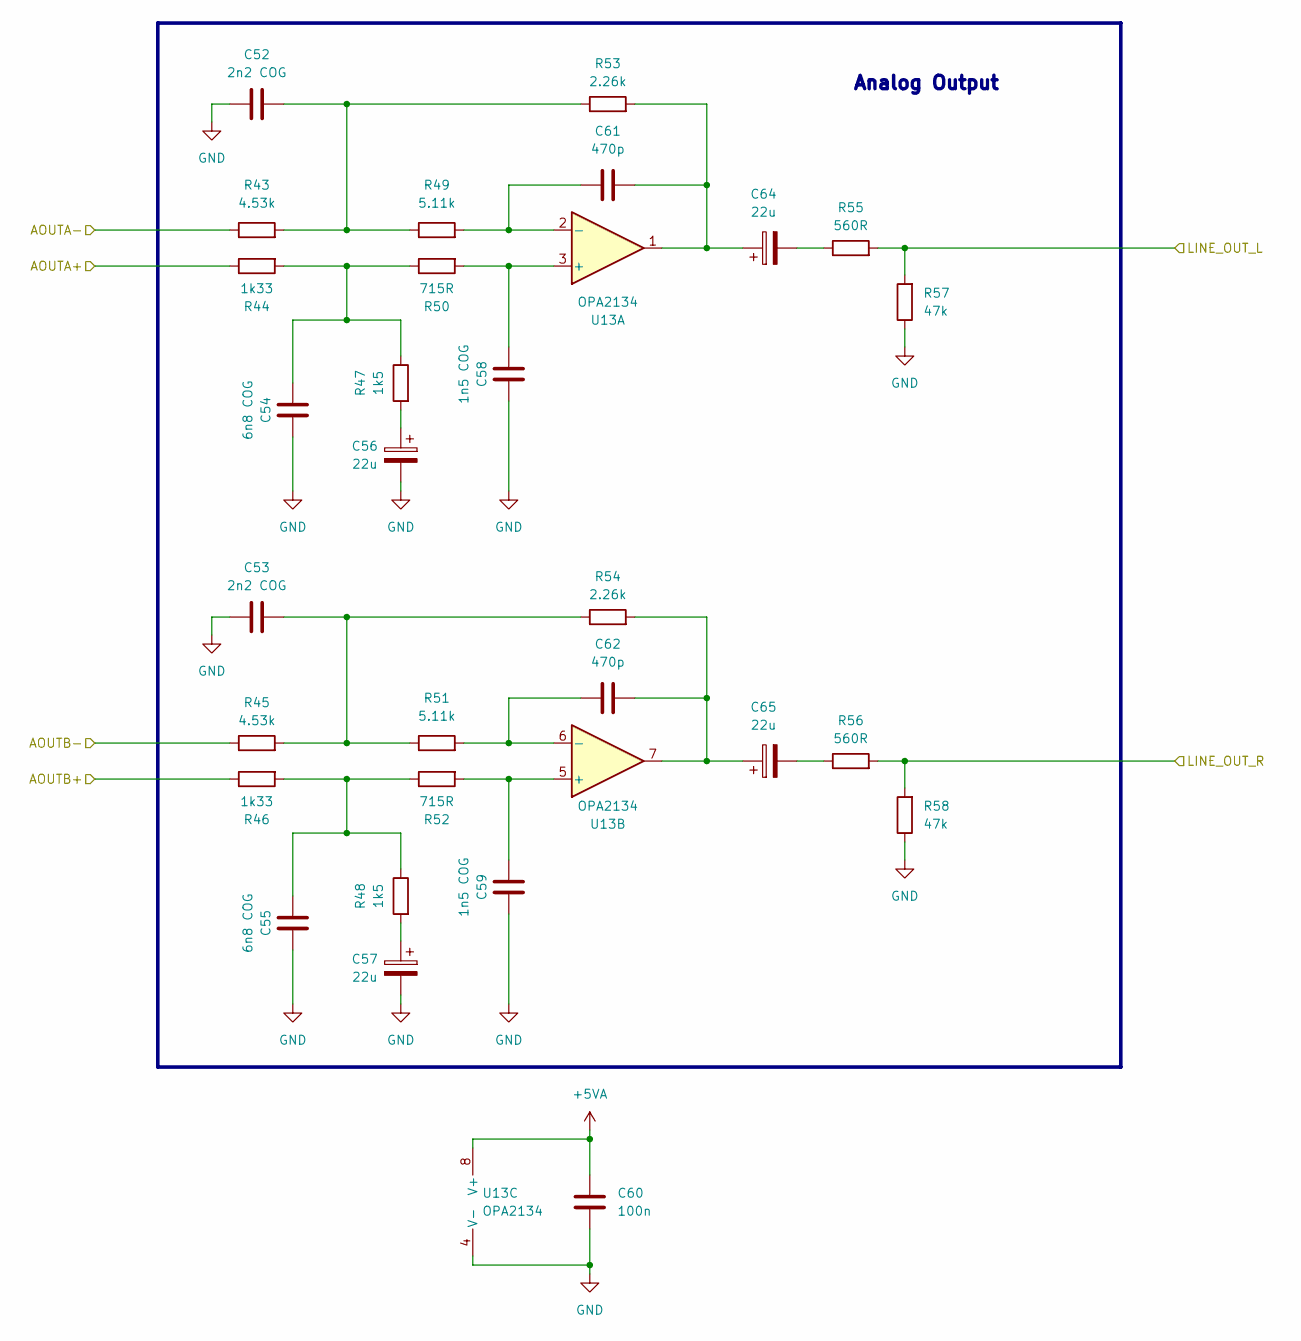
[picture p134: schematic audio_output.kicad_sch]

Parts:
C52, C53: 2n2 COG; C_0603_1608Metric; MPN GPC0603222-C0G
C54, C55: 6n8 COG; C_0603_1608Metric; MPN GPC0603222-C0G
C56, C57, C64, C65: 22u; CP_Elec_6.3x7.7; MPN 865060543003
C58, C59: 1n5 COG; C_0603_1608Metric; MPN GPC0603222-C0G
C60: 100n; C_0603_1608Metric; MPN GPC0603104-X7R
C61, C62: 470p; C_0603_1608Metric; MPN GPC0603222-C0G
R43, R45: 4.53k; R_0603_1608Metric
R44, R46: 1k33; R_0603_1608Metric; MPN CPF0603F4K99C1
R47, R48: 1k5; R_0603_1608Metric; MPN CPF0603F4K99C1
R49, R51: 5.11k; R_0603_1608Metric
R50, R52: 715R; R_0603_1608Metric; MPN CPF0603F4K99C1
R53, R54: 2.26k; R_0603_1608Metric
R55, R56: 560R; R_0603_1608Metric; MPN CPF0603F4K99C1
R57, R58: 47k; R_0603_1608Metric; MPN CPF0603F4K99C1
U13: OPA2134; SOIC-8_3.9x4.9mm_P1.27mm; MPN OPA2134UA

Connections:
/PM3 Audio/Codec with analog line buffers/Audio Output/AOUTA+: R44.1; also elsewhere on the board
/PM3 Audio/Codec with analog line buffers/Audio Output/AOUTA-: R43.1; also elsewhere on the board
/PM3 Audio/Codec with analog line buffers/Audio Output/AOUTB+: R46.1; also elsewhere on the board
/PM3 Audio/Codec with analog line buffers/Audio Output/AOUTB-: R45.1; also elsewhere on the board
/PM3 Audio/Codec with analog line buffers/LINE_OUT_L: R55.2, R57.2; also elsewhere on the board
/PM3 Audio/Codec with analog line buffers/LINE_OUT_R: R56.2, R58.2; also elsewhere on the board
GND: C52.1, C53.1, C54.1, C55.1, C56.2, C57.2, C58.1, C59.1, C60.2, R57.1, R58.1, U13.4 (V-); also elsewhere on the board
unnamed: C52.2, R43.2, R49.1, R53.1
unnamed: C53.2, R45.2, R51.1, R54.1
unnamed: C54.2, R44.2, R47.1, R50.1
unnamed: C55.2, R46.2, R48.1, R52.1
unnamed: C56.1, R47.2
unnamed: C57.1, R48.2
unnamed: C61.2, C64.1, R53.2, U13.1
unnamed: C62.2, C65.1, R54.2, U13.7
unnamed: C64.2, R55.1
unnamed: C65.2, R56.1
unnamed: C58.2, R50.2, U13.3 (+)
unnamed: C61.1, R49.2, U13.2 (-)
unnamed: C59.2, R52.2, U13.5 (+)
unnamed: C62.1, R51.2, U13.6 (-)
VA: C60.1, U13.8 (V+); also elsewhere on the board

Notes on the sheet:
Analog Output

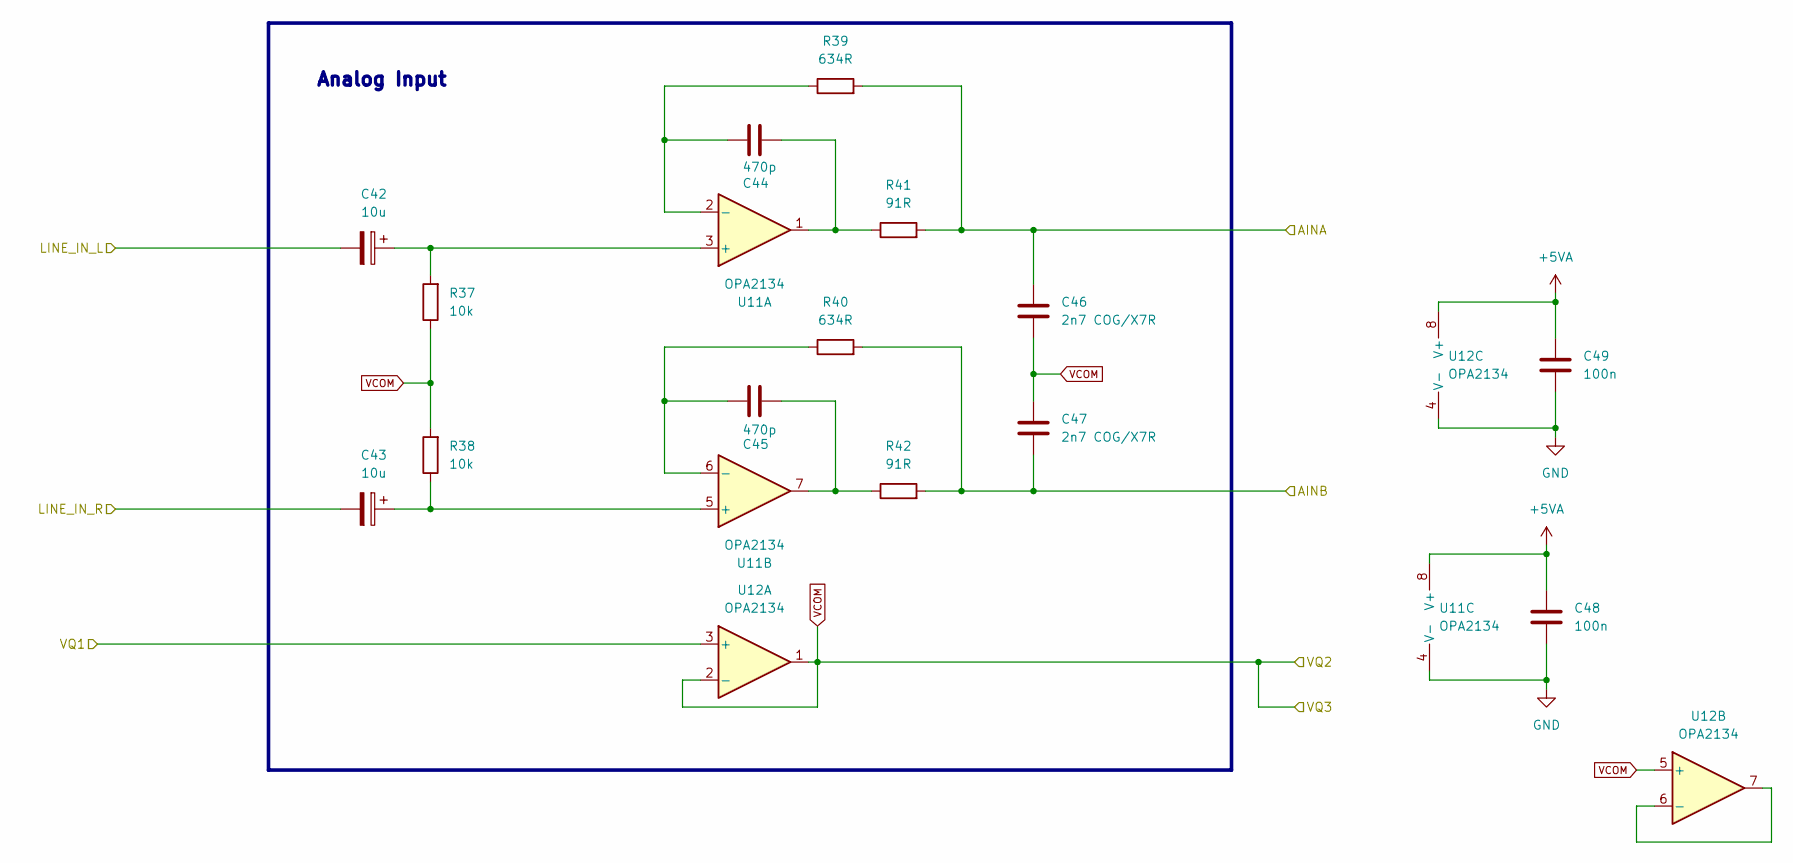
[picture p135: schematic audio_input.kicad_sch]

Parts:
C42, C43: 10u; CP_Elec_4x5.8; MPN EEE1HA010SR
C44, C45: 470p; C_0603_1608Metric; MPN GPC0603103
C46, C47: 2n7 COG/X7R; C_0603_1608Metric; MPN GPC0603103
C48, C49: 100n; C_0603_1608Metric; MPN GPC0603104-X7R
R37, R38: 10k; R_0603_1608Metric; MPN GPR060310K
R39, R40: 634R; R_0603_1608Metric; MPN GPR060310K
R41, R42: 91R; R_0603_1608Metric; MPN GPR060310K
U11: OPA2134; SOIC-8_3.9x4.9mm_P1.27mm; MPN OPA2134UA
U12: OPA2134; SOIC-8_3.9x4.9mm_P1.27mm

Connections:
/PM3 Audio/Codec with analog line buffers/Audio Input/AINA: C46.1, R39.2, R41.2; also elsewhere on the board
/PM3 Audio/Codec with analog line buffers/Audio Input/AINB: C47.2, R40.2, R42.2; also elsewhere on the board
/PM3 Audio/Codec with analog line buffers/LINE_IN_L: C42.2; also elsewhere on the board
/PM3 Audio/Codec with analog line buffers/LINE_IN_R: C43.2; also elsewhere on the board
GND: C48.2, C49.2, U11.4 (V-), U12.4 (V-); also elsewhere on the board
unnamed: C44.1, R41.1, U11.1
unnamed: C45.1, R42.1, U11.7
unnamed: C42.1, R37.2, U11.3 (+)
unnamed: C44.2, R39.1, U11.2 (-)
unnamed: C43.1, R38.1, U11.5 (+)
unnamed: C45.2, R40.1, U11.6 (-)
unnamed: U12.6 (-), U12.7
VA: C48.1, C49.1, U11.8 (V+), U12.8 (V+); also elsewhere on the board
VCOM: C46.2, C47.1, R37.1, R38.2, U12.1, U12.2 (-), U12.3 (+), U12.5 (+); also elsewhere on the board

Notes on the sheet:
Analog Input

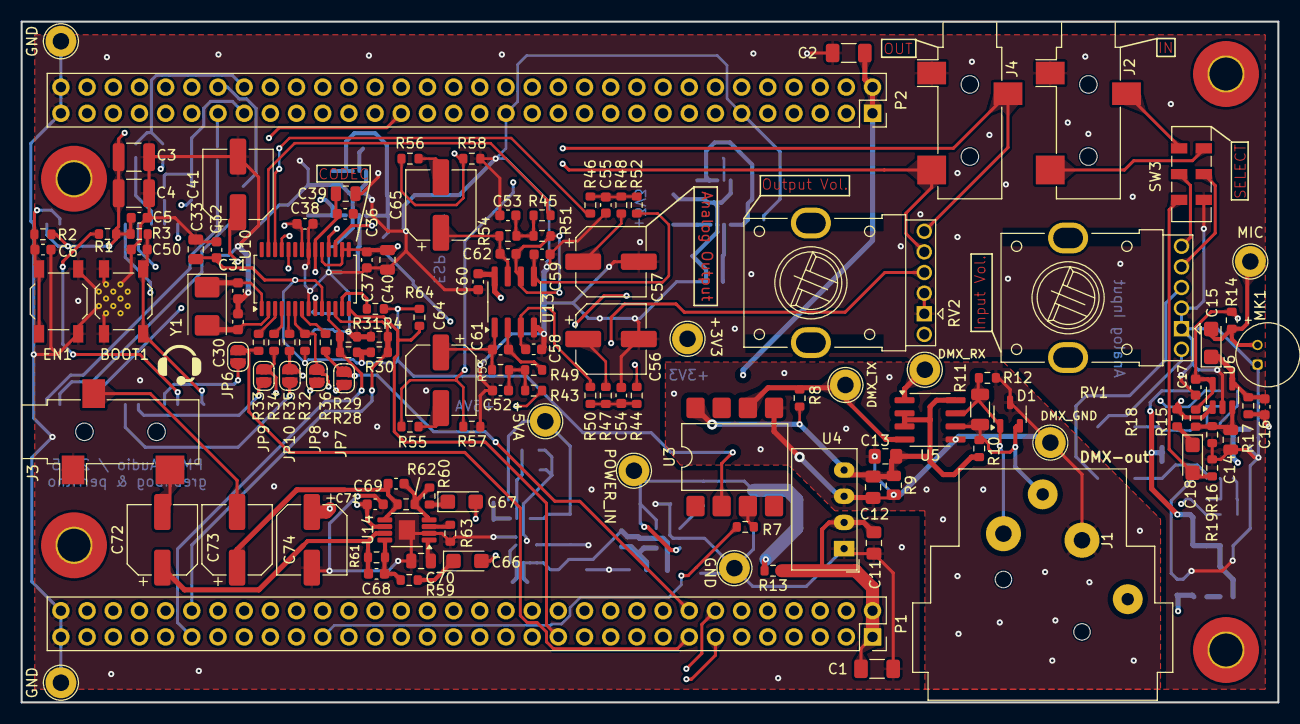
[picture p136: board PM3_Audio_and_DMX.kicad_pcb from above]

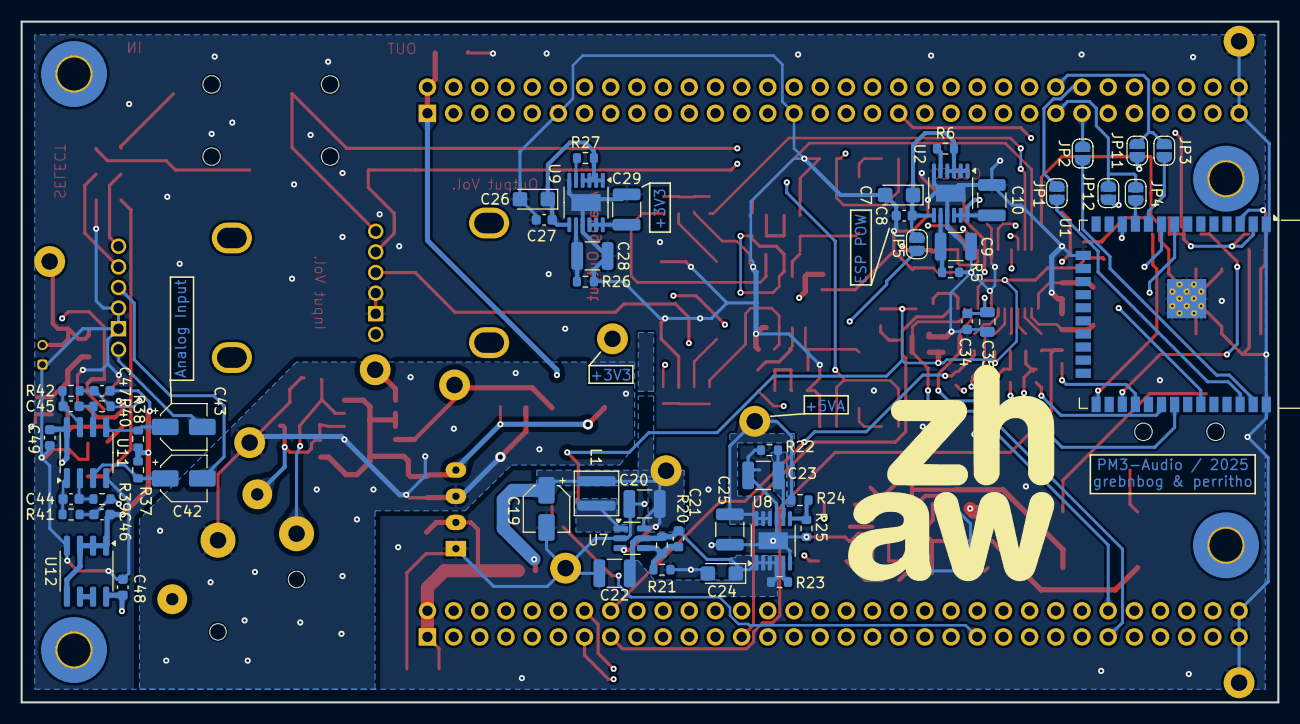
[picture p137: board PM3_Audio_and_DMX.kicad_pcb from below]

Board: 4 copper layers, 121.9 x 66.0 mm, 191 parts (56 on the bottom side), 116 nets.
