Tommy270502/PM3/3_Technical_Documents/Microcontroller/PM3_Audio_Light-FW_Template_V1/Firmware/Core/Inc/audio_codec.h

/**
 * @file    audio_codec.h
 * @author  Patrick Rennhard (renn@zhaw.ch)
 * @date    2025-09-24
 * @version 1.0
 * @brief   API for audio codec initialization, SAI/DMA handling, and audio buffer management.
 *
 * DUAL-MODE AUDIO INPUT ARCHITECTURE:
 * ------------------------------------
 * This driver supports two mutually exclusive audio input modes, selected at compile-time:
 *
 * 1. CODEC MODE (default - AUDIO_INPUT_I2S undefined):
 *    - Audio input from external codec via SAI1 Block A (PE3/PE4/PE5)
 *    - Codec provides I2S clock (slave mode)
 *    - Supports mono/stereo detection via ADC on PF8
 *    - DMA2 Stream1 handles reception
 *
 * 2. I2S INPUT MODE (AUDIO_INPUT_I2S defined):
 *    - Audio input from external I2S device via SPI2/I2S2 (PB12-15)
 *    - External device provides I2S clock (slave mode)
 *    - Assumes stereo input (no mono detection)
 *    - DMA1 Stream3 handles reception
 *
 * BOTH MODES:
 * - Output to codec via SAI1 Block B (PE6) and DMA2 Stream5
 * - Use same ping-pong buffer architecture
 * - Process audio as float32_t arrays
 * - Support 24-bit audio in 32-bit I2S frames
 *
 * To enable I2S input mode, uncomment the define below:
 */

//#define AUDIO_INPUT_I2S  // Uncomment to enable external I2S input via PB12-15

#ifndef AUDIO_CODEC_H_
#define AUDIO_CODEC_H_

/******************************************************************************
 * Includes
 *****************************************************************************/
#include "stm32f4xx.h"
#include "arm_math.h"

/******************************************************************************
 * Defines
 *****************************************************************************/
#define AUDIO_FRAME_SIZE 2048
#define AUDIO_CHANNEL_SIZE  (AUDIO_FRAME_SIZE/2) //AUDIO_FRAME_SIZE / 2 = number of samples per left or right channels

#define CODEC_ADC_RES 24
#define CODEC_ADC_REF_VOLTAGE 5

// 984.3750 Hz
#define TEST_AUDIO_FRAME_2048 {0, 0, 34493440, 34493440, 68414976, 68414976, 101202176, 101202176, 132311296, 132311296, 161226752, 161226752, 187469056, 187469056, 210602752, 210602752, 230244864, 230244864, 246069248, 246069248, 257813504, 257813504, 265283328, 265283328, 268354560, 268354560, 266976512, 266976512, 261171456, 261171456, 251036416, 251036416, 236738816, 236738816, 218516224, 218516224, 196670464, 196670464, 171563776, 171563776, 143612416, 143612416, 113279744, 113279744, 81069056, 81069056, 47514112, 47514112, 13171456, 13171456, -21389568, -21389568, -55596032, -55596032, -88880640, -88880640, -120691712, -120691712, -150501376, -150501376, -177815808, -177815808, -202182144, -202182144, -223195904, -223195904, -240509184, -240509184, -253834496, -253834496, -262951168, -262951168, -267708160, -267708160, -268026368, -268026368, -263900416, -263900416, -255398912, -255398912, -242662656, -242662656, -225903104, -225903104, -205398016, -205398016, -181487360, -181487360, -154567424, -154567424, -125084672, -125084672, -93527808, -93527808, -60420608, -60420608, -26311168, -26311168, 8234240, 8234240, 42643200, 42643200, 76345088, 76345088, 108781056, 108781056, 139413504, 139413504, 167734528, 167734528, 193274112, 193274112, 215609344, 215609344, 234369536, 234369536, 249243904, 249243904, 259985664, 259985664, 266416640, 266416640, 268430336, 268430336, 265993472, 265993472, 259145984, 259145984, 248002048, 248002048, 232745984, 232745984, 213630720, 2136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
 * It must be called after power-up to guarantee that the codec starts
 * in a defined state.
 *
 * @note The function should be called before starting audio streaming
 *       or when a codec error condition requires reinitialization.
 */
void codec_reset(void);

/**
 * @brief Initializes the codec and prepares the audio buffers for streaming.
 *
 * This function initializes the GPIOs, including their alternate functions
 * for the SAI interface, and enables the corresponding clock sources for
 * the ports. It also links the provided left and right channel buffers
 * for audio input/output.
 *
 * @param left_channel_buffer Pointer to the buffer for the left audio channel.
 * @param right_channel_buffer Pointer to the buffer for the right audio channel.
 * @param size Number of samples in each channel buffer.
 *
 * @return HAL status code indicating the result of the initialization.
 *         - HAL_OK: Initialization successful.
 *         - HAL_ERROR: Initialization failed.
 *
 * @note Must be called after `codec_reset()` and before `codec_start()`.
 */
HAL_StatusTypeDef codec_init(float32_t *left_channel_buffer,
                             float32_t *right_channel_buffer, uint32_t size);

/**
 * @brief Initializes and starts the SAI interface including DMA.
 *
 * This function configures the Serial Audio Interface (SAI) and the
 * associated DMA channels, then starts the audio data transfer.
 * It also enables the DMA interrupt for data reception, ensuring that
 * incoming audio data is handled properly.
 *
 * The DMA for both reception and transmission is implemented as a
 * ping-pong buffer and operates in endless (cyclic) mode.
 *
 * @note Must be called after codec_reset() to ensure the codec is in
 *       a defined state before starting audio transmission.
 */
void codec_start(void);

/**
 * @brief Checks if new audio data is available from the codec.
 *
 * This function should be called to determine whether the codec has
 * completed a data transfer and new audio samples are ready for
 * processing or copying.
 *
 * @return `true` if new audio data is available, `false` otherwise.
 *
 * @note Typically called immediately after the DMA interrupt or in
 *       the audio processing loop to ensure timely handling of data.
 */
uint8_t codec_data_ready(void);

/**
 * @brief Clears the data ready flag of the codec.
 *
 * This function should be called after polling `codec_data_ready()` and
 * processing the available audio data. It resets the internal flag,
 * allowing the codec and DMA to signal the next set of audio samples.
 *
 * @note Typically used in the audio processing loop immediately after
 *       handling the data.
 */
void codec_clear_data_ready(void);

/**
 * @brief Updates the audio output buffer for a specified channel.
 *
 * This function copies audio samples from the provided buffer into the
 * codec's output buffer for the selected channel. It is typically called
 * after new audio data is available and before the DMA transfers it to
 * the codec.
 *
 * @param channel The target channel to update (0 = left, 1 = right).
 * @param data Pointer to the buffer containing the audio samples to copy.
 * @param size Number of samples to copy from the `data` buffer.
 *
 * @note Should be called as soon as possible after `codec_data_ready()`
 *       returns true to ensure proper synchronization with the DMA transfer.
 */
void codec_update_output_buffer(uint8_t channel, float32_t *data, uint32_t size);

/**
 * @brief Copies the audio samples from the left I²S channel to the right channel.
 *
 * This function duplicates the left channel samples onto the right channel,
 * ensuring that both outputs contain identical audio data. The result is a
 * mono signal derived from the left channel, output to both stereo channels.
 * The function should be called immediately after codec data ready to ensure
 * that the data is copied before it is output.
 */
void codec_mirror_left_channel(void);

/**
 * @brief Checks if the right audio channel input is present based on ADC reading.
 *
 * This function reads the ADC value from PF8 (ADC3_IN6) which is connected to
 * the right audio input channel. It detects whether there is an active signal
 * by measuring deviation from the DC bias level (GND reference). The function
 * uses hysteresis and consecutive reading requirements to prevent false triggering.
 *
 * @return 1 if right channel is active (stereo mode), 0 if only left channel (mono mode).
 *
 * @note This function maintains internal state for hysteresis and requires
 *       multiple consecutive readings before switching modes to ensure stability.
 *       It is designed to be called periodically in the main audio processing loop.
 */
uint8_t codec_is_right_channel_present(void);

#endif
