Tommy270502/PM3/3_Technical_Documents/Microcontroller/PM3_Audio_Light-FW_Template_V1/Firmware/Core/Inc/main.h

/** ***************************************************************************
 * @file
 * @brief See main.c
 *
 *****************************************************************************/

#ifndef MAIN_H_
#define MAIN_H_

/******************************************************************************
 * Includes
 *****************************************************************************/

/******************************************************************************
 * Defines
 *****************************************************************************/
#define NUMBER_OF_COLORS 4
#define MEL_NUMS_MAX	12		///< Must be at least: log2(frequency lines)

/** ***************************************************************************
 * Evalboard revision E (blue PCB)
 * has an inverted y-axis in the touch controller compared to the display.
 * @attention
 * Comment this \#define if you are NOT using evalboard revision E (blue PCB).
 *****************************************************************************/
#define EVAL_REV_E

/** ***************************************************************************
 * Flip LCD = rotate LCD orientation by 180°
 * @attention
 * Comment this \#define if you do NOT want to flip the LCD.
 *****************************************************************************/
// #define FLIPPED_LCD
/******************************************************************************
 * Functions
 *****************************************************************************/

#endif
