Tommy270502/PM3/3_Technical_Documents/Microcontroller/PM3_Audio_Light-FW_Template_V1/Firmware/Core/Inc/pushbutton.h

/** ***************************************************************************
 * @file
 * @brief See pushbutton.c
 *
 * Prefix: PB
 *
 *****************************************************************************/

#ifndef PUSHBUTTON_H_
#define PUSHBUTTON_H_


/******************************************************************************
 * Includes
 *****************************************************************************/
#include <stdbool.h>


/******************************************************************************
 * Defines
 *****************************************************************************/


/******************************************************************************
 * Functions
 *****************************************************************************/
void PB_init(void);
void PB_enableIRQ(void);
bool PB_pressed(void);


#endif
