Tommy270502/PM3/(commit log)

2025-10-03 migrated project
    [Checklist_Marks_2025_V1.xlsx, Component_Orders.xls, DMX_out.kicad_sch, ESP32.kicad_sch, ET-PM3_SW3_Project Management-GanttChart-Template.xlsx, Extension_Connectors.xlsx, JS202011JCQN.stp, OutputVolCtrl.kicad_sch]
2025-10-03 added up do date documents for week 3
    [ET-PM3_SW3_Project Management-GanttChart-Template.xlsx]
2025-10-03 Gant chart update
    [ET-PM3_SW3_Project Management-GanttChart-Template.xlsx]
2025-10-03 new push
    [DMX_out.kicad_sch, ESP32.kicad_sch, OutputVolCtrl.kicad_sch, PM3_Audio_and_DMX.kicad_pcb, Selection_VolCTRL.kicad_sch, analog_power_supply.kicad_sch, audio_input.kicad_sch, audio_output.kicad_sch]
2025-10-03 codec and layout
    [PM3_Audio_and_DMX.kicad_pcb, PM3_Audio_and_DMX.kicad_sch, codec_and_buffers.kicad_sch]
2025-10-04 i2s added
    [ESP32.kicad_sch, PM3_Audio_and_DMX.kicad_sch, microcontroller.kicad_sch]
2025-10-06 pdf schematics and minor visual improvements
    [OutputVolCtrl.kicad_sch]
2025-10-09 rework esp32, codec and layout
    [DMX_out.kicad_sch, ESP32.kicad_sch, PM3_Audio_and_DMX.kicad_pcb, analog_power_supply.kicad_sch, audio_input.kicad_sch, audio_output.kicad_sch, codec_and_buffers.kicad_sch, digital_power_supply.kicad_sch]
2025-10-09 more layout
    [PM3_Audio_and_DMX.kicad_pcb]
2025-10-10 updated capacitors
    [PM3_Audio_and_DMX.kicad_pcb, audio_input.kicad_sch, audio_output.kicad_sch]
2025-10-10 minor modifications to esp32 bootmodes
    [ESP32.kicad_sch, PM3_Audio_and_DMX.kicad_pcb]
2025-10-11 esp-stm connection (+ conflict recolution)
    [Component_Orders.xls, ESP32.kicad_sch, PM3_Audio_and_DMX.kicad_pcb, PM3_Audio_and_DMX.kicad_sch, PM3_Audio_pre_ordered_components.xlsx, audio_input.kicad_sch, audio_output.kicad_sch, codec_and_buffers.kicad_sch]
2025-10-13 layout complete
    [DMX_out.kicad_sch, ESP32.kicad_sch, OutputVolCtrl.kicad_sch, PM3_Audio_and_DMX.kicad_pcb, PM3_Audio_and_DMX.kicad_sch, Selection_VolCTRL.kicad_sch, analog_power_supply.kicad_sch, audio_input.kicad_sch]
2025-10-13 layout fix
    [PM3_Audio_and_DMX.kicad_pcb]
2025-10-13 added 3d models
    [PM3_Audio_and_DMX.kicad_pcb]
2025-10-13 finalized design and generated gerber
    [ESP32.kicad_sch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]
2025-10-14 Amutec und Bmutec left floating
    [codec_and_buffers.kicad_sch]
2025-10-14 reqorked pcb
    [PM3_Audio_and_DMX.kicad_pcb, codec_and_buffers.kicad_sch]
2025-10-14 final design
    [PM3_Audio_and_DMX.kicad_pcb]
2025-10-14 added updated gerber/drill files
    [PM3_Audio_and_DMX-B_Cu.gbr, PM3_Audio_and_DMX-B_Mask.gbr, PM3_Audio_and_DMX-B_Paste.gbr, PM3_Audio_and_DMX-B_Silkscreen.gbr, PM3_Audio_and_DMX-Edge_Cuts.gbr, PM3_Audio_and_DMX-F_Cu.gbr, PM3_Audio_and_DMX-F_Mask.gbr, PM3_Audio_and_DMX-F_Paste.gbr]
2025-10-14 old gerber zip removed
2025-10-15 fixed pcb, again.
    [PM3_Audio_and_DMX.kicad_pcb]
2025-10-15 finalized hardware
    [PM3_Audio_and_DMX-B_Cu.gbr, PM3_Audio_and_DMX-B_Mask.gbr, PM3_Audio_and_DMX-B_Paste.gbr, PM3_Audio_and_DMX-B_Silkscreen.gbr, PM3_Audio_and_DMX-Edge_Cuts.gbr, PM3_Audio_and_DMX-F_Cu.gbr, PM3_Audio_and_DMX-F_Mask.gbr, PM3_Audio_and_DMX-F_Paste.gbr]
2025-10-15 final final
    [PM3_Audio_and_DMX-B_Cu.gbr, PM3_Audio_and_DMX-B_Mask.gbr, PM3_Audio_and_DMX-B_Paste.gbr, PM3_Audio_and_DMX-B_Silkscreen.gbr, PM3_Audio_and_DMX-Edge_Cuts.gbr, PM3_Audio_and_DMX-F_Cu.gbr, PM3_Audio_and_DMX-F_Mask.gbr, PM3_Audio_and_DMX-F_Paste.gbr]
2025-10-15 resolved todo's in audio_codec
    [audio_codec.c, audio_codec.h]
2025-10-17 forgot programming pins txd rxd esp32
    [ESP32.kicad_sch]
2025-10-17 worked on test cases and added current consumption sheet
    [CurrenConsumption.xlsx]
2025-10-18 added esp32 firmware template
2025-10-24 added new document versions
    [Checklist_Marks_2025_V2.xlsx, Measurement_Table_Template.xlsx]
2025-10-24 interactive bom
2025-10-25 updated measurement table template
    [Measurement_Table_Template.xlsx]
2025-10-25 schematics, layout and bom updated (to match corrections)
    [DMX_out.kicad_sch, PM3_Audio_and_DMX.kicad_pcb, PM3_Audio_and_DMX.kicad_sch, analog_power_supply.kicad_sch, audio_input.kicad_sch, audio_output.kicad_sch, headphone_amp.kicad_sch, mic_input.kicad_sch]
2025-11-07 comments in schematics
    [codec_and_buffers.kicad_sch]
2025-11-07 hw testing (wip)
    [CurrenConsumption.xlsx, CurrentConsumption.xlsx, Measurement_Table_Template.xlsx]
2025-11-07 setup environment on new laptop successfull build of project for esp32
2025-11-07 hw report updated + gitignore
    [Measurement_Table_Template.xlsx]
2025-11-08 hw report wip
    [Measurement_Table_Template.xlsx]
2025-11-08 hw report some more wip
    [Measurement_Table_Template.xlsx]
2025-11-13 simulation updated to match new resistor values
2025-11-14 PCB fixes image
2025-11-14 hw report - done
    [Measurement_Table_Template.xlsx]
2025-11-14 testing report - done
    [Measurement_Table_Template.xlsx]
2025-11-16 added frequency sweep description and also pictures for the modifications carried out to pcb
2025-11-21 new timeline version, old versions removed
    [Checklist_Marks_2025_V1.xlsx]
2025-11-28 implement standalone code-esp
    [PM3_Audio_and_DMX.kicad_pcb, PM3_Audio_and_DMX.kicad_sch, audio_input.kicad_sch, codec_and_buffers.kicad_sch]
2025-11-28 mono-stereo switching
2025-12-04 add over the air updates esp32
2025-12-04 combined OTA with BT sink and I2C over to STM32
    [custom_partition.csv]
2025-12-04 stm32 recieve i2s from esp32
2025-12-05 checklist mark document updated
    [Checklist_Marks_2025_V2.xlsx, Checklist_Marks_2025_V3.xlsx]
2025-12-05 graded excel test report added
    [Measurement_Table_Perri_Grebnevs.xlsx]
2025-12-10 worked on esp32-stm32-codec
2025-12-12 added low pass filter
2025-12-12 added filters
2025-12-19 multiple filters added and menu apdated accordingly
2026-01-21 finished powerpoint
